DinoDubroja/Power-amplifier/PCB/Mains wiring/fuse holder.jpg

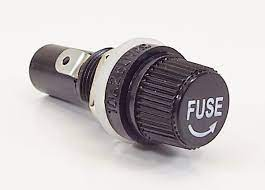
PCB/Mains wiring/fuse holder.jpg
