DinoDubroja/Power-amplifier/PCB/Mains wiring/panfh-1.webp

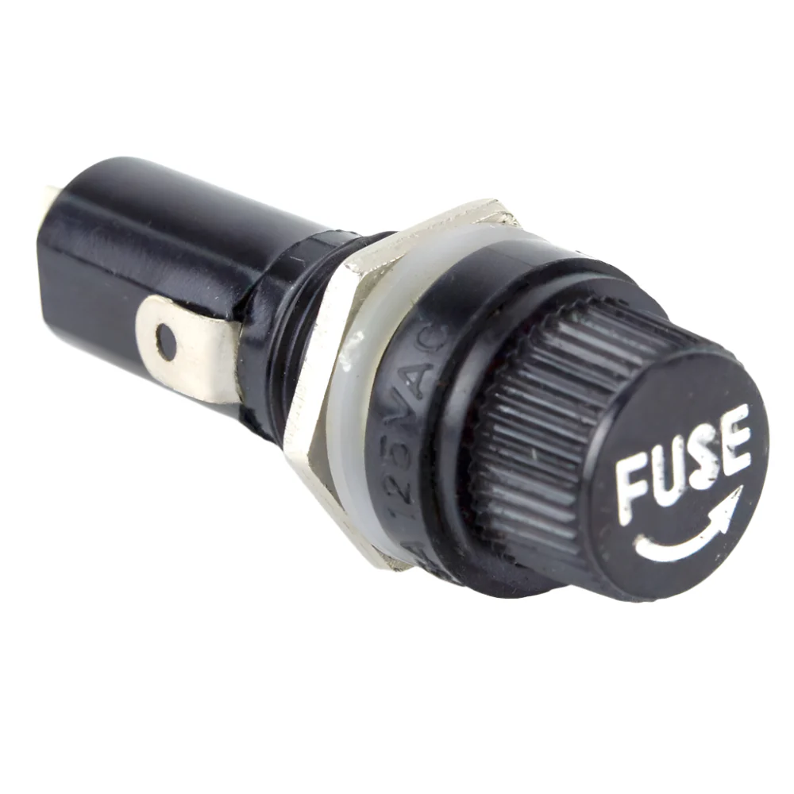
PCB/Mains wiring/panfh-1.webp
