DinoDubroja/Power-amplifier/README.md

# Power-amplifier
A general purpose power amplifier for lab use.
