DinoDubroja/Power-amplifier/PCB/Power supply/calculations.pdf

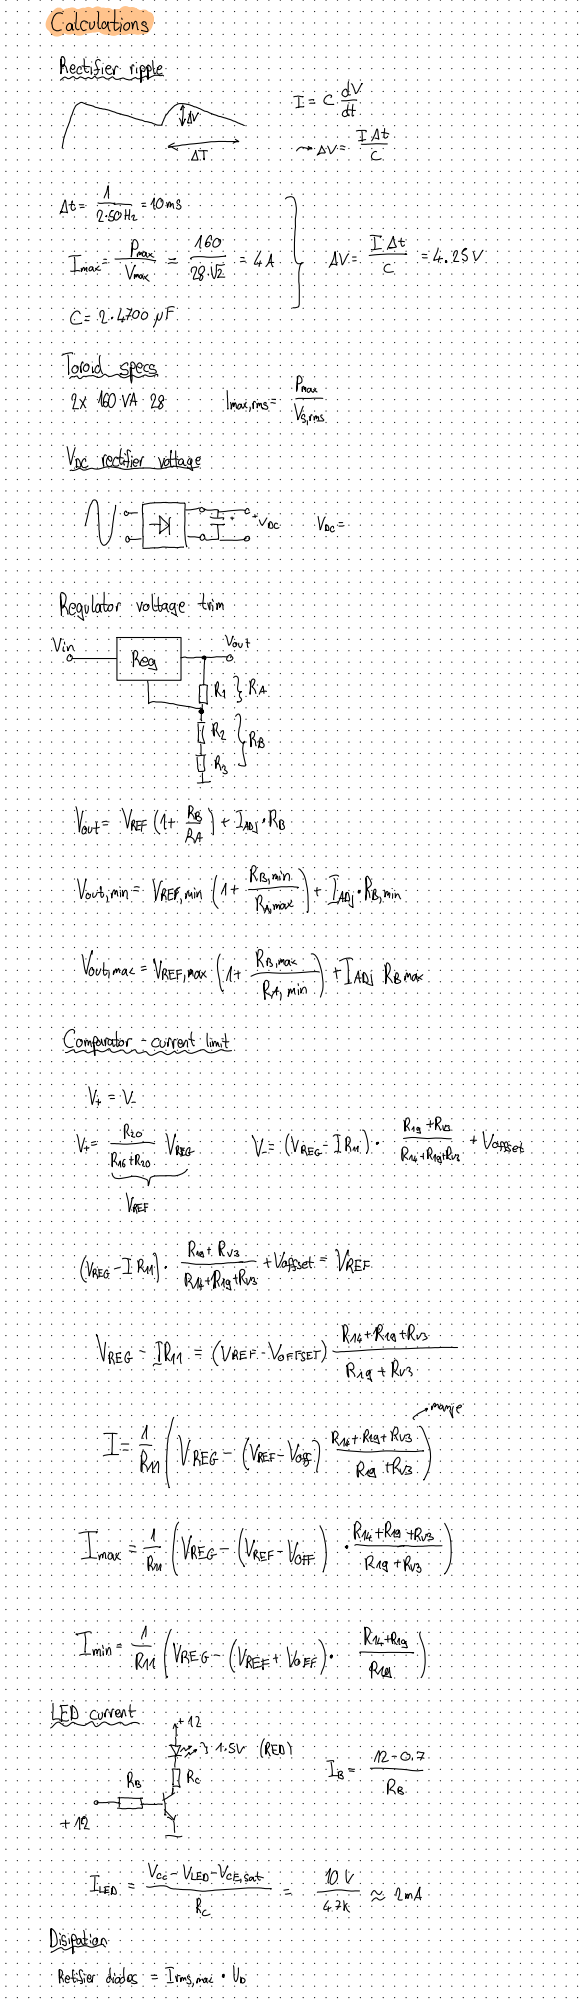
[picture p3: page 1]
