DinoDubroja/Power-amplifier/Mechanical/Drawings/front panel mat.jpeg

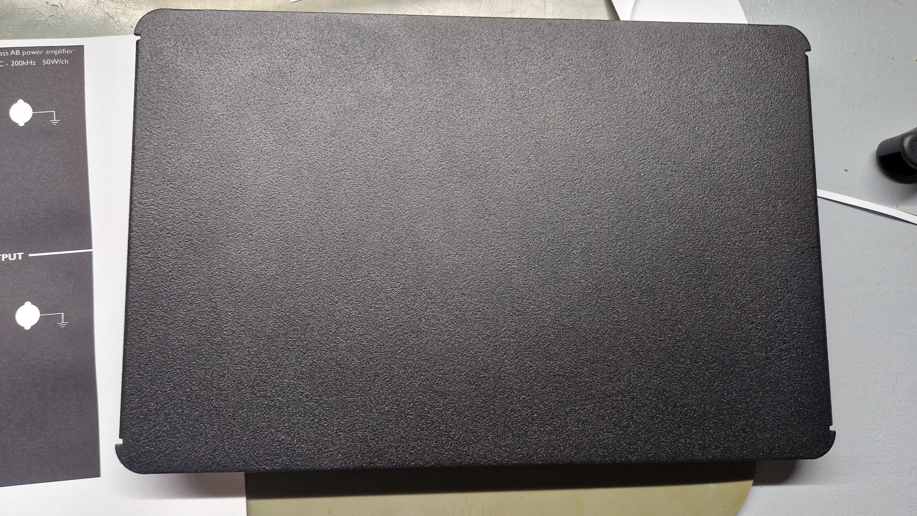
Mechanical/Drawings/front panel mat.jpeg
