DinoDubroja/Power-amplifier/PCB/Amplifier/AMPLIFIER - TRANSISTOR BLOCKS.png

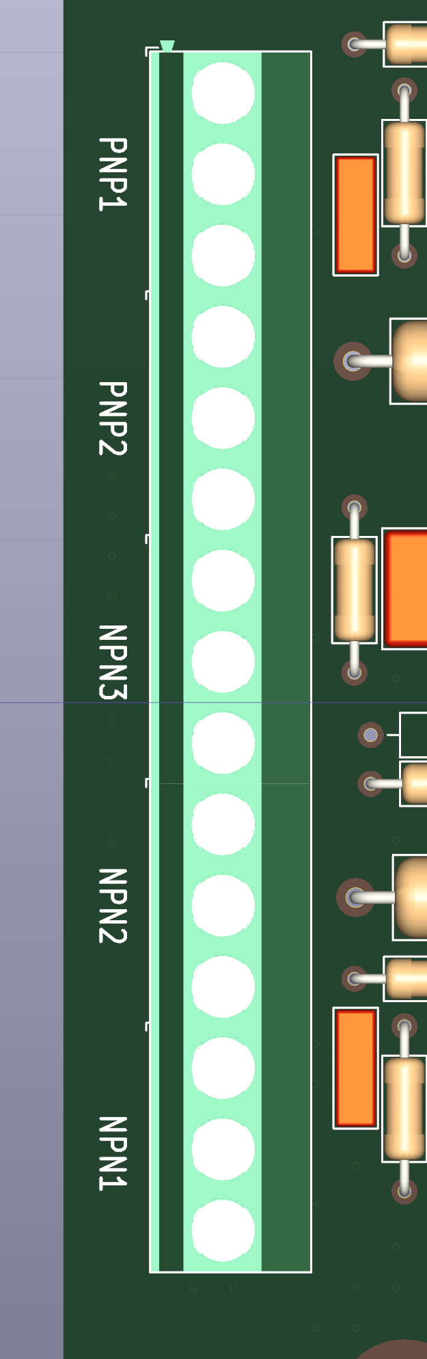
PCB/Amplifier/AMPLIFIER - TRANSISTOR BLOCKS.png
