DinoDubroja/Power-amplifier/PCB/Amplifier/BD139_140.jpg

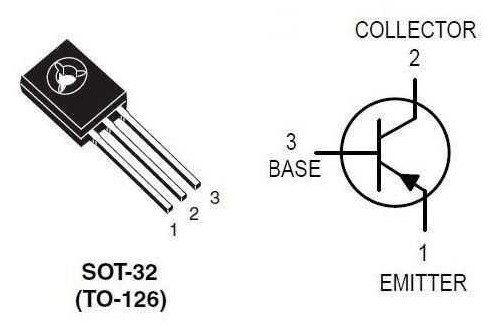
PCB/Amplifier/BD139_140.jpg
