DinoDubroja/Power-amplifier/PCB/Amplifier/FAN CONNECTOR.png

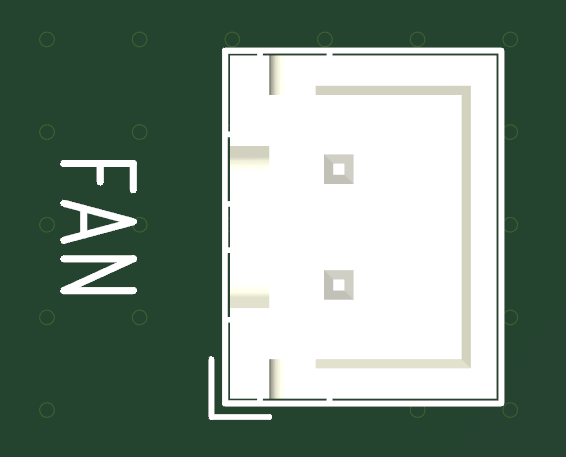
PCB/Amplifier/FAN CONNECTOR.png
