DinoDubroja/Power-amplifier/PCB/Amplifier/PSU - TRANSISTOR BLOCKS.png

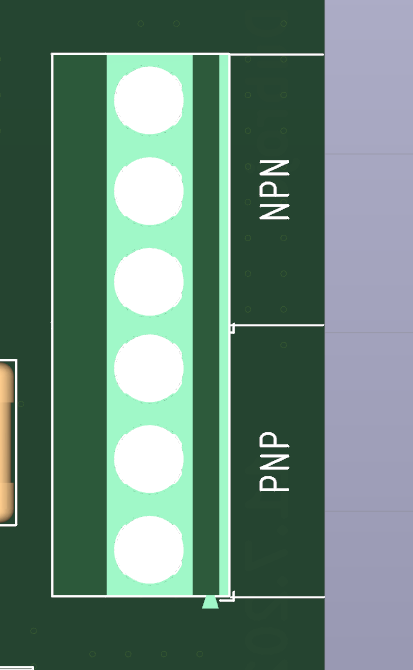
PCB/Amplifier/PSU - TRANSISTOR BLOCKS.png
