DinoDubroja/Power-amplifier/PCB/Amplifier/TIP35_36.png

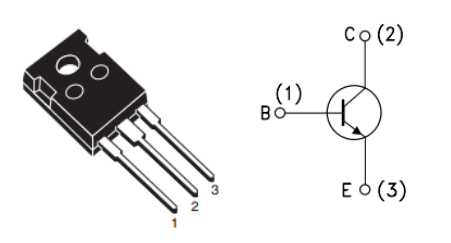
PCB/Amplifier/TIP35_36.png
