DinoDubroja/Power-amplifier/PCB/Amplifier/XHP-4.jpg

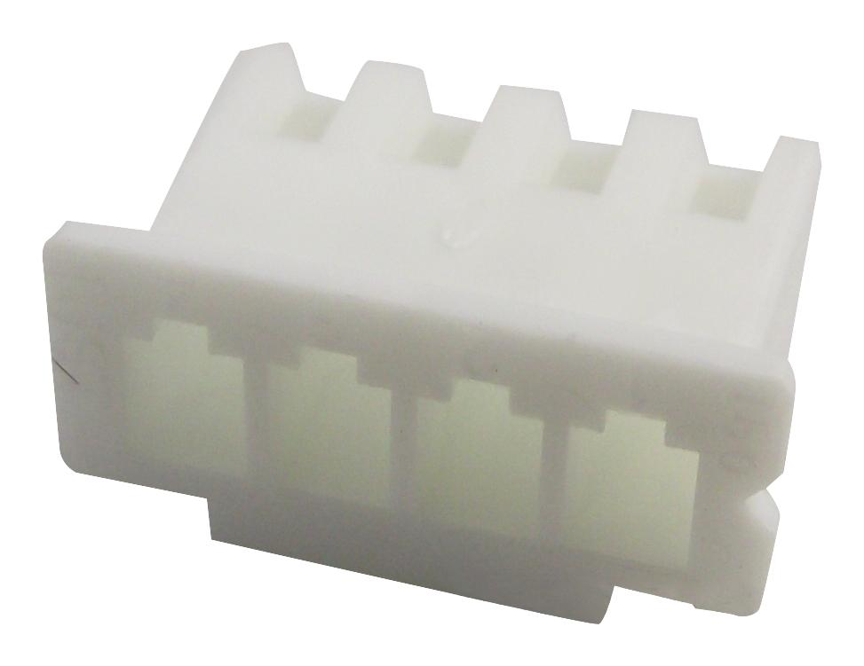
PCB/Amplifier/XHP-4.jpg
