DinoDubroja/Power-amplifier/Pictures/Amplifier BODE/Closed loop - TIP35_36.png

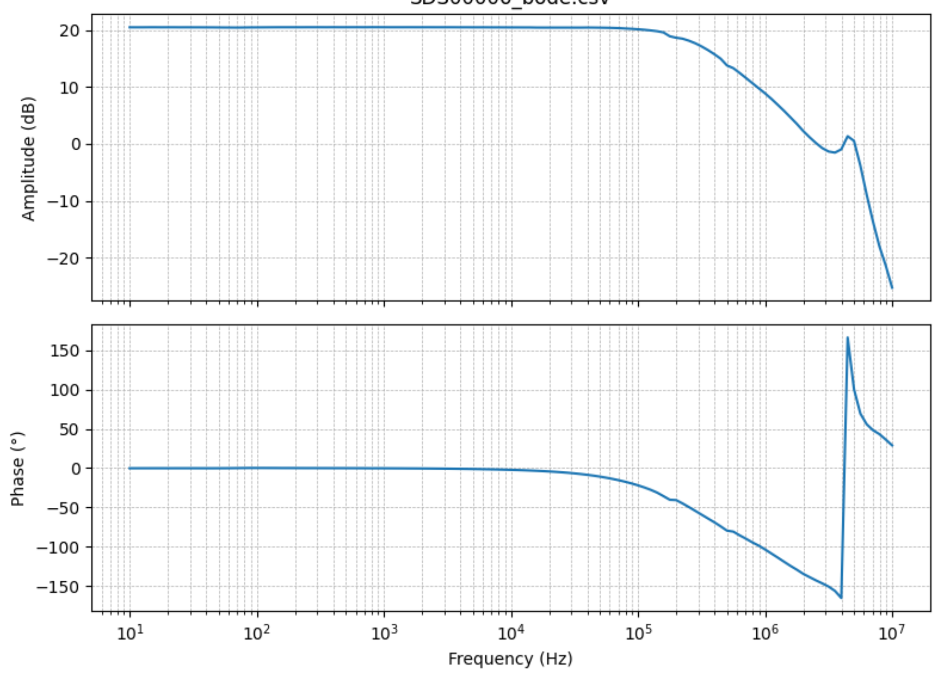
Pictures/Amplifier BODE/Closed loop - TIP35_36.png
