DinoDubroja/Power-amplifier/Pictures/circuit1.png

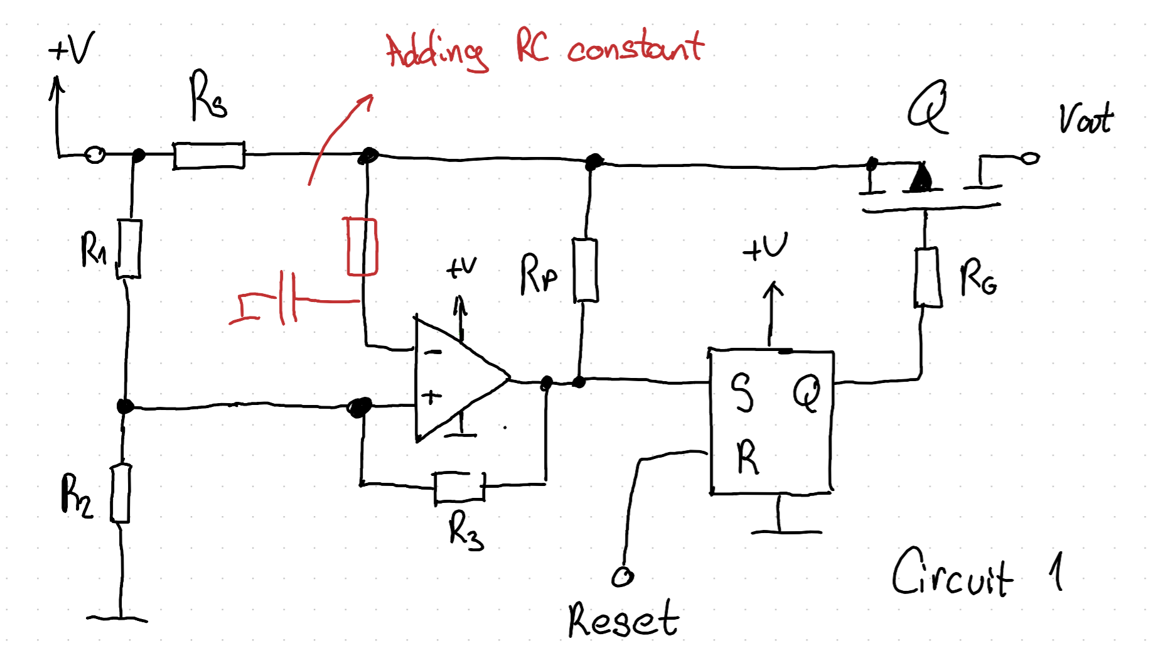
Pictures/circuit1.png
