DinoDubroja/Power-amplifier/Pictures/circuit1_values.png

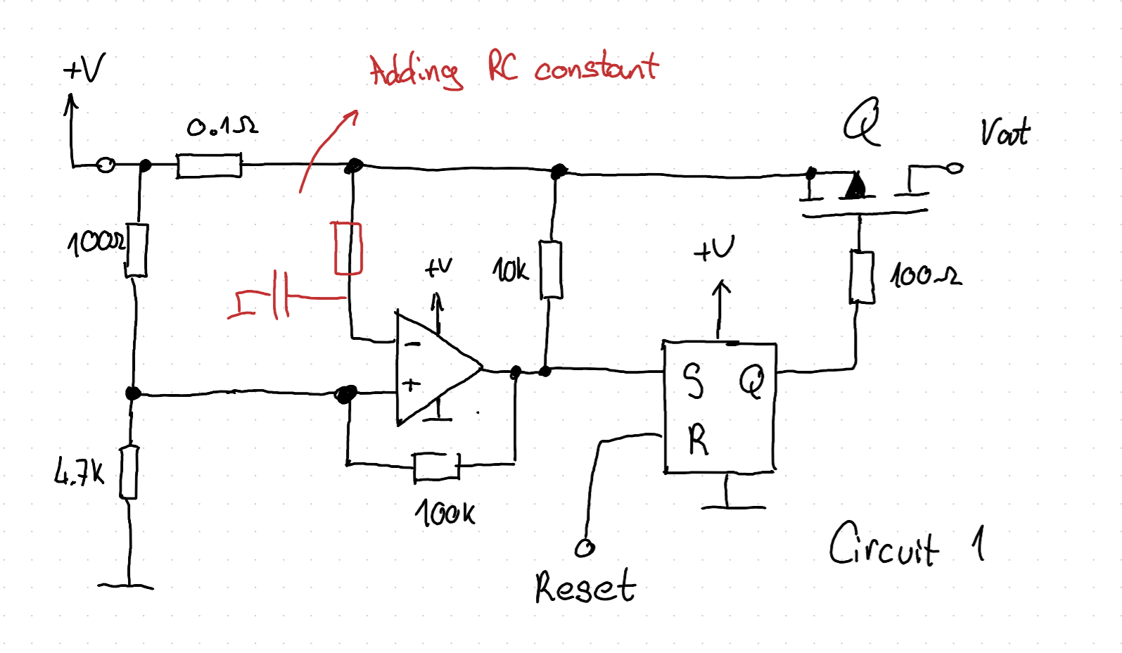
Pictures/circuit1_values.png
