DinoDubroja/Power-amplifier/Pictures/circuit2.png

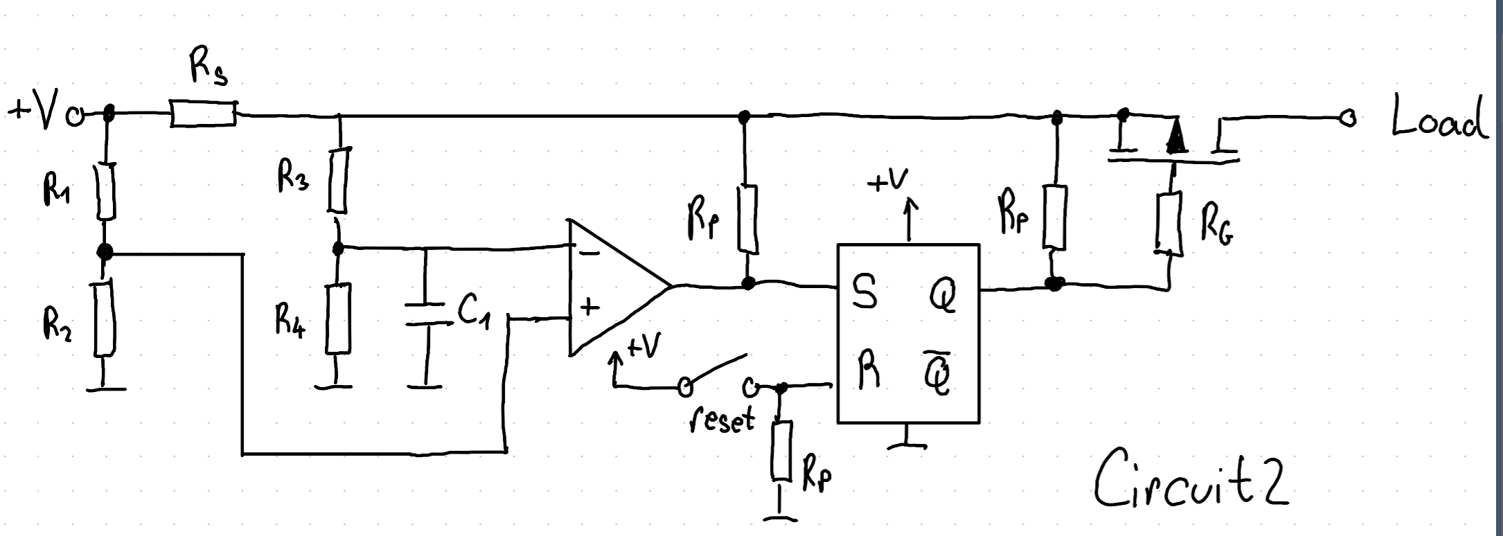
Pictures/circuit2.png
