DinoDubroja/Power-amplifier/Pictures/circuit2_values.png

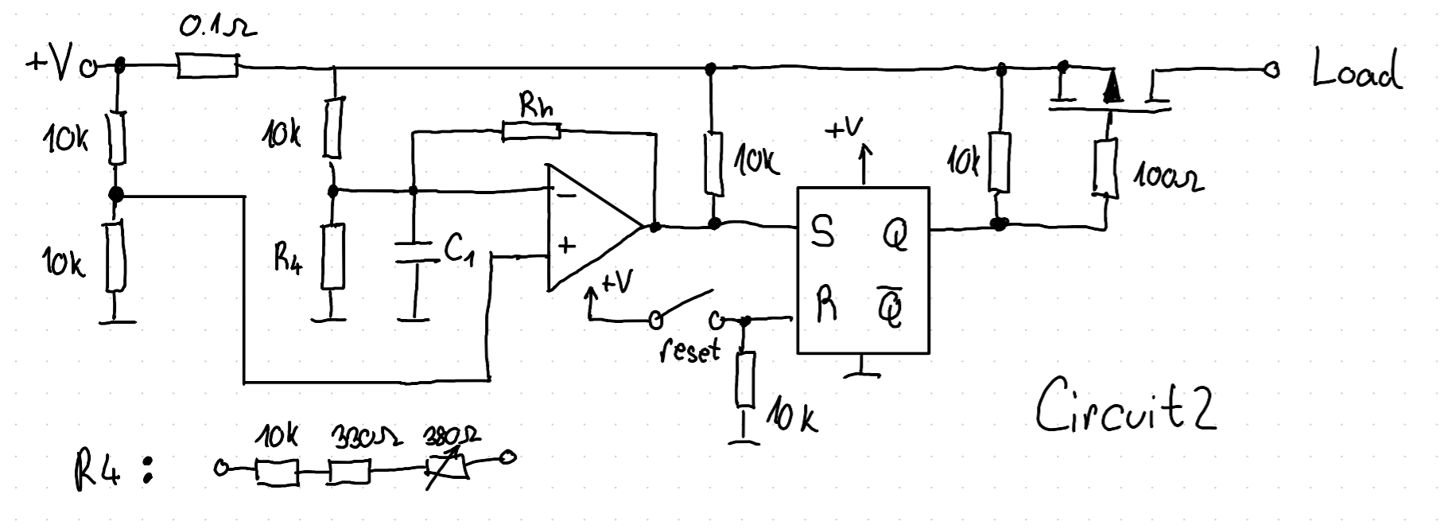
Pictures/circuit2_values.png
