DinoDubroja/Power-amplifier/Pictures/Enclosure - render1.png

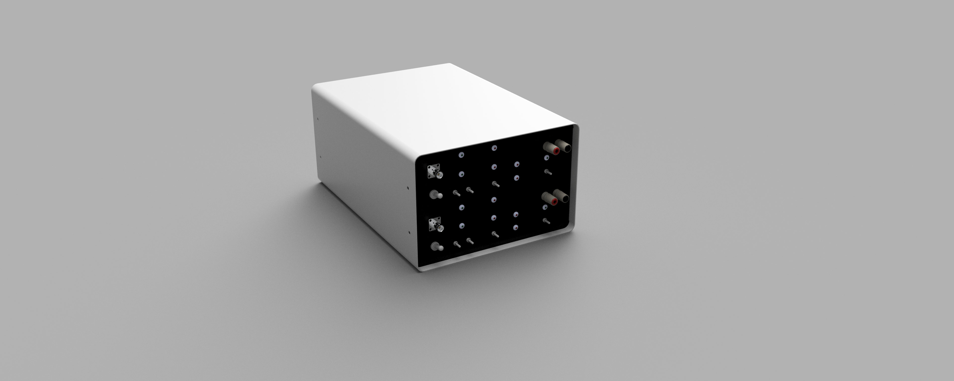
Pictures/Enclosure - render1.png
