DinoDubroja/Power-amplifier/Pictures/Enclosure - render 2.png

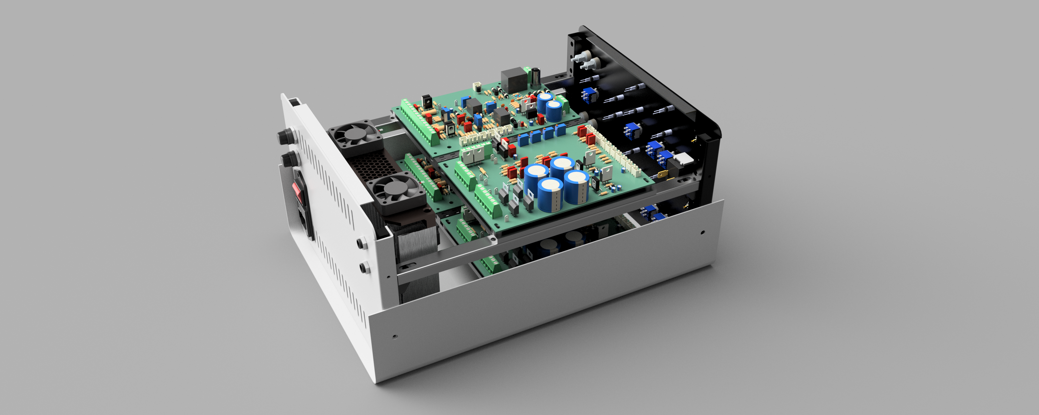
Pictures/Enclosure - render 2.png
