DinoDubroja/Power-amplifier/Pictures/regulator PCB.png

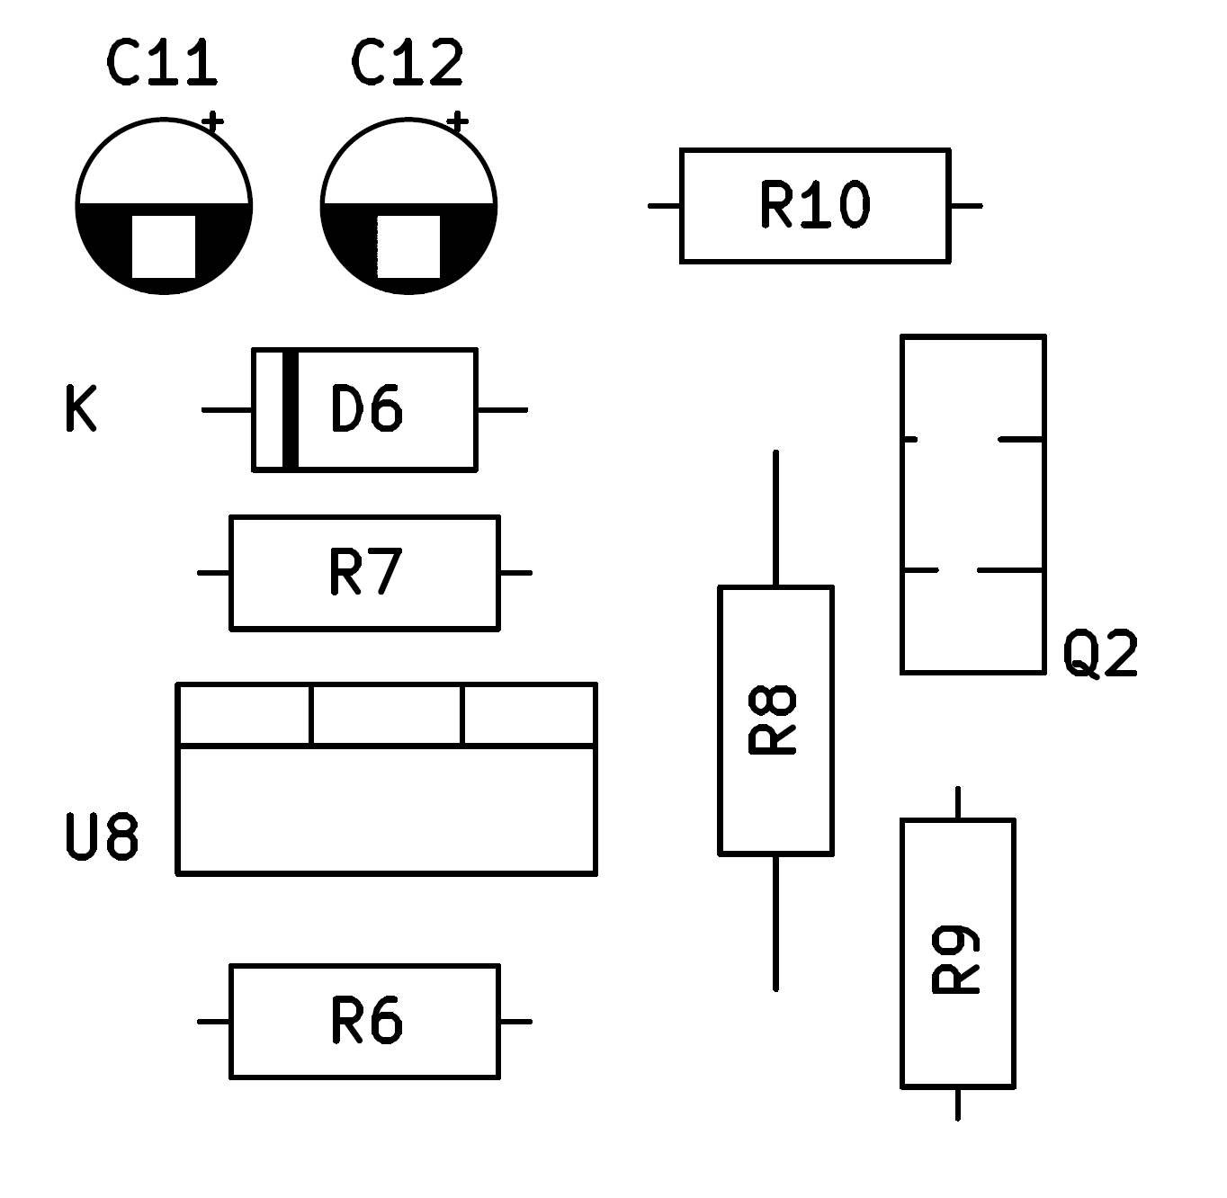
Pictures/regulator PCB.png
