DinoDubroja/Power-amplifier/Mechanical/3D printed parts/Mounting plate.3mf

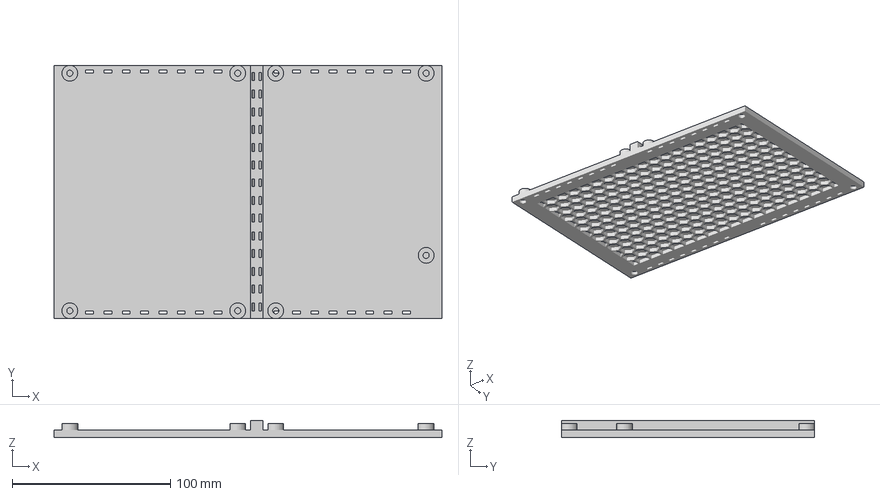
[picture p19: CAD file, 2025-10-12]
Mechanical/3D printed parts/Mounting plate.3mf
245.0 x 160.0 x 11.0 mm
