DinoDubroja/Power-amplifier/Mechanical/Drawings/front panel test.dxf

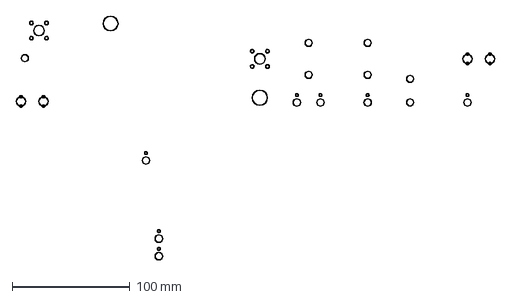
[picture p20: CAD file, 2025-10-12]
Mechanical/Drawings/front panel test.dxf
405.7 x 206.9 mm
