DinoDubroja/Power-amplifier/Mechanical/Models/10x-30a-high-current-m5-4mm-female-banana-jack-socket-test-binding-post-welding-plug-connector-1.snapshot.2/High Current M5 4mm Female Banana Jack.SLDPRT

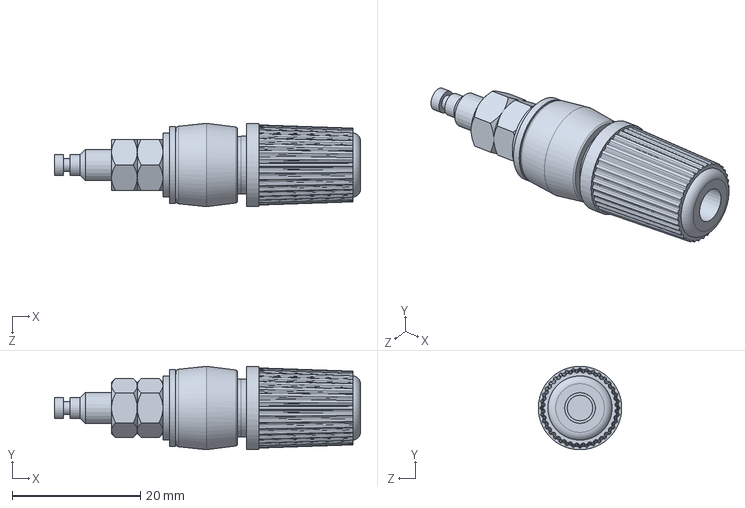
[picture p21: CAD file, 2025-10-12]
Mechanical/Models/10x-30a-high-current-m5-4mm-female-banana-jack-socket-test-binding-post-welding-plug-connector-1.snapshot.2/High Current M5 4mm Female Banana Jack.SLDPRT
47.7 x 13.0 x 13.0 mm
