DinoDubroja/Power-amplifier/Mechanical/Models/1427J/1427J.stp

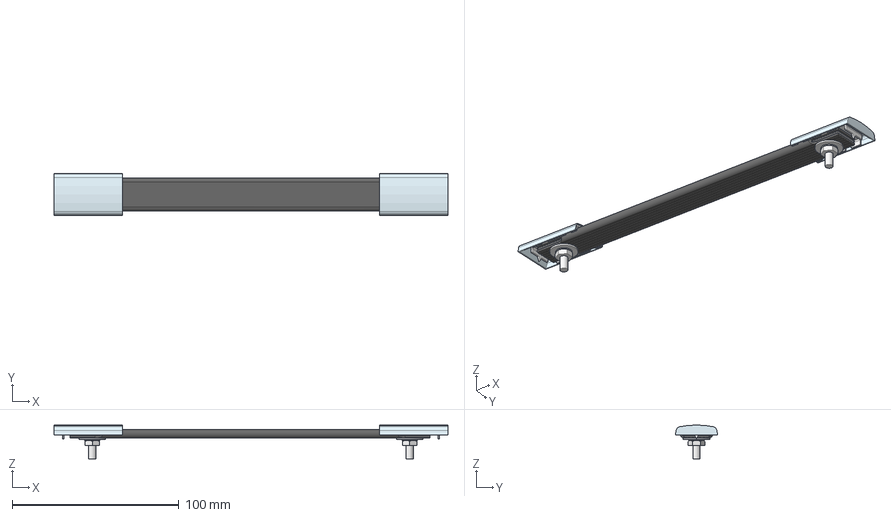
[picture p23: CAD file, 2025-10-12]
Mechanical/Models/1427J/1427J.stp
236.5 x 25.4 x 20.3 mm
1427J - core
1427J - vinyl
1427J - insert x 2
washer2 x 2
lockwasher2 x 2
8-32 nut x 2
1427J - cover x 2
