DinoDubroja/Power-amplifier/Mechanical/Models/Busbar.step

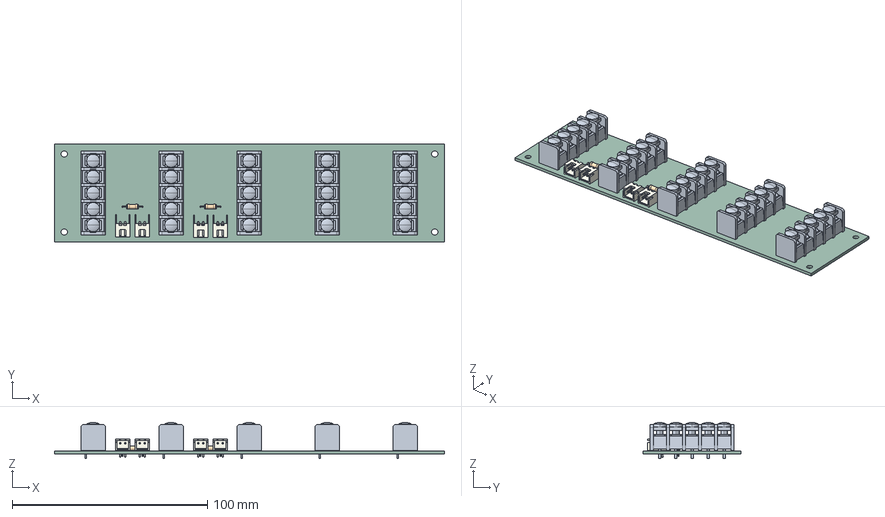
[picture p24: CAD file, 2025-10-12]
Mechanical/Models/Busbar.step
200.0 x 50.0 x 18.5 mm
R_Axial_DIN0207_L63mm_D25mm_P1016mm_Horizontal x 2
C-2-1437667-8 x 5
JST_S2B_XH_A_1 x 4
Busbar_PCB
