DinoDubroja/Power-amplifier/Mechanical/Models/LIB_031-203-RFX/031-203-RFX/3D/031-203-RFX.stp

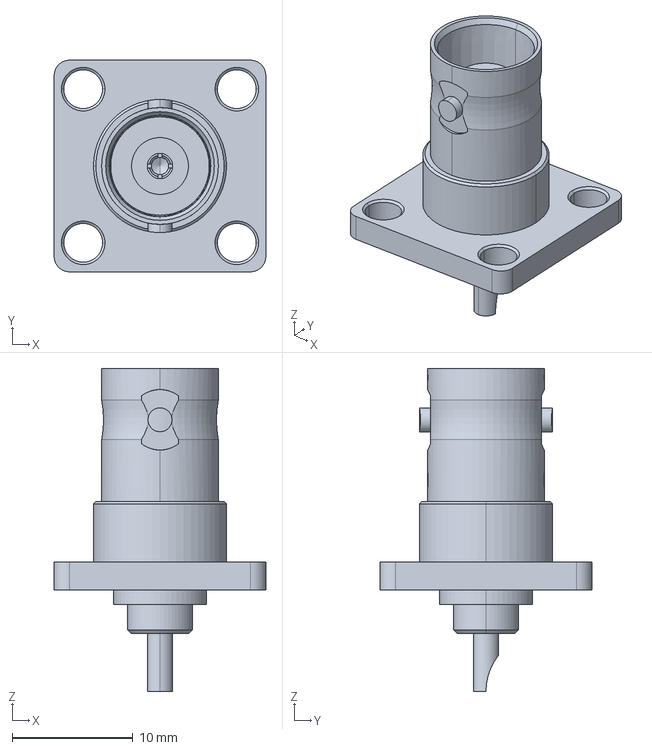
[picture p25: CAD file, 2025-10-12]
Mechanical/Models/LIB_031-203-RFX/031-203-RFX/3D/031-203-RFX.stp
17.5 x 17.5 x 26.7 mm
