DinoDubroja/Power-amplifier/Mechanical/Models/LIB_4DB-P108-05/4DB-P108-05/3D/4DB-P108-05.stp

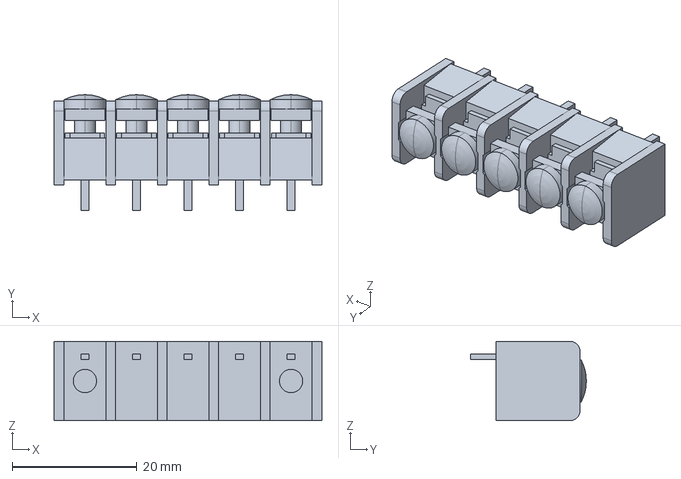
[picture p26: CAD file, 2025-10-12]
Mechanical/Models/LIB_4DB-P108-05/4DB-P108-05/3D/4DB-P108-05.stp
42.9 x 18.5 x 12.7 mm
