DinoDubroja/Power-amplifier/Mechanical/Models/LIB_H-83P/H-83P/3D/H-83P.stp

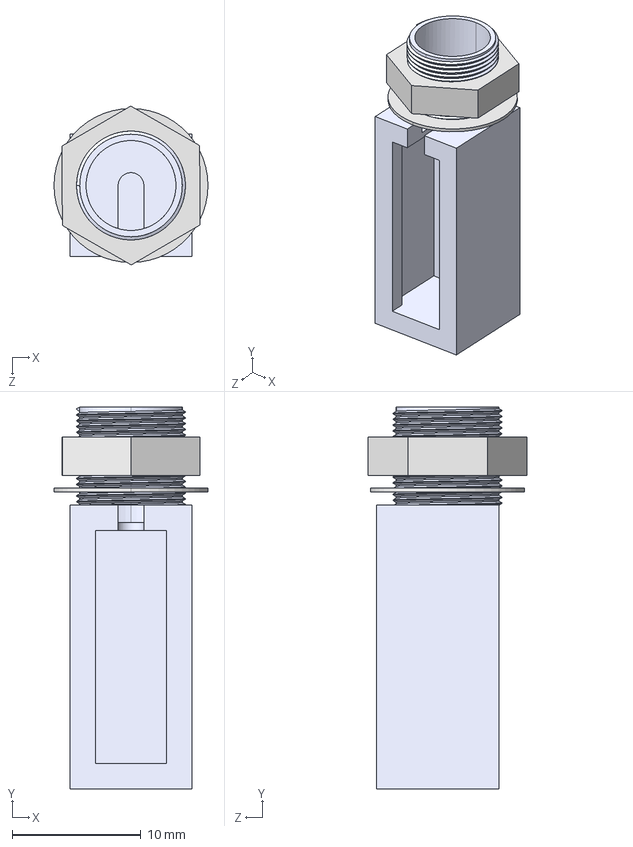
[picture p27: CAD file, 2025-10-12]
Mechanical/Models/LIB_H-83P/H-83P/3D/H-83P.stp
12.0 x 29.7 x 12.4 mm
