DinoDubroja/Power-amplifier/Mechanical/Models/LIB_MPC3BWD/MPC3BWD/3D/MPC3BWD.stp

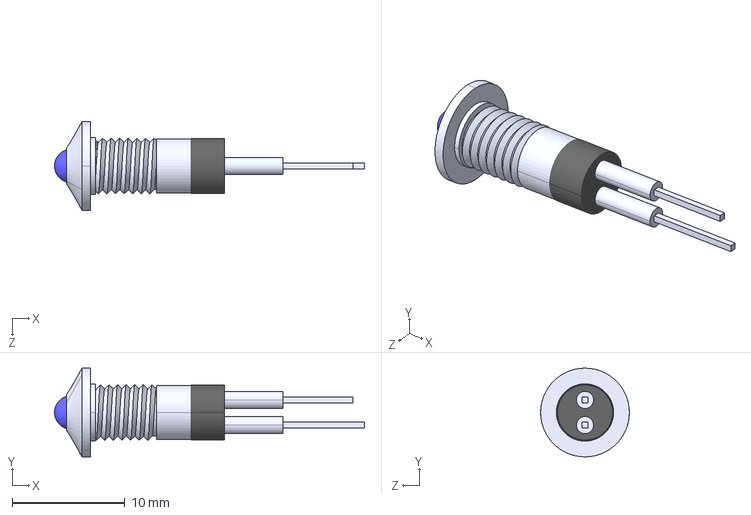
[picture p28: CAD file, 2025-10-12]
Mechanical/Models/LIB_MPC3BWD/MPC3BWD/3D/MPC3BWD.stp
27.5 x 7.87 x 7.87 mm
