DinoDubroja/Power-amplifier/Mechanical/Models/LIB_R3-12-12-B/R3-12-12-B/3D/R3-12-12-B.stp

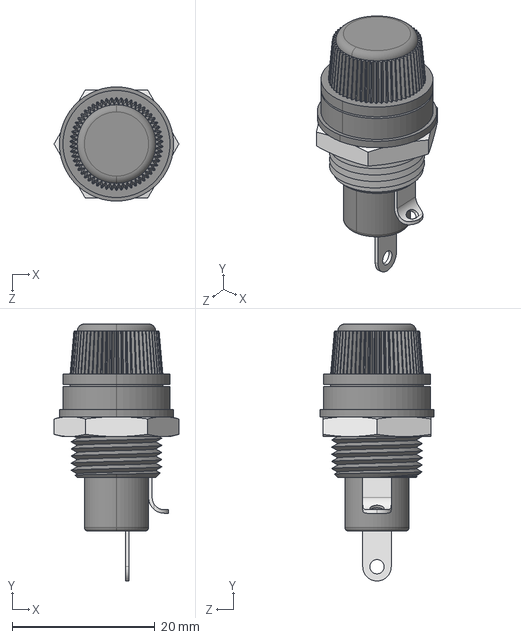
[picture p29: CAD file, 2025-10-12]
Mechanical/Models/LIB_R3-12-12-B/R3-12-12-B/3D/R3-12-12-B.stp
17.5 x 36.0 x 16.0 mm
