DinoDubroja/Power-amplifier/Mechanical/Models/LIB_SW-T2-3A-A-A2-M2/SW-T2-3A-A-A2-M2/3D/SW-T2-3A-A-A2-M2.stp

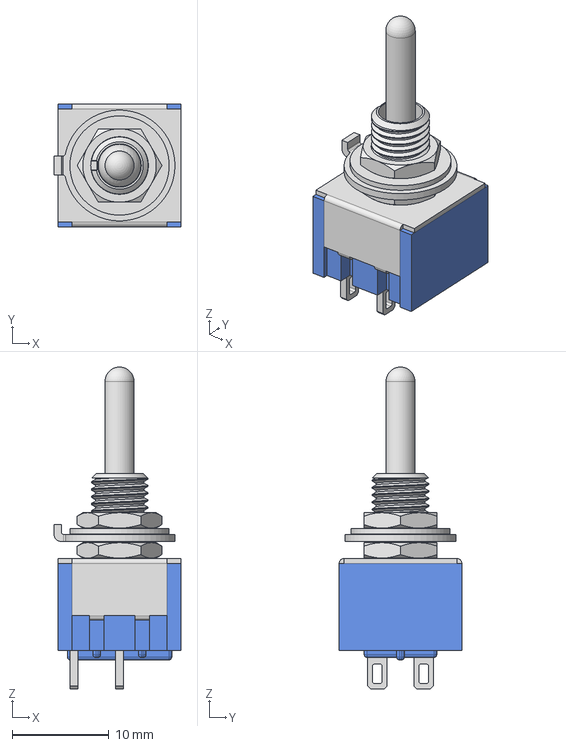
[picture p30: CAD file, 2025-10-12]
Mechanical/Models/LIB_SW-T2-3A-A-A2-M2/SW-T2-3A-A-A2-M2/3D/SW-T2-3A-A-A2-M2.stp
13.1 x 12.7 x 33.3 mm
