DinoDubroja/Power-amplifier/PCB/Amplifier/Amplifier/Amplifier.step

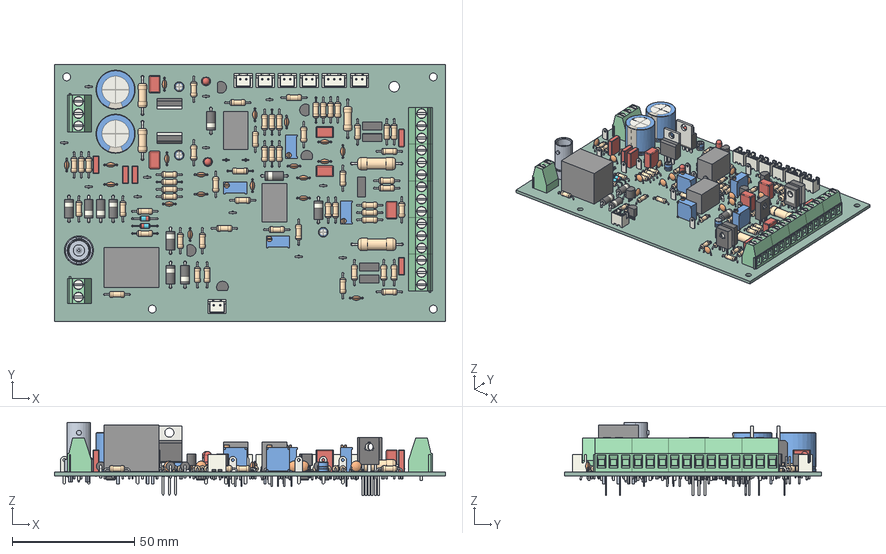
[picture p31: CAD file, 2025-10-12]
PCB/Amplifier/Amplifier/Amplifier.step
160.0 x 105.0 x 30.0 mm
JST_B2B_XH_A x 6
Potentiometer_Bourns_3296W_Vertical x 4
R_Axial_DIN0207_L63mm_D25mm_P1016mm_Horizontal x 56
C_Disc_D43mm_W19mm_P500mm x 19
LED_D3.0mm x 2
C_Rect_L72mm_W25mm_P500mm_FKS2_FKP2_MKS2_MKP2 x 5
TO-126-3_Vertical x 5
D_DO-15_P10.16mm_Horizontal x 10
D_DO-35_SOD27_P10.16mm_Horizontal x 2
C_Rect_L72mm_W45mm_P500mm_FKS2_FKP2_MKS2_MKP2 x 5
TerminalBlock_Phoenix_MKDS_15_3_1x03_P500mm_Horizontal x 6
ASSEMBLY x 3
Pin_d1.2mm_L11.3mm_W3.0mm_Flat x 14
TO-92_Inline_Narrow x 5
R_Axial_DIN0516_L155mm_D50mm_P2032mm_Horizontal x 2
TO-220-3_Vertical x 2
C-5222006-01-3
TerminalBlock_Phoenix_MKDS_15_2_508_1x02_P508mm_Horizontal
CP_Radial_D160mm_P750mm x 2
JST_B3B_XH_A
CP_Radial_D40mm_P200mm x 3
R_Axial_DIN0411_L99mm_D36mm_P1524mm_Horizontal x 3
D0008A_ASM x 3
SOIC_8_39x49mm_P127mm
Amplifier_PCB
