DinoDubroja/Power-amplifier/PCB/Power supply/Power supply/Power supply.step

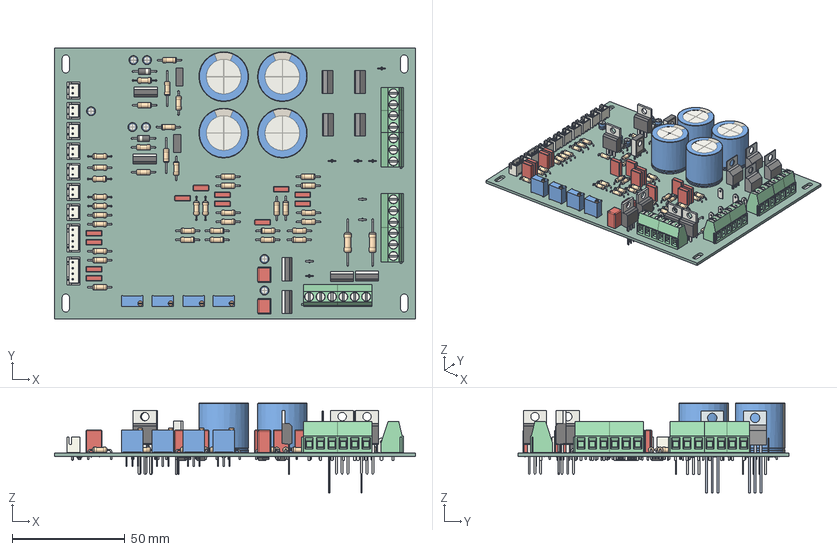
[picture p32: CAD file, 2025-10-12]
PCB/Power supply/Power supply/Power supply.step
160.0 x 120.0 x 39.8 mm
R_Axial_DIN0207_L63mm_D25mm_P1016mm_Horizontal x 38
CP_Radial_D40mm_P200mm x 7
Potentiometer_Bourns_3296W_Vertical x 4
C_Rect_L70mm_W60mm_P500mm x 2
TerminalBlock_Phoenix_MKDS_15_3_508_1x03_P508mm_Horizontal x 5
Pin_d1.3mm_L10.0mm_W3.5mm_Flat x 8
JST_B4B_XH_A x 2
C_Rect_L70mm_W25mm_P500mm x 12
TO-220-3_Vertical x 6
D_A-405_P10.16mm_Horizontal x 2
CP_Radial_D220mm_P1000mm_SnapIn x 4
JST_B2B_XH_A x 7
R_Axial_DIN0207_L63mm_D25mm_P1524mm_Horizontal x 2
ASSEMBLY x 4
R_Axial_DIN0309_L90mm_D32mm_P2032mm_Horizontal x 2
TO-126-3_Vertical x 2
TerminalBlock_Phoenix_MKDS_15_2_508_1x02_P508mm_Horizontal x 2
D0014A_ASM x 2
SOT_23 x 4
SOIC_8_39x49mm_P127mm x 2
Power supply_PCB
