DinoDubroja/Power-amplifier/Mechanical/3D printed parts/THERMAL FUSE HOLDER.3mf

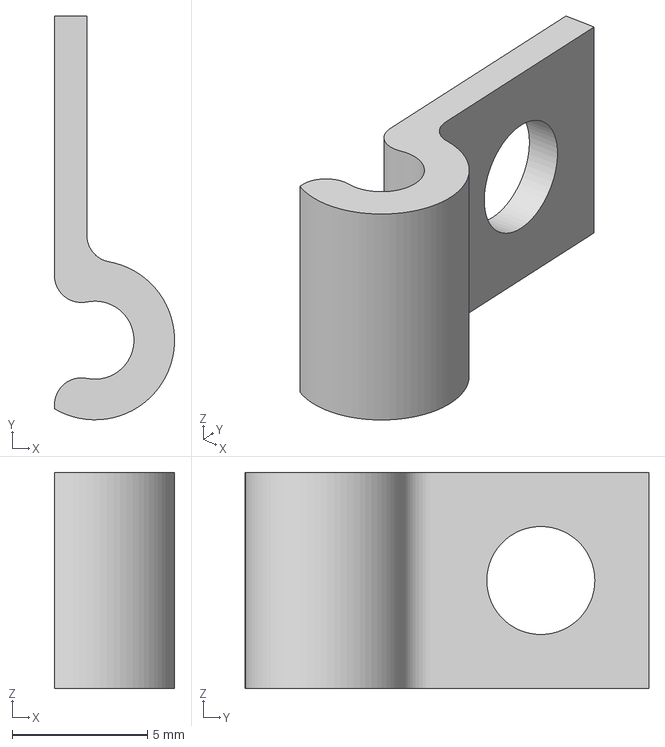
[picture p33: CAD file, 2025-10-12]
Mechanical/3D printed parts/THERMAL FUSE HOLDER.3mf
4.45 x 14.9 x 8.00 mm
