DinoDubroja/Power-amplifier/Mechanical/Drawings/front panel.dxf

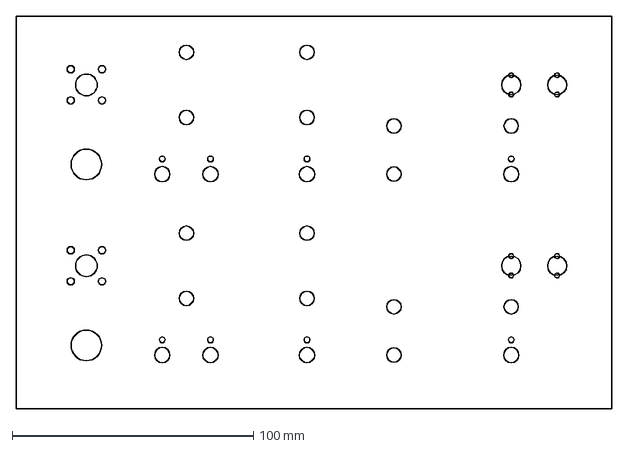
[picture p34: CAD file, 2025-10-12]
Mechanical/Drawings/front panel.dxf
246.7 x 162.7 mm
