DinoDubroja/Power-amplifier/Mechanical/Models/1401K/1401K - Vented Panel.stp

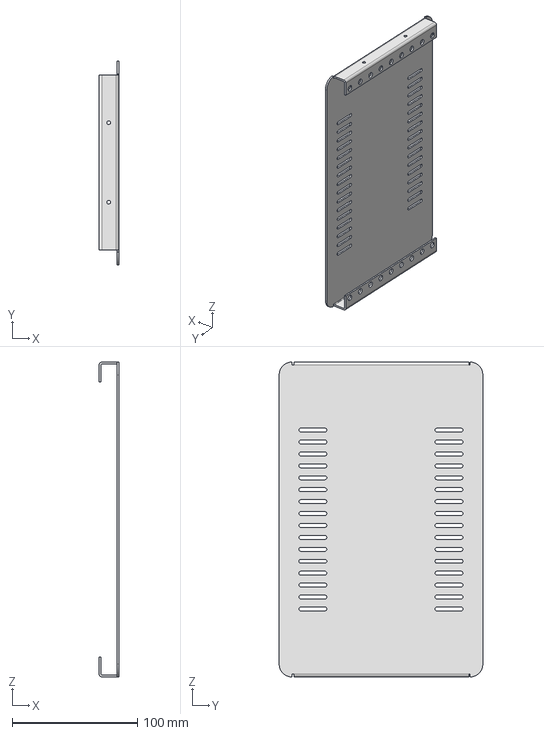
[picture p35: CAD file, 2025-10-12]
Mechanical/Models/1401K/1401K - Vented Panel.stp
15.9 x 162.7 x 251.6 mm
