DinoDubroja/Power-amplifier/Mechanical/Models/2GK51-73.stp

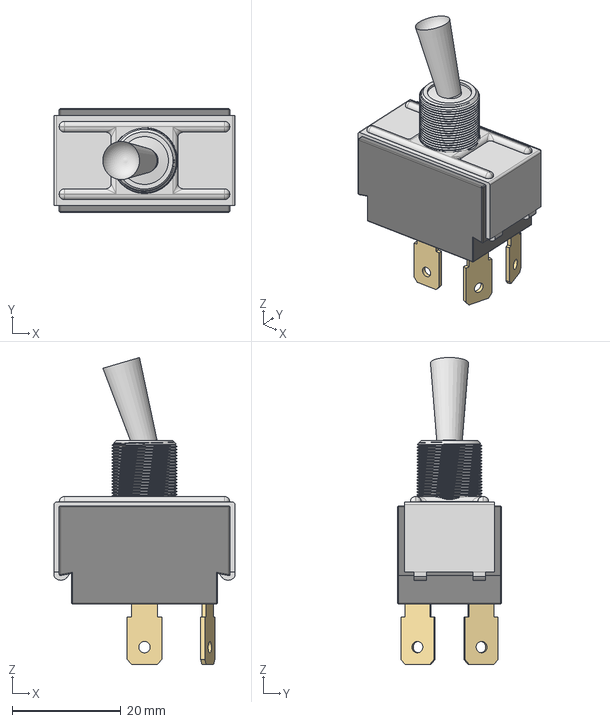
[picture p36: CAD file, 2025-07-30]
Mechanical/Models/2GK51-73.stp
33.2 x 19.1 x 56.4 mm
