DinoDubroja/Power-amplifier/Mechanical/3D printed parts/Rubber feet.3mf

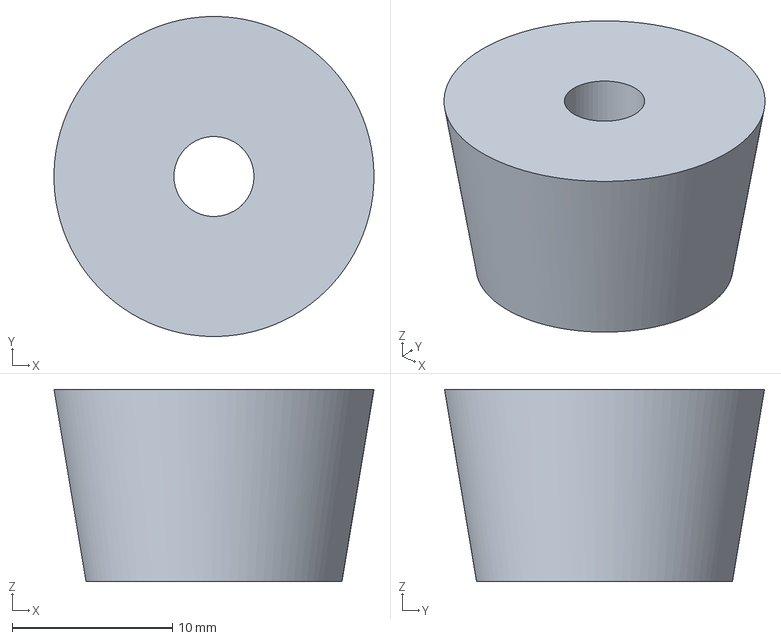
[picture p37: CAD file, 2025-10-12]
Mechanical/3D printed parts/Rubber feet.3mf
20.0 x 20.0 x 12.0 mm
