DinoDubroja/Power-amplifier/Mechanical/Models/082.01001.00-RSI.stp

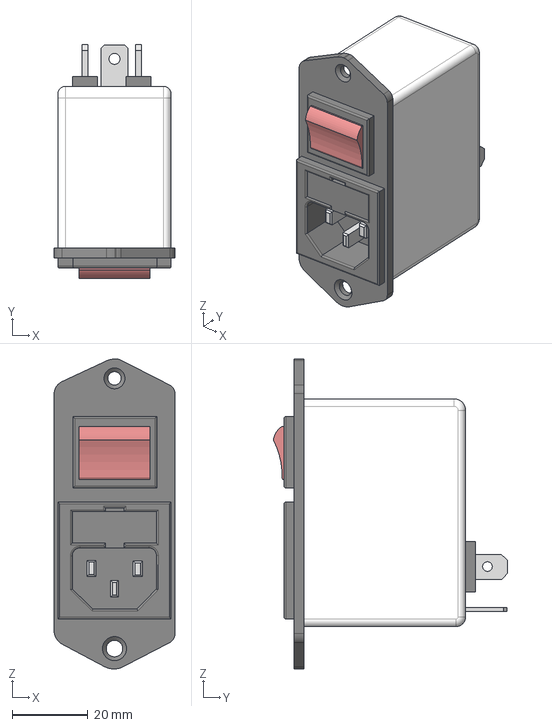
[picture p38: CAD file, 2025-07-29]
Mechanical/Models/082.01001.00-RSI.stp
32.0 x 62.0 x 82.0 mm
