DinoDubroja/Power-amplifier/Mechanical/Models/1401K/1401K.stp

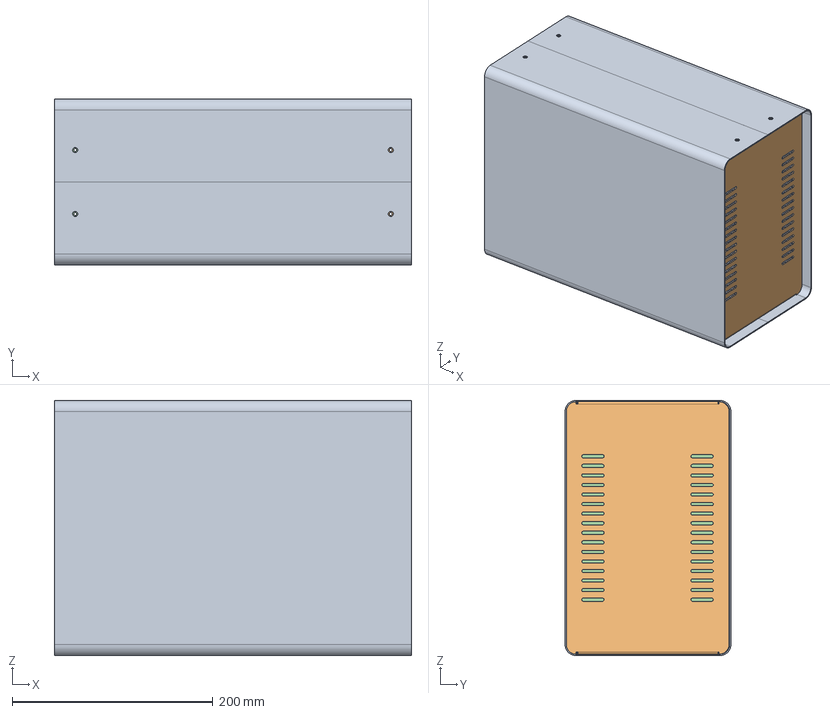
[picture p39: CAD file, 2025-10-12]
Mechanical/Models/1401K/1401K.stp
355.6 x 165.1 x 254.0 mm
1401K - Bottom Cover
1401K - Top Cover
1401K - Vented Panel
1401K - Bracket x 4
1401K - End Panel
