DinoDubroja/Power-amplifier/Mechanical/3D printed parts/bracket.3mf

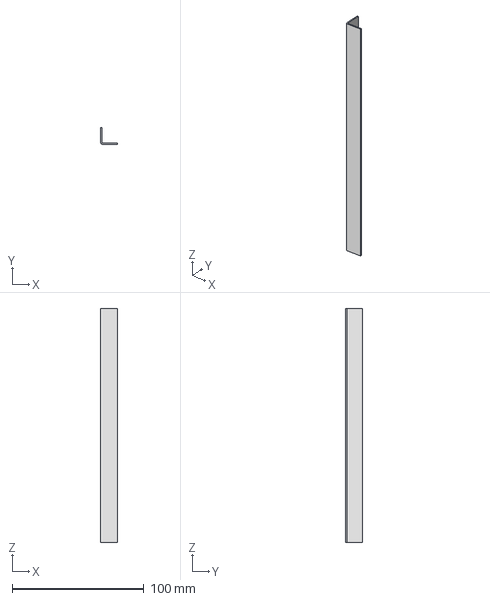
[picture p40: CAD file, 2025-10-12]
Mechanical/3D printed parts/bracket.3mf
12.7 x 12.7 x 177.8 mm
