DinoDubroja/Power-amplifier/Mechanical/Models/40x40x10 DC Fan.STEP

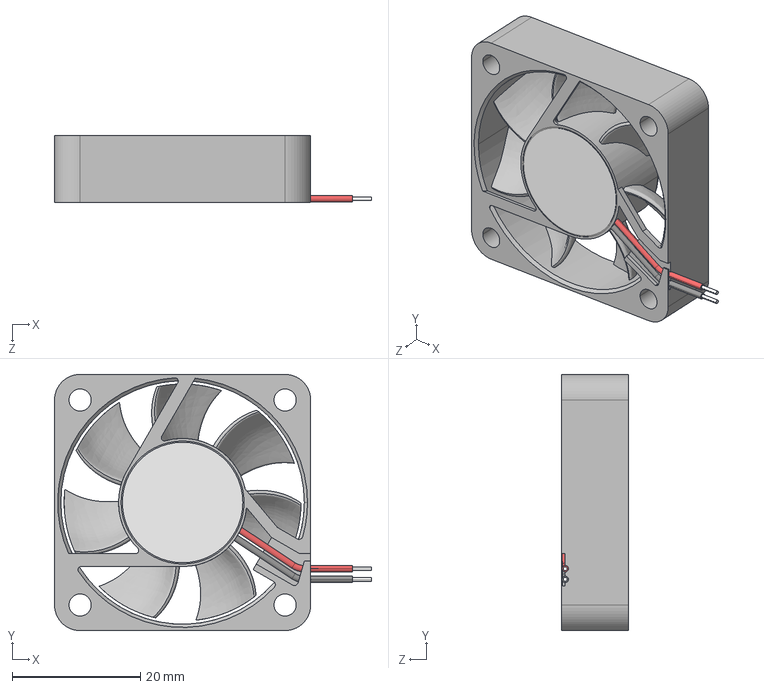
[picture p41: CAD file, 2025-07-29]
Mechanical/Models/40x40x10 DC Fan.STEP
49.5 x 40.0 x 10.5 mm
