DinoDubroja/Power-amplifier/Mechanical/3D printed parts/fan holder.3mf

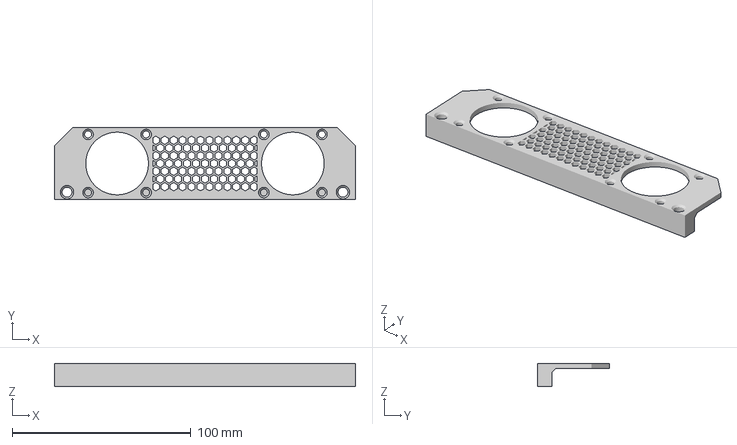
[picture p42: CAD file, 2025-08-28]
Mechanical/3D printed parts/fan holder.3mf
168.2 x 40.0 x 13.0 mm
