DinoDubroja/Power-amplifier/Mechanical/Models/1401K/1401K - Top Cover.stp

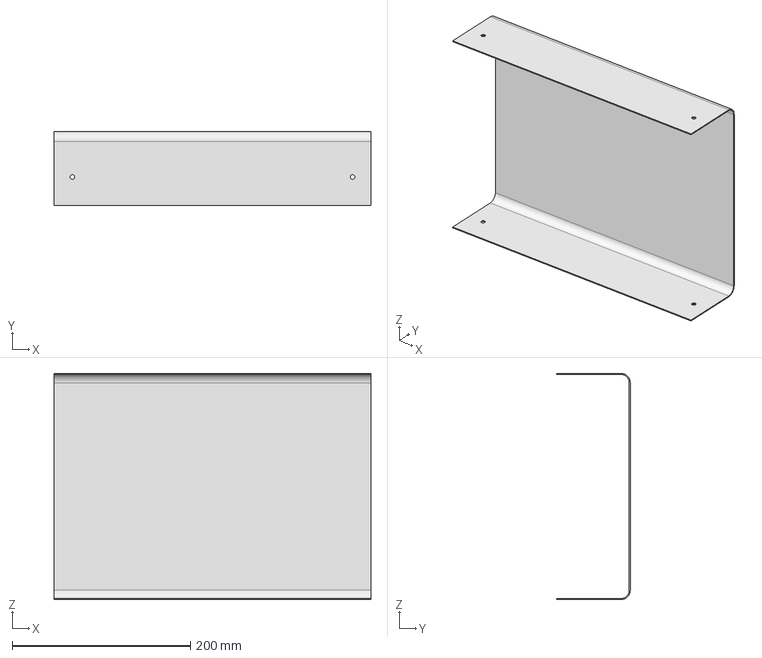
[picture p43: CAD file, 2025-10-12]
Mechanical/Models/1401K/1401K - Top Cover.stp
355.6 x 82.6 x 254.0 mm
