DinoDubroja/Power-amplifier/Mechanical/Models/Infineon-STP_PG-TO247-3-901-P-v01_00-EN.stp

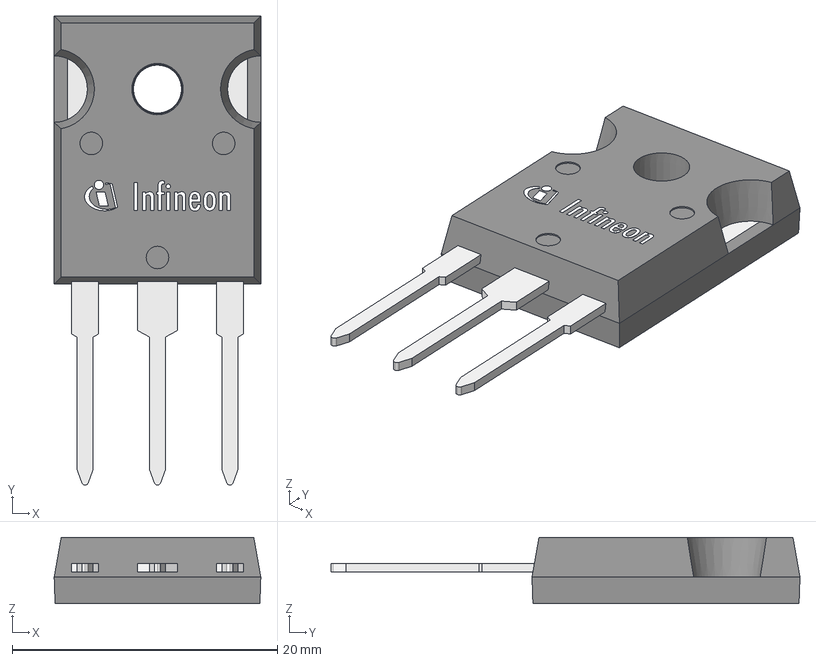
[picture p44: CAD file, 2025-07-14]
Mechanical/Models/Infineon-STP_PG-TO247-3-901-P-v01_00-EN.stp
15.6 x 35.4 x 4.99 mm
