DinoDubroja/Power-amplifier/Mechanical/3D printed parts/project.3mf

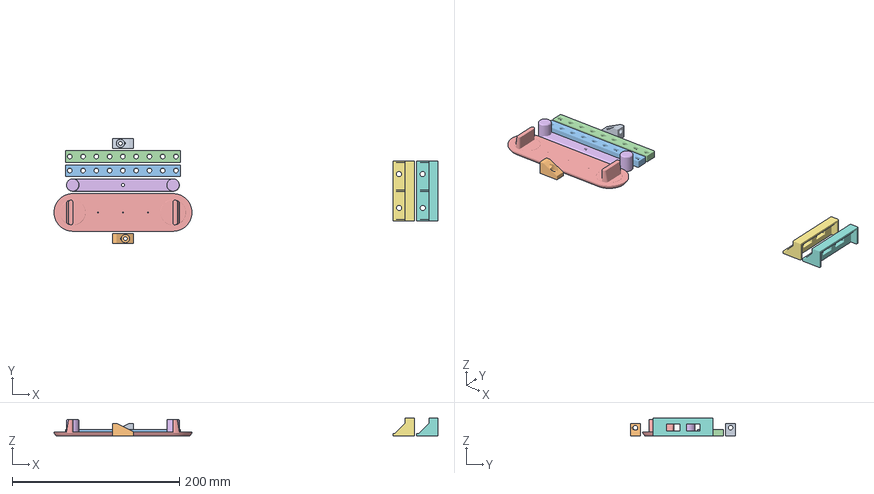
[picture p45: CAD file, 2025-07-14]
Mechanical/3D printed parts/project.3mf
459.3 x 125.9 x 21.5 mm
Corner
Mounting insert
120mm-cf-v2.stl
center_finder_100mm_wuerth_va221024.stl
tp-link_uh720_bracket_8040_leftside.stl
