DinoDubroja/Power-amplifier/Mechanical/Models/SOT32.step

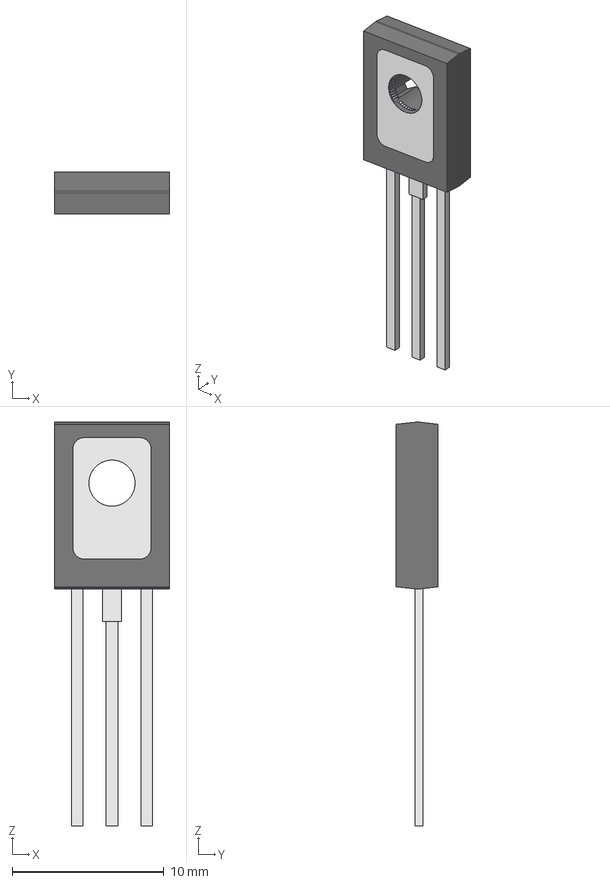
[picture p46: CAD file, 2025-07-14]
Mechanical/Models/SOT32.step
7.60 x 2.75 x 26.6 mm
