DinoDubroja/Power-amplifier/Mechanical/3D printed parts/Corner.3mf

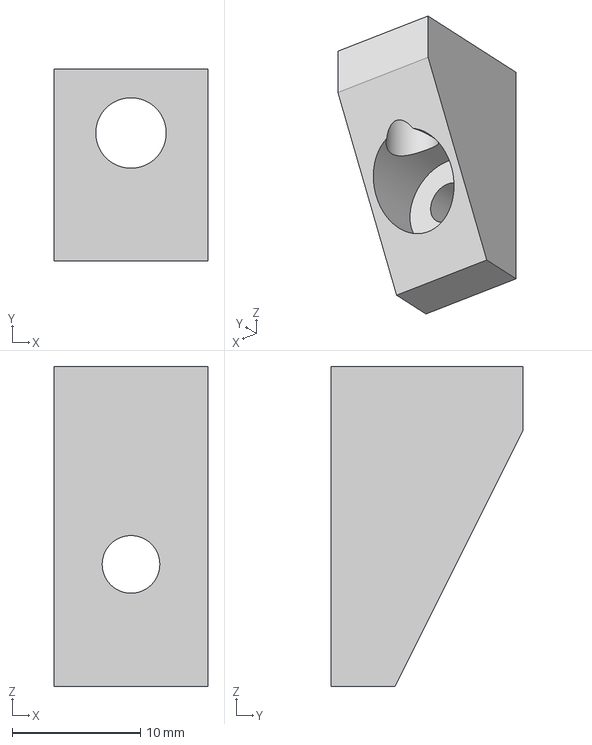
[picture p47: CAD file, 2025-07-14]
Mechanical/3D printed parts/Corner.3mf
12.0 x 15.0 x 25.0 mm
