DinoDubroja/Power-amplifier/Mechanical/3D printed parts/Mounting insert.3mf

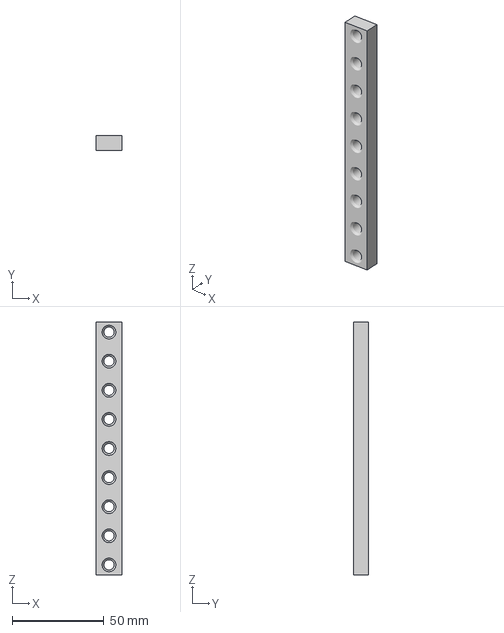
[picture p48: CAD file, 2025-07-14]
Mechanical/3D printed parts/Mounting insert.3mf
14.0 x 8.00 x 138.0 mm
