DinoDubroja/Power-amplifier/(list of files, cad)

Other CAD files:
Mechanical/Models/1401K/1401K - Bracket.stp
Mechanical/Models/1401K/1401K - Bottom Cover.stp
Mechanical/Models/1401K/1401K - Bottom Cover.igs
Mechanical/Models/1401K/1401K - Bracket.igs
Mechanical/Models/1401K/1401K - End Panel.igs
Mechanical/Models/1401K/1401K - Top Cover.igs
Mechanical/Models/1401K/1401K - Vented Panel.igs
Mechanical/Models/1401K/1401K.igs
Mechanical/Models/LIB_4DB-P108-05/4DB-P108-05/Allegro/4dbp10805.psm
Mechanical/Models/LIB_4DB-P108-05/4DB-P108-05/DEHDL/4db_p108_05/chips/chips.prt
