DinoDubroja/Power-amplifier/Harness design/Heatsink assembly.pdf

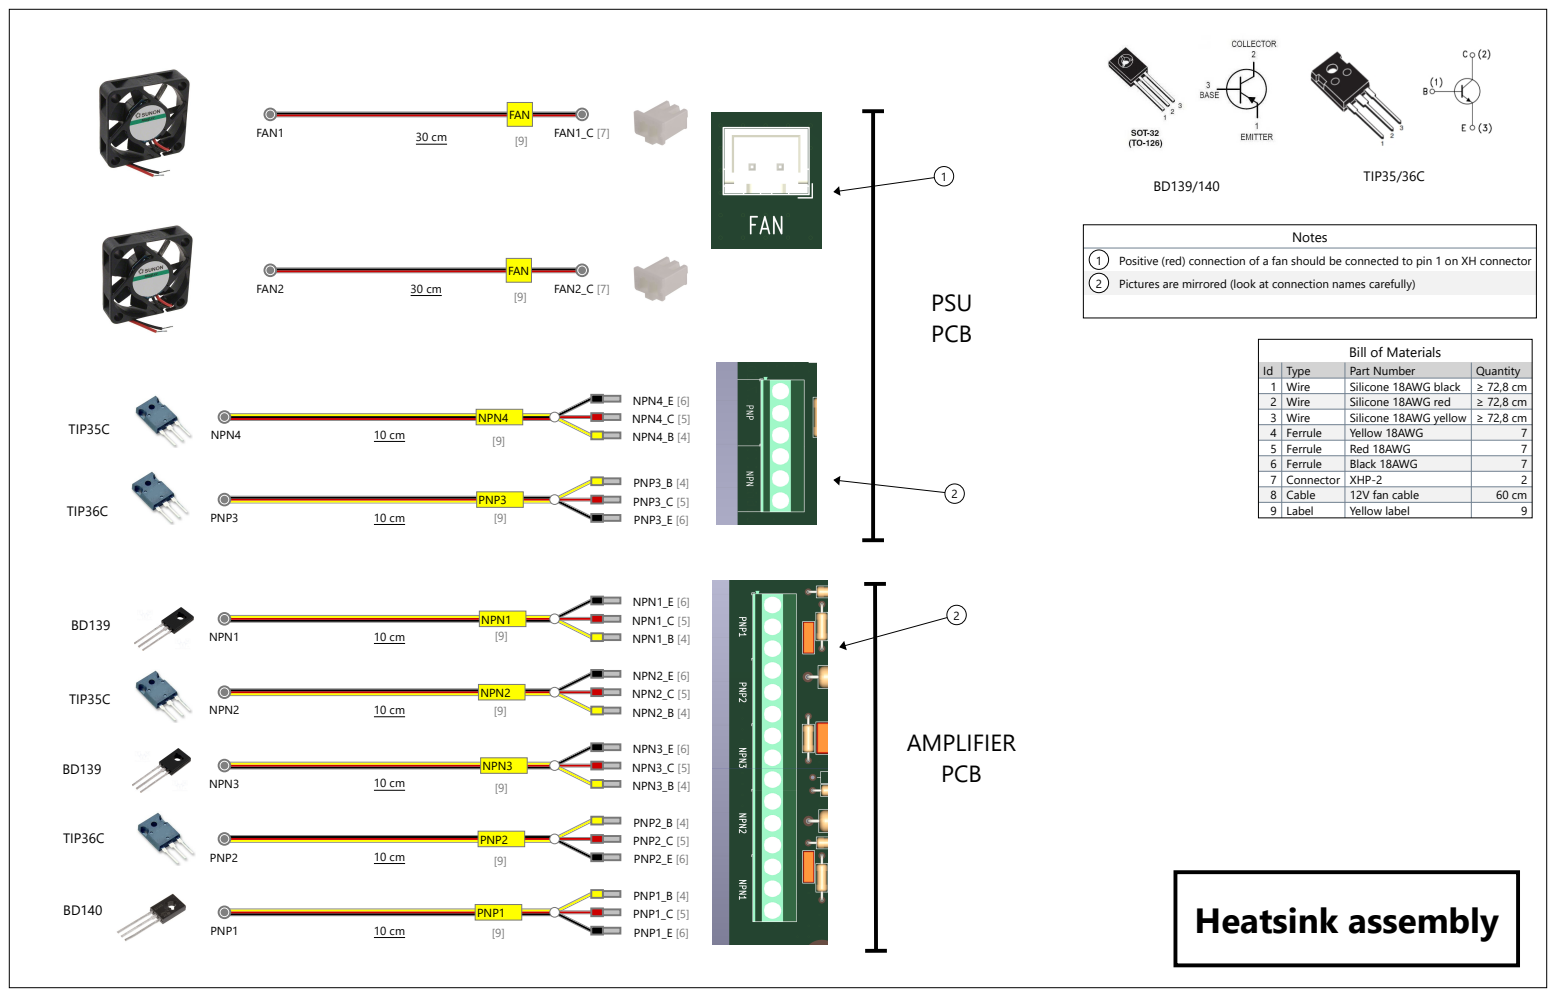
[picture p49: page 1]
ill o; als Id; Type; Part Number; ili; ello w; uld; f ully; TIP; LIFIE

1 | W i r e | S ili c o n e 1 8 AW G bla c k | ≥ 7 2 , 8 c m
2 | W i r e | S ili c o n e 1 8 AW G r e d | ≥ 7 2 , 8 c m

4 | F e r r ule | Yello w 1 8 AW G | 7
5 | F e r r ule | R e d 1 8 AW G | 7
6 | F e r r ule | Bla c k 1 8 AW G | 7
7 | C o n n e c t o r | X H P -2 | 2
8 | C a ble | 1 2 V f a n c a ble | 6 0 c m

9 | L a b el | Yello w la b el | 9

Rev. | Date | Author | Description
Revisions 1 of 1 | Page 2 of 7
Title: | ----
Part Number: | Heatsink assembly

Description:

Flag | Quantity | Note
1 | 1 | Positive (red) connection of a fan should be connected to pin 1 on XH connector
2 | 2 | Pictures are mirrored (look at connection names carefully)
Notes 1 of 1 | Page 3 of 7

Description:

Id | Type | Manufacturer | Part Number | Description | Quantity | Usage
1 | Wire | Silicone 18AWG black | Silicone 18AWG black | ≥ 72,8 cm | W1, W6, W9, W12, W13, W16, W19
2 | Wire | Silicone 18AWG red | Silicone 18AWG red | ≥ 72,8 cm | W2, W5, W8, W11, W14, W17, W20
3 | Wire | Silicone 18AWG yellow | Silicone 18AWG yellow | ≥ 72,8 cm | W3, W4, W7, W10, W15, W18, W21
4 | Ferrule | Yellow 18AWG | 7 | NPN1_B, NPN2_B, NPN3_B,
| | | | | | NPN4_B, PNP1_B, PNP2_B, PNP3_B
5 | Ferrule | Red 18AWG | 7 | NPN1_C, NPN2_C, NPN3_C,
| | | | | | NPN4_C, PNP1_C, PNP2_C, PNP3_C
6 | Ferrule | Black 18AWG | 7 | NPN1_E, NPN2_E, NPN3_E,
| | | | | | NPN4_E, PNP1_E, PNP2_E, PNP3_E
7 | Connector | JST | XHP-2 | Connector Housing, XH Series, 2 Positions,
| | | | 2.50mm, 250V, 30-22 AWG, Crimp, In-Line, Natural
2 | FAN1_C, FAN2_C
8 | Cable | 12V fan cable | 60 cm | CBL1, CBL2
9 | Label | Yellow label | 9 | See Drawing
Bill of Materials 1 of 1 | Page 4 of 7

Description:

From | To | Conductor | Conductor PN | Twisted With | Size | Length | From Contact PN | Notes
FAN1.1 | FAN1_C.1 | CBL1.Red | 12V fan cable | | 26 AWG | 30 cm
FAN1.2 | FAN1_C.2 | CBL1.Black | 12V fan cable | | 26 AWG | 30 cm
FAN2.1 | FAN2_C.1 | CBL2.Red | 12V fan cable | | 26 AWG | 30 cm
FAN2.2 | FAN2_C.2 | CBL2.Black | 12V fan cable | | 26 AWG | 30 cm
NPN1.1 | NPN1_E | W13.Black | Silicone 18AWG black | W14, W15 | 18 AWG | ≥ 10,4 cm
NPN1.2 | NPN1_C | W14.Red | Silicone 18AWG red | W13, W15 | 18 AWG | ≥ 10,4 cm
NPN1.3 | NPN1_B | W15.Yellow | Silicone 18AWG yellow | W13, W14 | 18 AWG | ≥ 10,4 cm
NPN2.1 | NPN2_B | W7.Yellow | Silicone 18AWG yellow | W8, W9 | 18 AWG | ≥ 10,4 cm
NPN2.2 | NPN2_C | W8.Red | Silicone 18AWG red | W7, W9 | 18 AWG | ≥ 10,4 cm
NPN2.3 | NPN2_E | W9.Black | Silicone 18AWG black | W7, W8 | 18 AWG | ≥ 10,4 cm
NPN3.1 | NPN3_E | W16.Black | Silicone 18AWG black | W17, W18 | 18 AWG | ≥ 10,4 cm
NPN3.2 | NPN3_C | W17.Red | Silicone 18AWG red | W16, W18 | 18 AWG | ≥ 10,4 cm
NPN3.3 | NPN3_B | W18.Yellow | Silicone 18AWG yellow | W16, W17 | 18 AWG | ≥ 10,4 cm
NPN4.1 | NPN4_B | W3.Yellow | Silicone 18AWG yellow | W1, W2 | 18 AWG | ≥ 10,4 cm
NPN4.2 | NPN4_C | W2.Red | Silicone 18AWG red | W1, W3 | 18 AWG | ≥ 10,4 cm
NPN4.3 | NPN4_E | W1.Black | Silicone 18AWG black | W2, W3 | 18 AWG | ≥ 10,4 cm
PNP1.1 | PNP1_E | W19.Black | Silicone 18AWG black | W20, W21 | 18 AWG | ≥ 10,4 cm
PNP1.2 | PNP1_C | W20.Red | Silicone 18AWG red | W19, W21 | 18 AWG | ≥ 10,4 cm
PNP1.3 | PNP1_B | W21.Yellow | Silicone 18AWG yellow | W19, W20 | 18 AWG | ≥ 10,4 cm
PNP2.1 | PNP2_B | W10.Yellow | Silicone 18AWG yellow | W11, W12 | 18 AWG | ≥ 10,4 cm
PNP2.2 | PNP2_C | W11.Red | Silicone 18AWG red | W10, W12 | 18 AWG | ≥ 10,4 cm
PNP2.3 | PNP2_E | W12.Black | Silicone 18AWG black | W10, W11 | 18 AWG | ≥ 10,4 cm
PNP3.1 | PNP3_B | W4.Yellow | Silicone 18AWG yellow | W5, W6 | 18 AWG | ≥ 10,4 cm
PNP3.2 | PNP3_C | W5.Red | Silicone 18AWG red | W4, W6 | 18 AWG | ≥ 10,4 cm
PNP3.3 | PNP3_E | W6.Black | Silicone 18AWG black | W4, W5 | 18 AWG | ≥ 10,4 cm
Wiring Table 1 of 1 | Page 5 of 7

Description:

# | Type | Reference Designator | Manufacturer | Part Number | Color | Size | From Strip | To Strip | Length | Twisted With | Notes

1 | Cable | CBL1 | 12V fan cable | Unspecified | 30 cm
2 | Cable | CBL2 | 12V fan cable | Unspecified | 30 cm
3 | Wire | W1 | Silicone 18AWG black | Black | 18 AWG | 4 mm | ≥ 10,4 cm | W2, W3
4 | Wire | W2 | Silicone 18AWG red | Red | 18 AWG | 4 mm | ≥ 10,4 cm | W1, W3
5 | Wire | W3 | Silicone 18AWG yellow | Yellow | 18 AWG | 4 mm | ≥ 10,4 cm | W1, W2
6 | Wire | W4 | Silicone 18AWG yellow | Yellow | 18 AWG | 4 mm | ≥ 10,4 cm | W5, W6
7 | Wire | W5 | Silicone 18AWG red | Red | 18 AWG | 4 mm | ≥ 10,4 cm | W4, W6
8 | Wire | W6 | Silicone 18AWG black | Black | 18 AWG | 4 mm | ≥ 10,4 cm | W4, W5
9 | Wire | W7 | Silicone 18AWG yellow | Yellow | 18 AWG | 4 mm | ≥ 10,4 cm | W8, W9
10 | Wire | W8 | Silicone 18AWG red | Red | 18 AWG | 4 mm | ≥ 10,4 cm | W7, W9
11 | Wire | W9 | Silicone 18AWG black | Black | 18 AWG | 4 mm | ≥ 10,4 cm | W7, W8
12 | Wire | W10 | Silicone 18AWG yellow | Yellow | 18 AWG | 4 mm | ≥ 10,4 cm | W11, W12
13 | Wire | W11 | Silicone 18AWG red | Red | 18 AWG | 4 mm | ≥ 10,4 cm | W10, W12
14 | Wire | W12 | Silicone 18AWG black | Black | 18 AWG | 4 mm | ≥ 10,4 cm | W10, W11
15 | Wire | W13 | Silicone 18AWG black | Black | 18 AWG | 4 mm | ≥ 10,4 cm | W14, W15
16 | Wire | W14 | Silicone 18AWG red | Red | 18 AWG | 4 mm | ≥ 10,4 cm | W13, W15
17 | Wire | W15 | Silicone 18AWG yellow | Yellow | 18 AWG | 4 mm | ≥ 10,4 cm | W13, W14
18 | Wire | W16 | Silicone 18AWG black | Black | 18 AWG | 4 mm | ≥ 10,4 cm | W17, W18
19 | Wire | W17 | Silicone 18AWG red | Red | 18 AWG | 4 mm | ≥ 10,4 cm | W16, W18
20 | Wire | W18 | Silicone 18AWG yellow | Yellow | 18 AWG | 4 mm | ≥ 10,4 cm | W16, W17
21 | Wire | W19 | Silicone 18AWG black | Black | 18 AWG | 4 mm | ≥ 10,4 cm | W20, W21
22 | Wire | W20 | Silicone 18AWG red | Red | 18 AWG | 4 mm | ≥ 10,4 cm | W19, W21
23 | Wire | W21 | Silicone 18AWG yellow | Yellow | 18 AWG | 4 mm | ≥ 10,4 cm | W19, W20
Cutlist 1 of 1 | Page 6 of 7

Description:

# | Manufacturer | Part Number | Description | Label Text

1 | | Yellow label | | FAN
2 | | Yellow label | | FAN
3 | | Yellow label | | NPN1
4 | | Yellow label | | NPN2
5 | | Yellow label | | NPN3
6 | | Yellow label | | NPN4
7 | | Yellow label | | PNP1
8 | | Yellow label | | PNP2
9 | | Yellow label | | PNP3
Labels 1 of 1 | Page 7 of 7

Description:
