DinoDubroja/Power-amplifier/PCB/AC busbar/PRINT.pdf

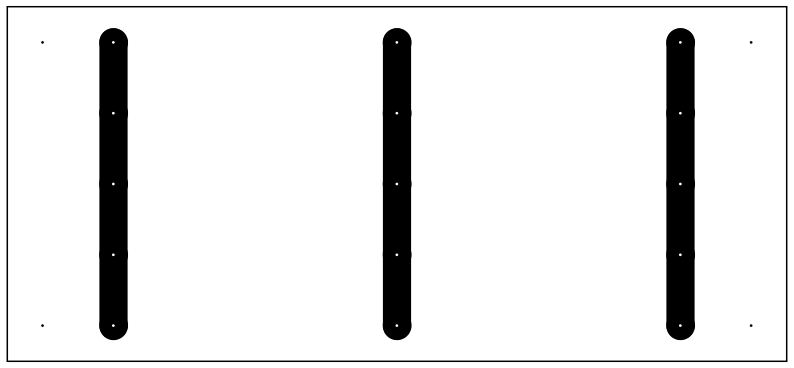
[picture p50: figure]
