DinoDubroja/Power-amplifier/PCB/Mains wiring/AC ENTRY.png

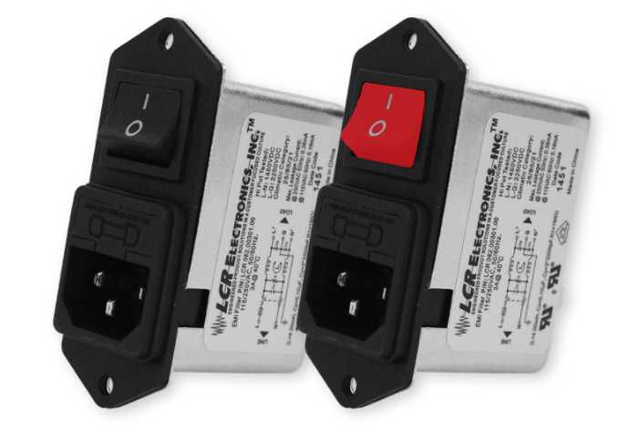
PCB/Mains wiring/AC ENTRY.png
