DinoDubroja/Power-amplifier/PCB/Mains wiring/FUSE.webp

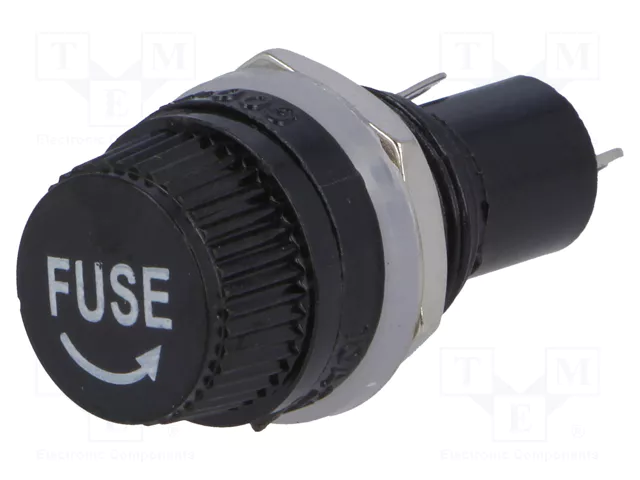
PCB/Mains wiring/FUSE.webp
