DinoDubroja/Power-amplifier/PCB/Mains wiring/toroid.jpg

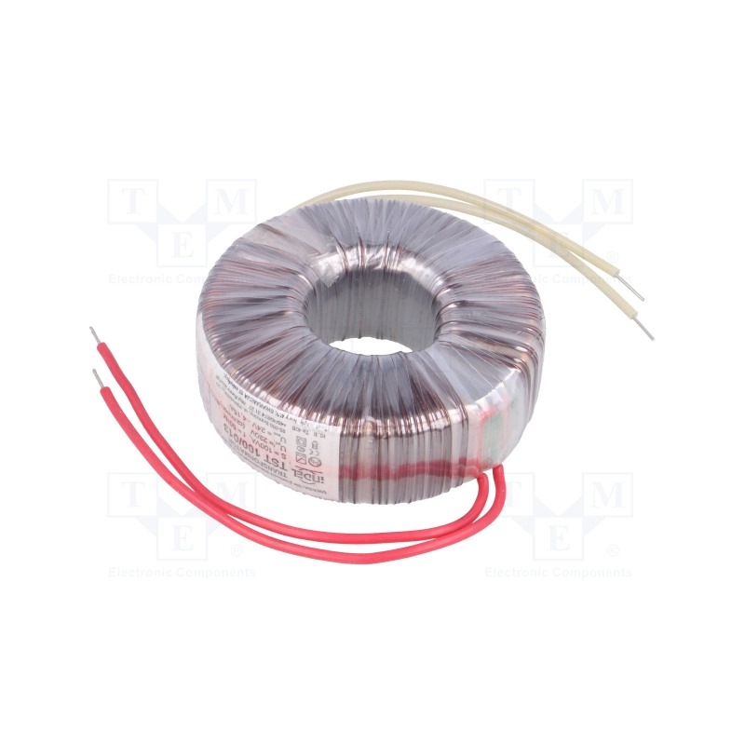
PCB/Mains wiring/toroid.jpg
