DinoDubroja/Power-amplifier/OLD/Measurements/Distortion/Class AB/Effect of frequency on THD.xlsx

Measurement conditions
Parameters 2V (amplitude), Rload=100k, Rb=4,7k, Pq=3,25 W
Frequency [Hz] | Fundamental [dB] | h2 [dB] | h3 [dB] | h4 [dB] | h5 [dB] | h6 [dB] | h7 [dB] | h8 [dB] | h9 [dB] | h10 [dB] | h11 [dB] | h12 [dB] | h13 [dB] | h14 [dB]
10
100
1k
10k | 2.03 | -52.50 | -71.00 | -63.50 | -55.50 | -56.70 | -70.00 | -67.00
