DinoDubroja/Power-amplifier/OLD/Measurements/Distortion/Class AB/Effect of temperature on Q.xlsx

Measurement conditions
Pq was measured when thermal equilibrium was achieved
Parameters f=1kHz, 0V (amplitude), Rload=100k Rb=4.7k
T1 [°C] | T2 [°C] | Pt1 [W] | Pt2[W] | Pq [W]
 | 30.00 |  |  | 2.60
 | 31.00 |  |  | 3.00
 | 34.00 |  |  | 3.20
 | 40.00 |  |  | 3.40 | a
 | 44.00 |  |  | 3.50
 | 47.00 |  |  | 3.60
 | 50.00 |  |  | 3.70
 | 54.00 |  |  | 3.80
 | 57.50 |  |  | 3.90
 | 60.00 |  |  | 4.00
 | 63.00 |  |  | 4.10
 | 65.00 |  |  | 4.20
 | 67.50 |  |  | 4.30
 | 70.00 |  |  | 4.50
 | 73.00 |  |  | 4.60
 | 76.00 |  |  | 4.70
 | 78.50 |  |  | 4.80
 | 81.00 |  |  | 4.90
 | 83.50 |  |  | 5.00
 | 85.50 |  |  | 5.10
 | 95.50 |  |  | 5.60
 | 106.00 |  |  | 6.13
