DinoDubroja/Power-amplifier/Mechanical/Drawings/bitmap.pdf

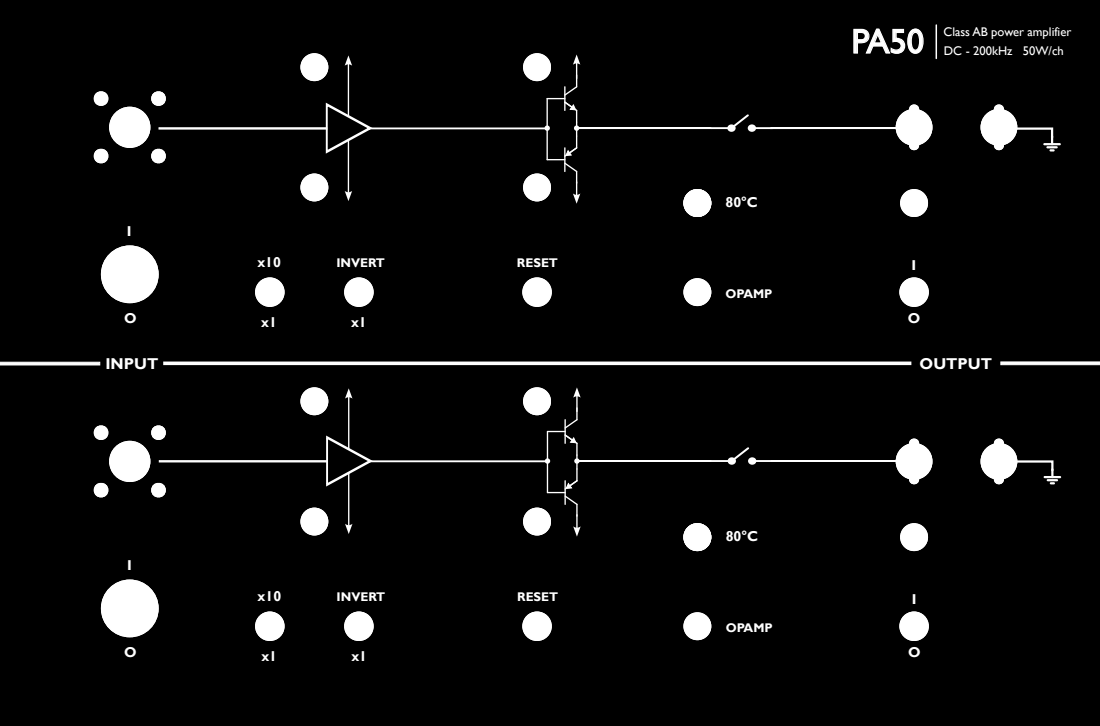
[picture p54: page 1]
INPUT; INVERT; RESET; OUTPUT; OPAMP; DC - 200kHz 50W/ch

Class AB power amplifier PA50
