DinoDubroja/Power-amplifier/Mechanical/Drawings/Heatsink assembly - template.pdf

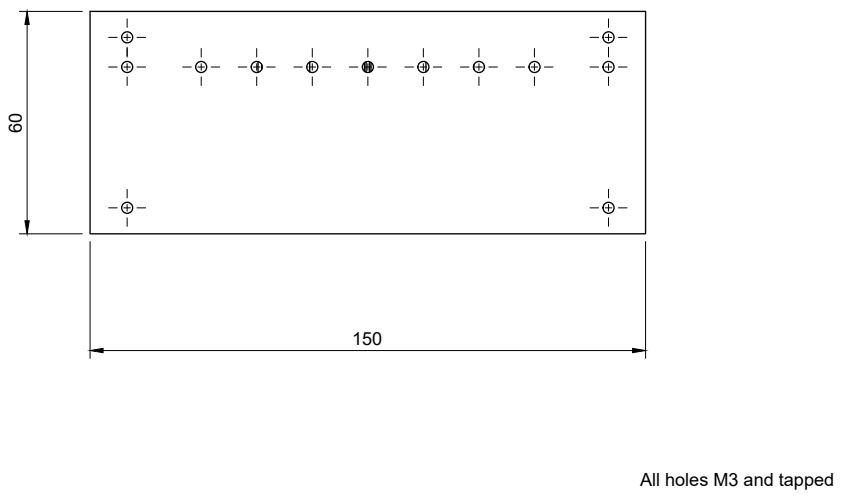
[picture p56: page 1]

All holes M3 and tapped
