DinoDubroja/Power-amplifier/PCB/Busbar v2/Busbar/plots/Busbar__Assembly.pdf

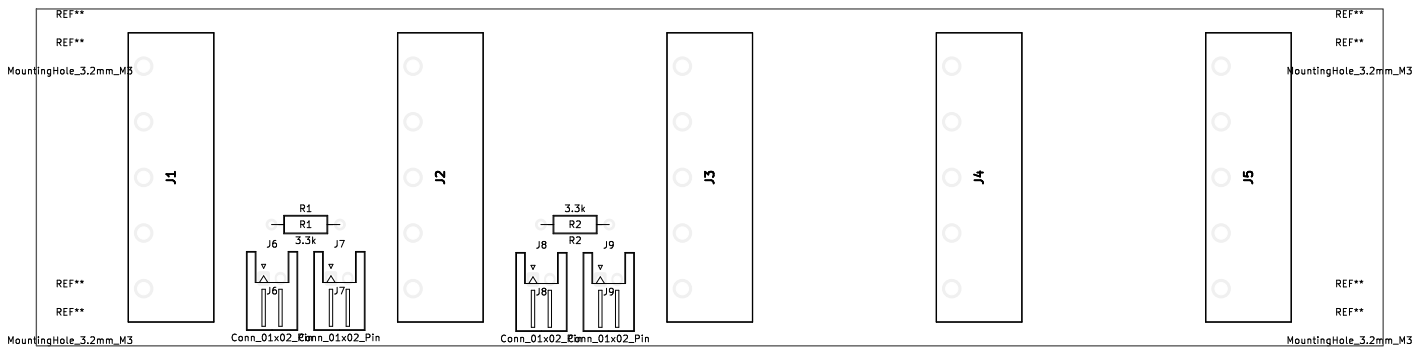
[picture p57: page 1]

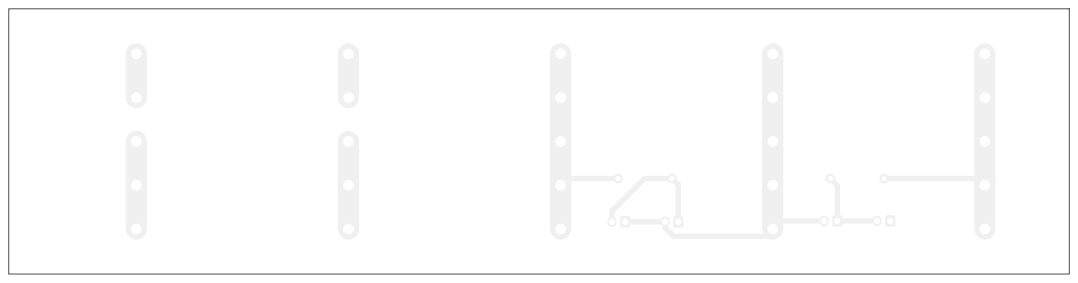
[picture p58: page 2]
D Date: KiCad; E.D.A. 8.0.0 Size: A4; Rev:; Id: 1/1 Title: File: Busbar.kicad_pcb Sheet: Black; And; White; BOT Board2Pdf:; Black; BOT -; Page 2/2
