DinoDubroja/Power-amplifier/PCB/Amplifier/Amplifier/Amplifier.pdf

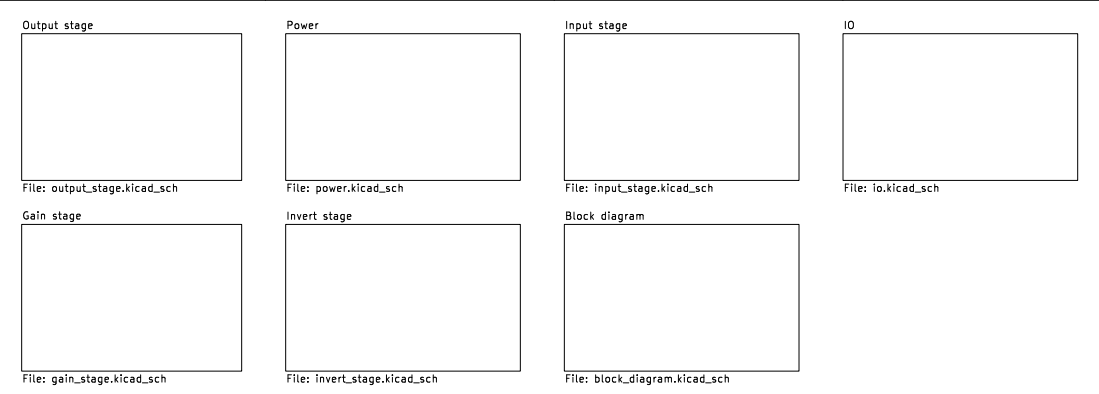
[picture p59: page 1]

File: block_diagram.kicad_sch Power File: power.kicad_sch

Input stage File: input_stage.kicad_sch Block diagram

Invert stage File: invert_stage.kicad_sch Gain stage File: gain_stage.kicad_sch

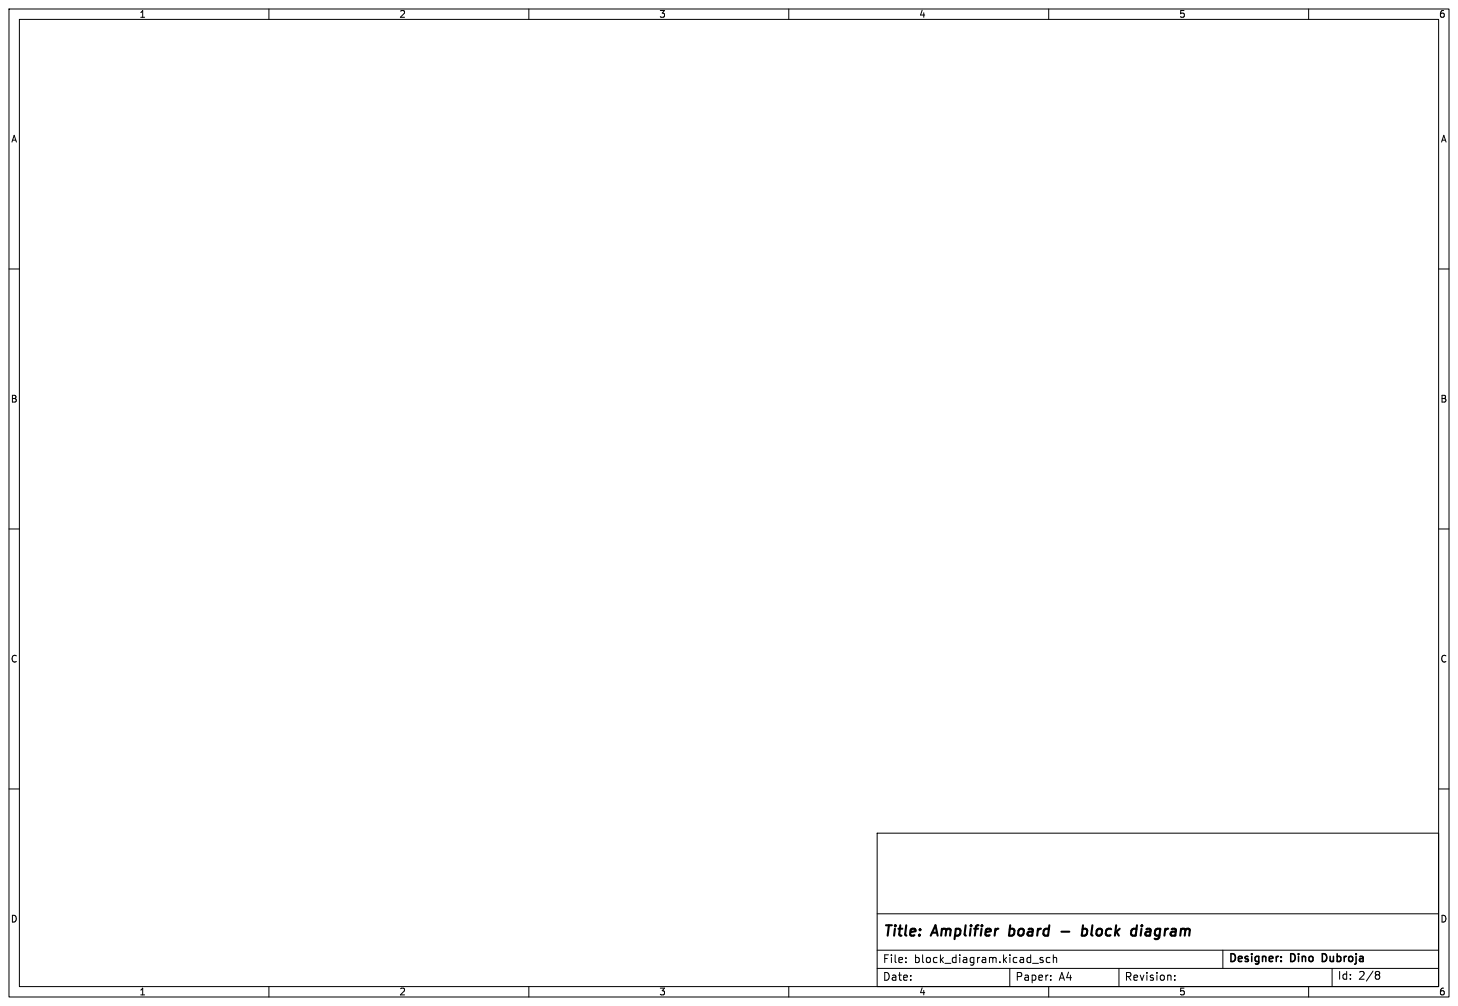
[picture p60: page 2]

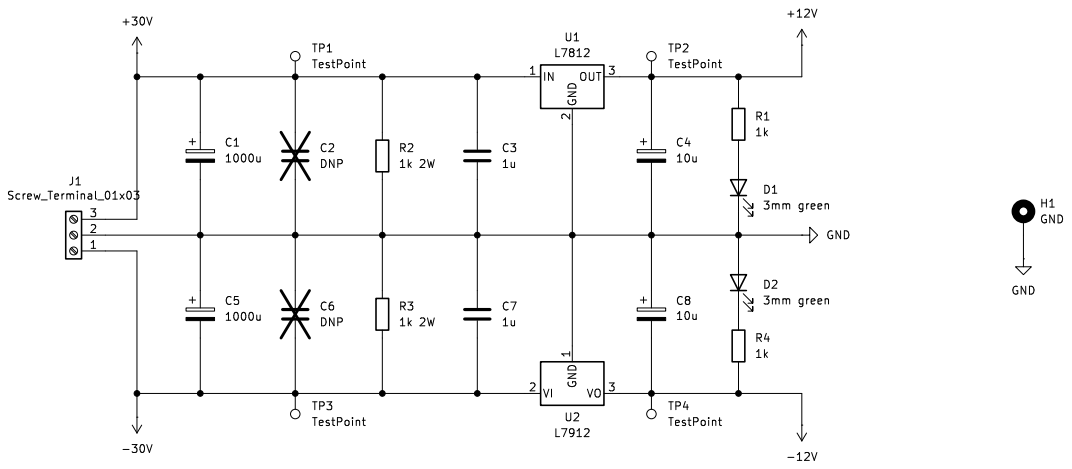
[picture p61: page 3]

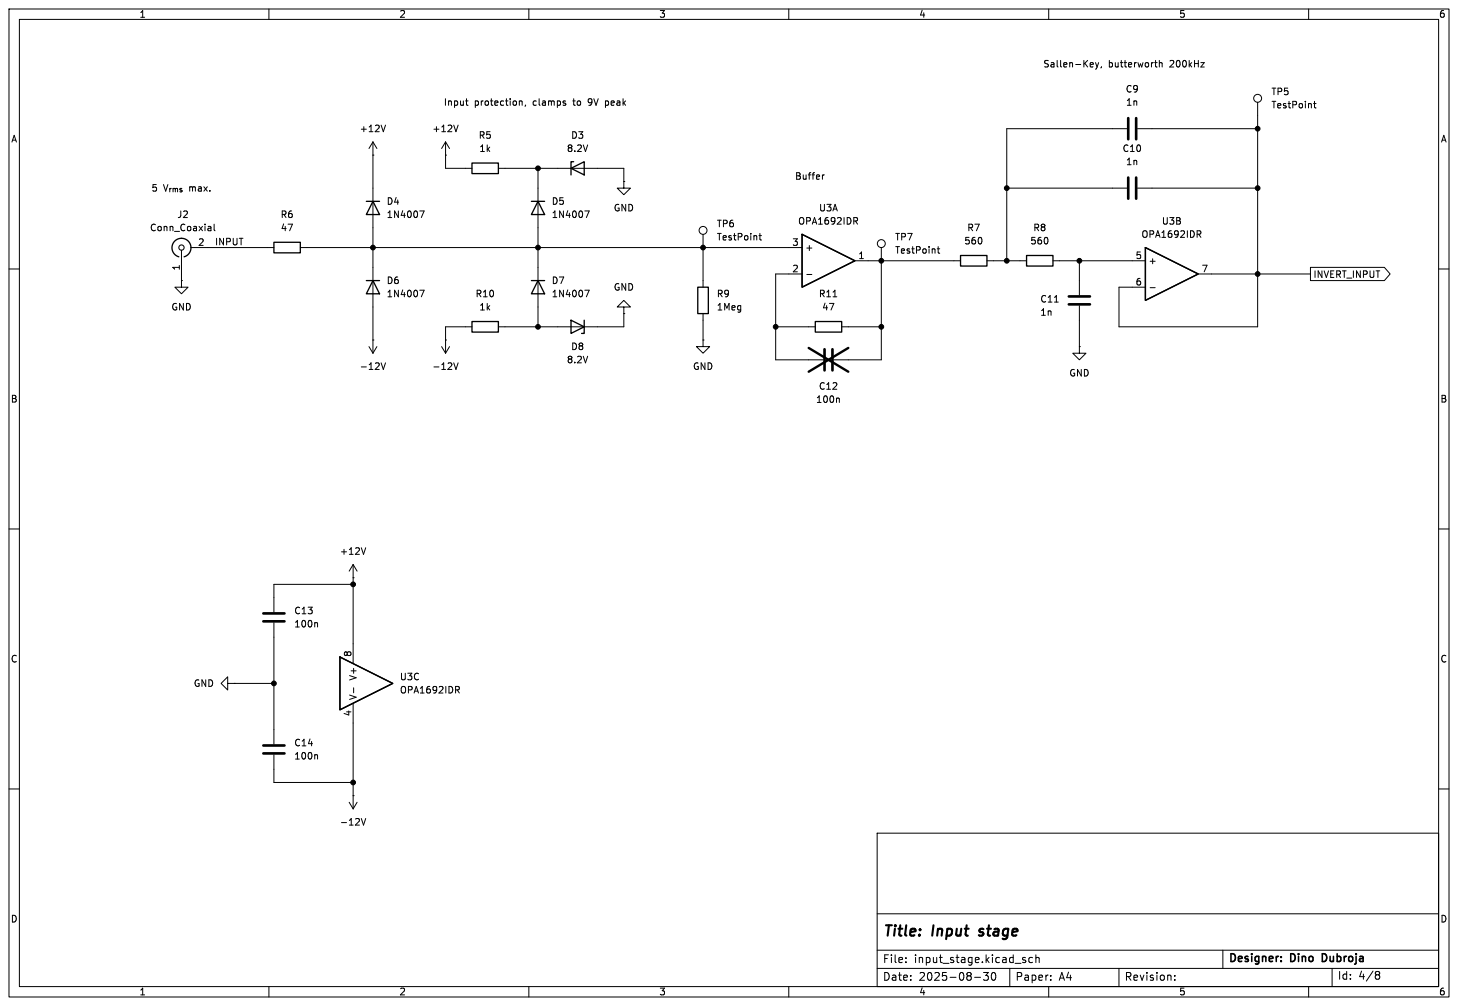
[picture p62: page 4]

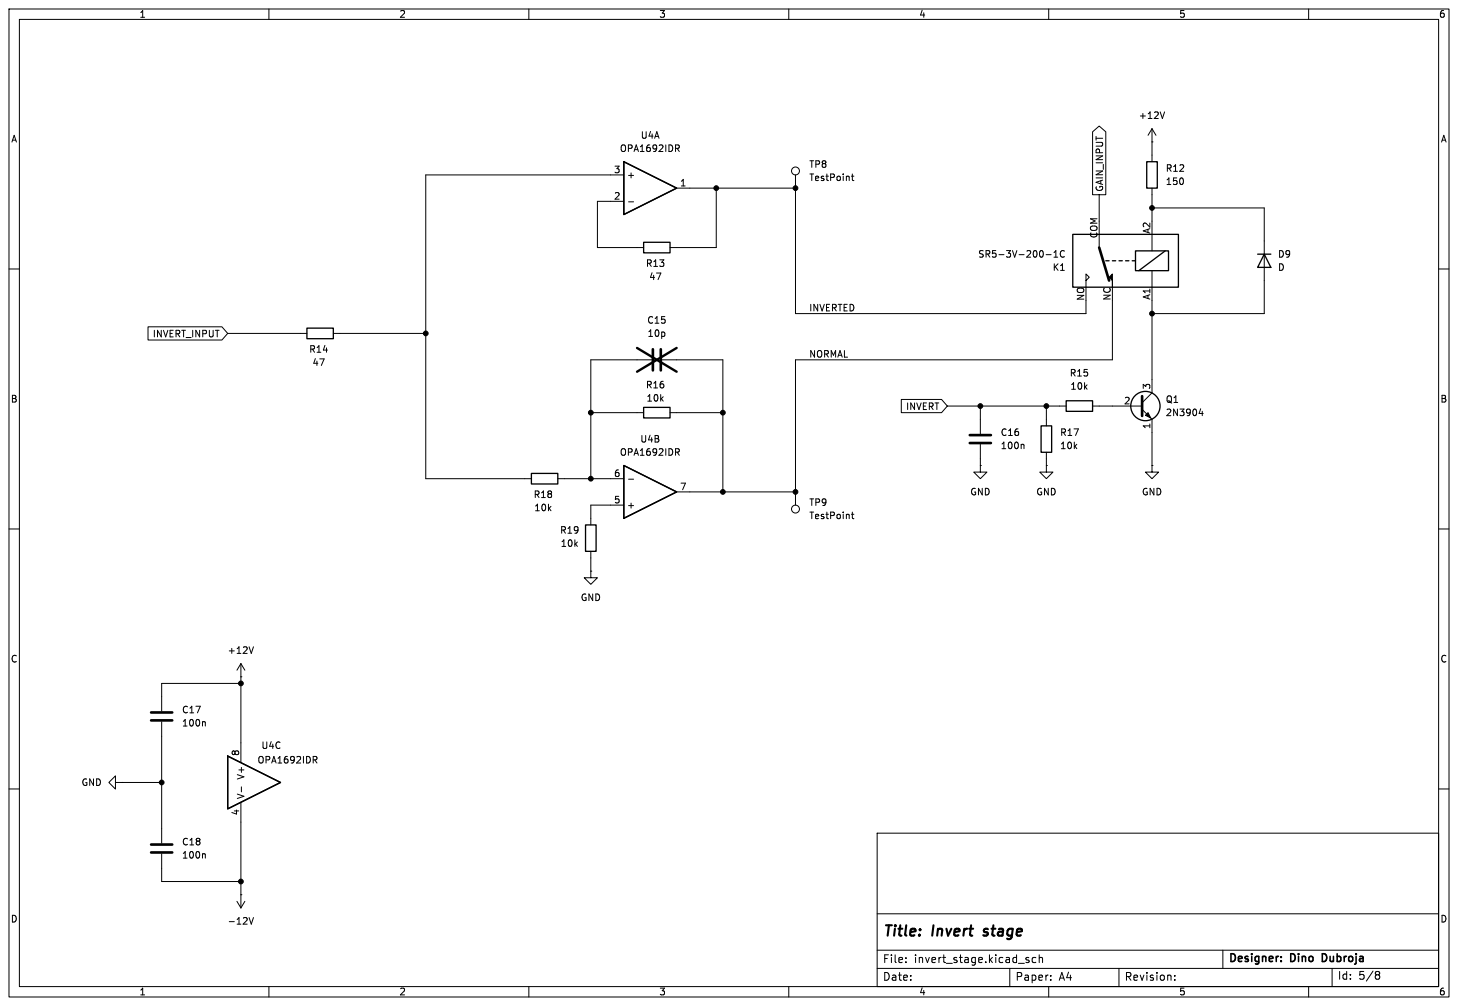
[picture p63: page 5]

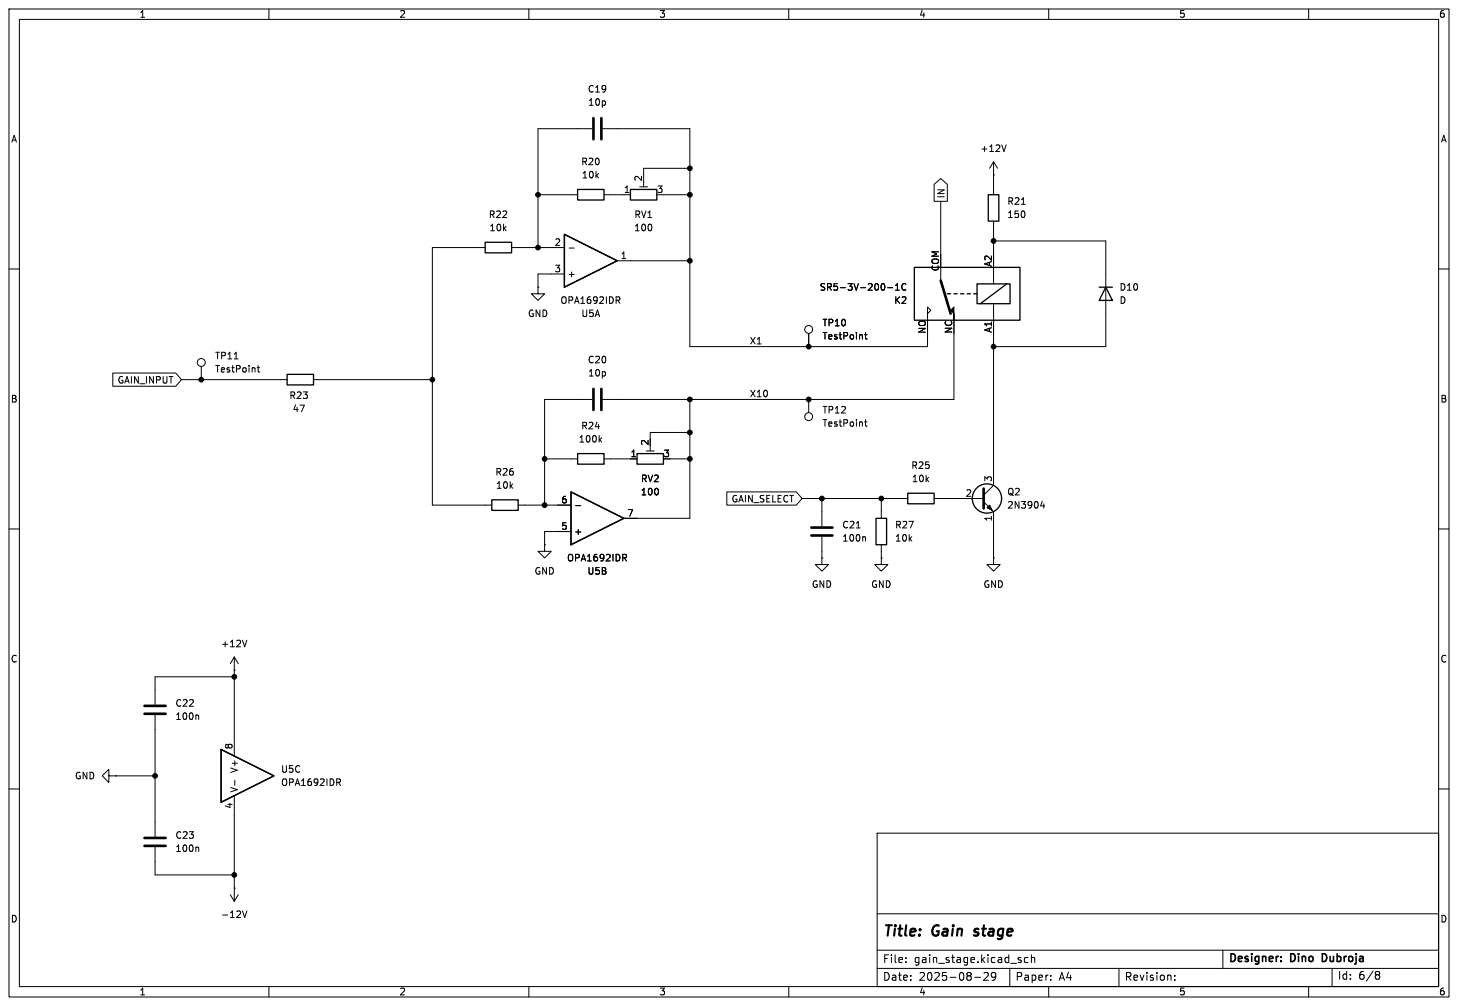
[picture p64: page 6]

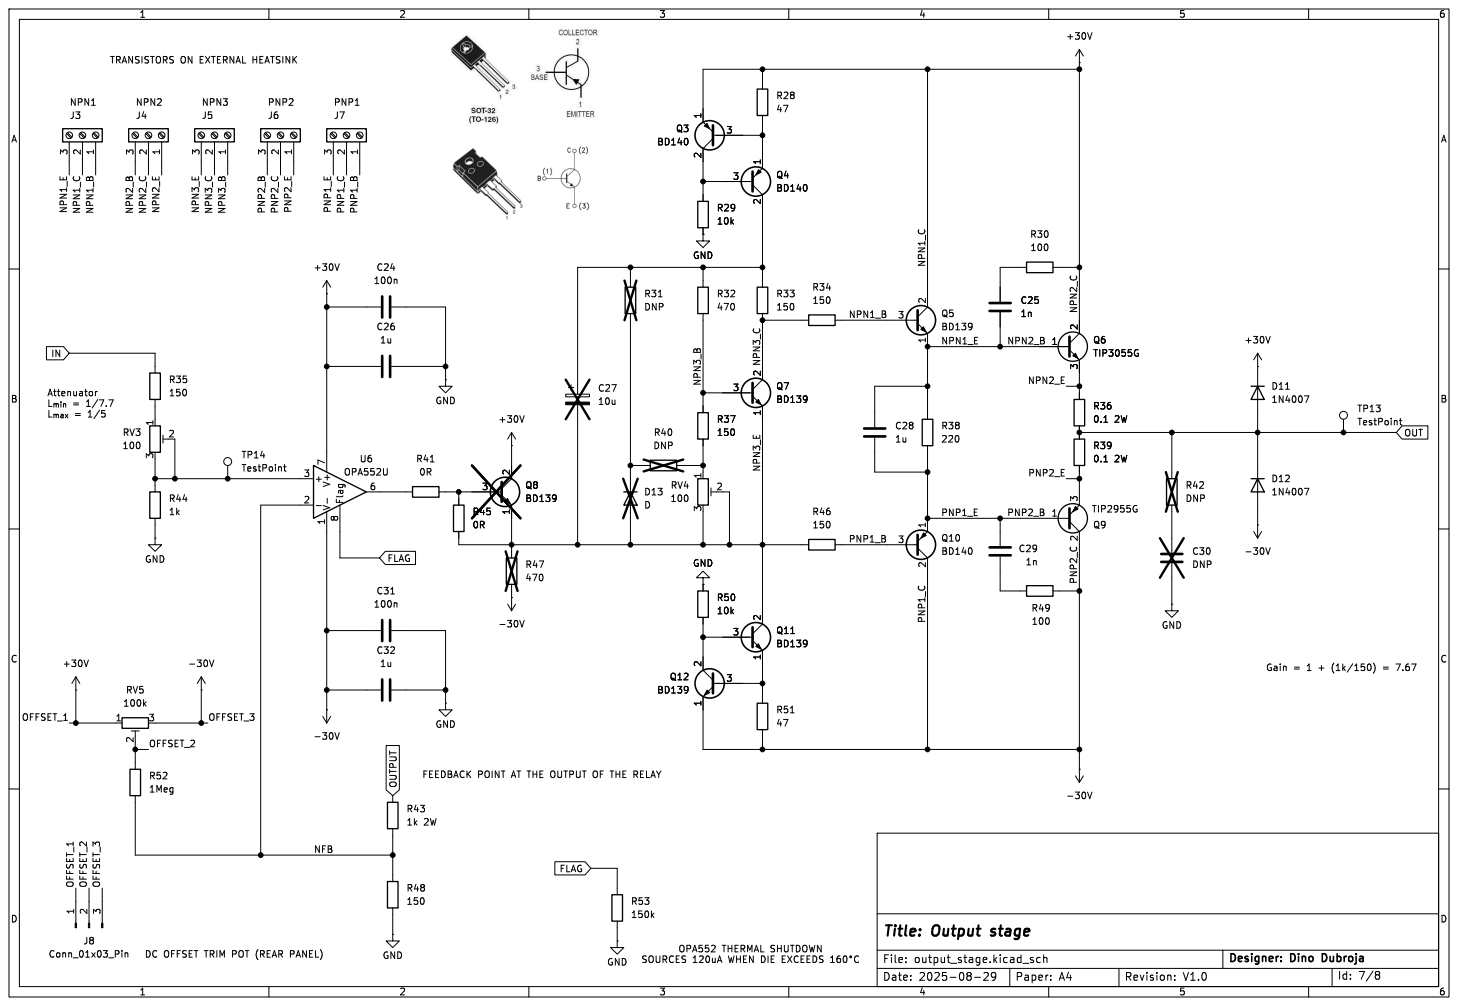
[picture p65: page 7]

SOURCES 120uA WHEN DIE EXCEEDS þÿ160°C

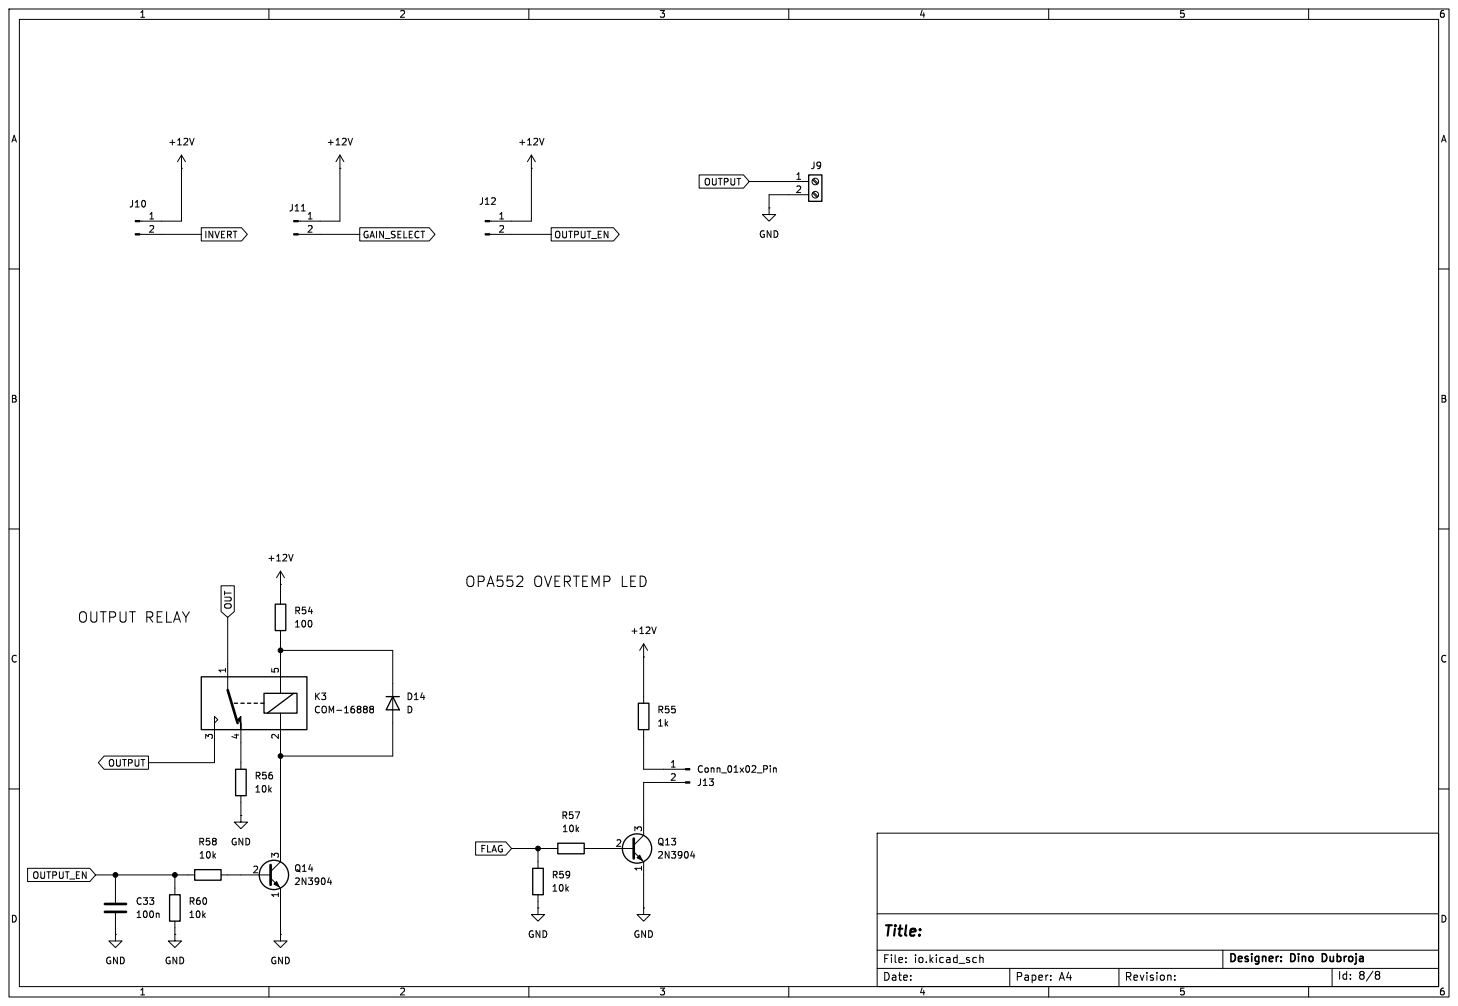
[picture p66: page 8]
