DinoDubroja/Power-amplifier/Mechanical/Drawings/bottom cover template.pdf

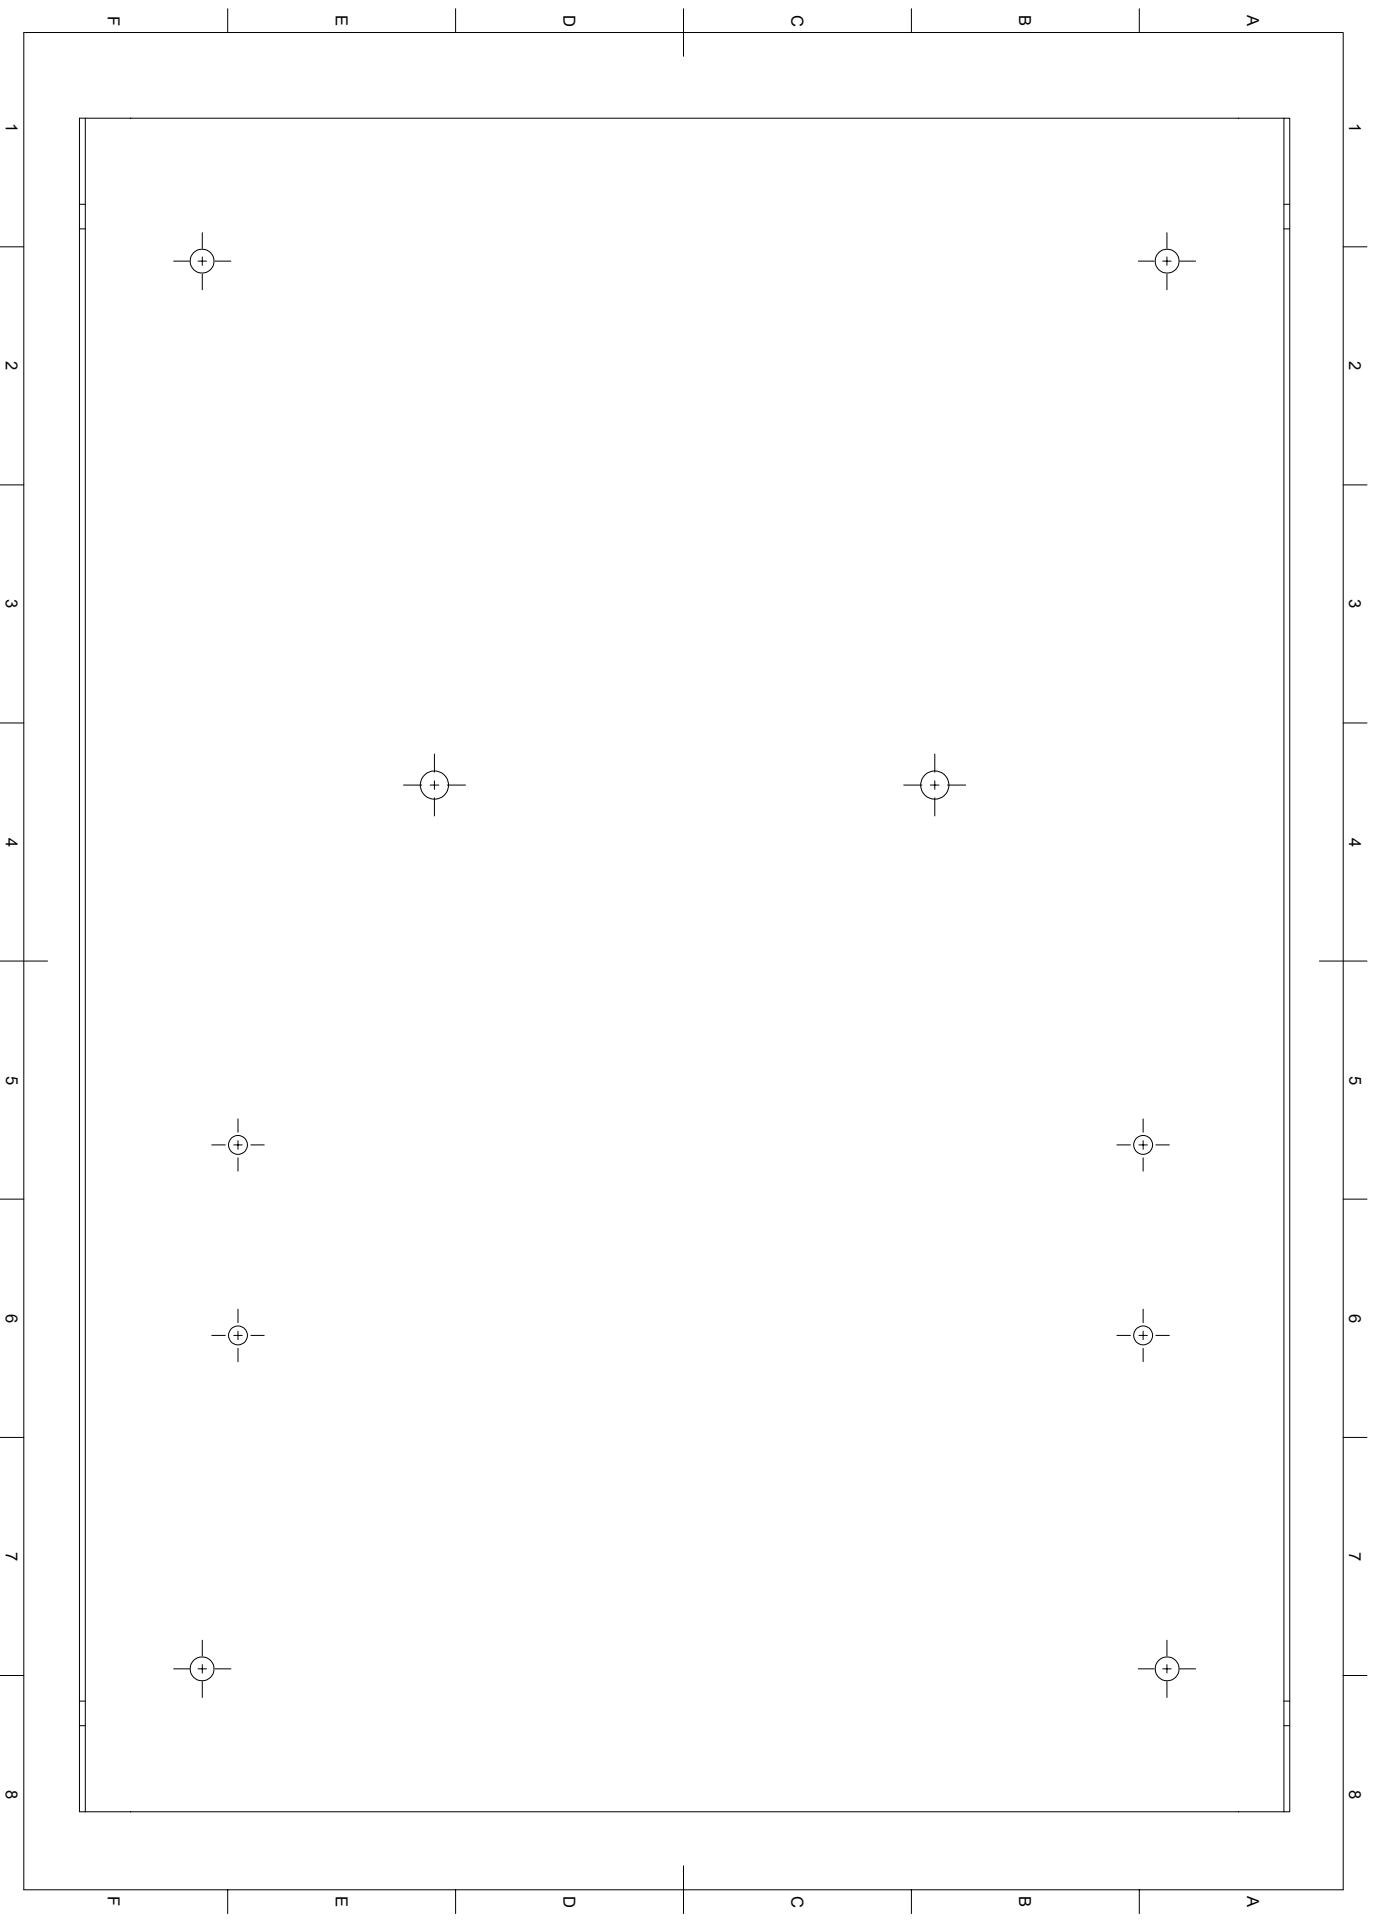
[picture p67: page 1]
1 A 2 3 4 5 6 7 8 1 2 3 4 5 6 7 8 FEDCB FEDCBA
