DinoDubroja/Power-amplifier/PCB/Busbar v2/Busbar/Busbar-B_Cu.pdf

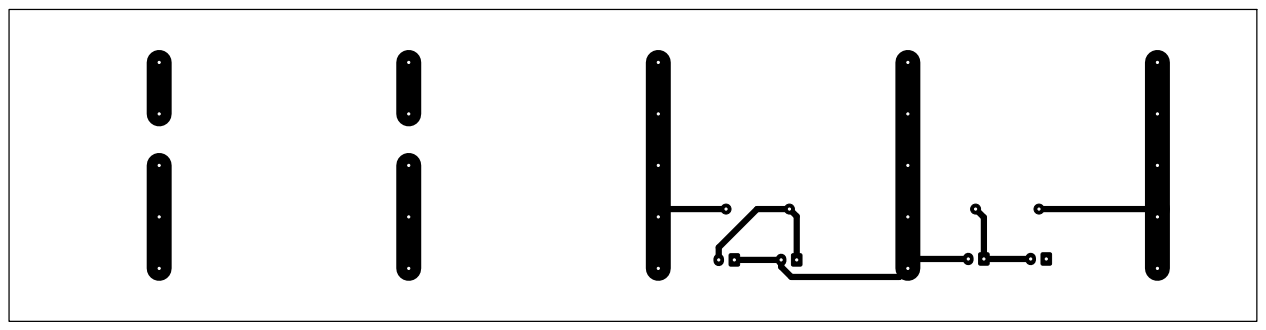
[picture p68: page 1]
