DinoDubroja/Power-amplifier/PCB/Busbar v2/Busbar/Busbar-B_Mask.pdf

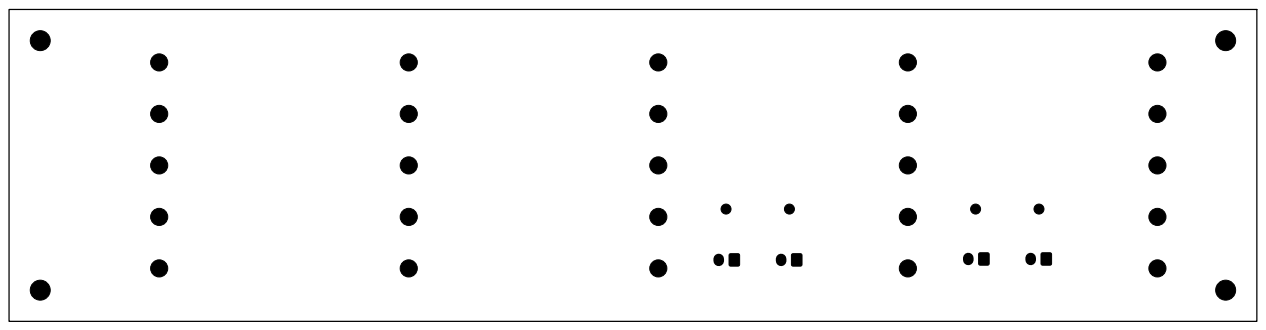
[picture p69: page 1]
