DinoDubroja/Power-amplifier/PCB/Power supply/Power supply/Power supply-B_Silkscreen.pdf

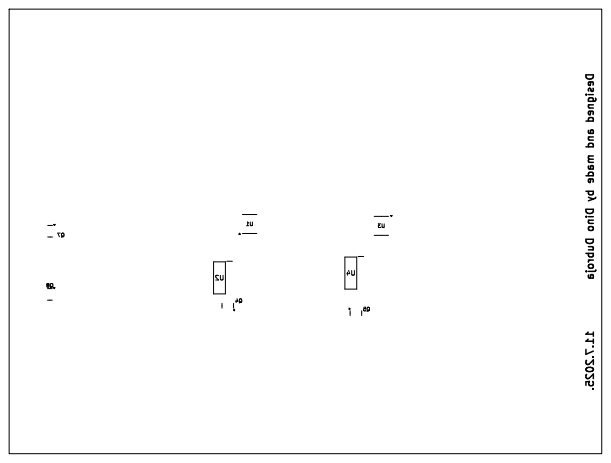
[picture p70: page 1]

Designed and made by Dino Dubroja 11.7.2025.
