DinoDubroja/Power-amplifier/PCB/Power supply/Power supply/Power supply-F_Silkscreen.pdf

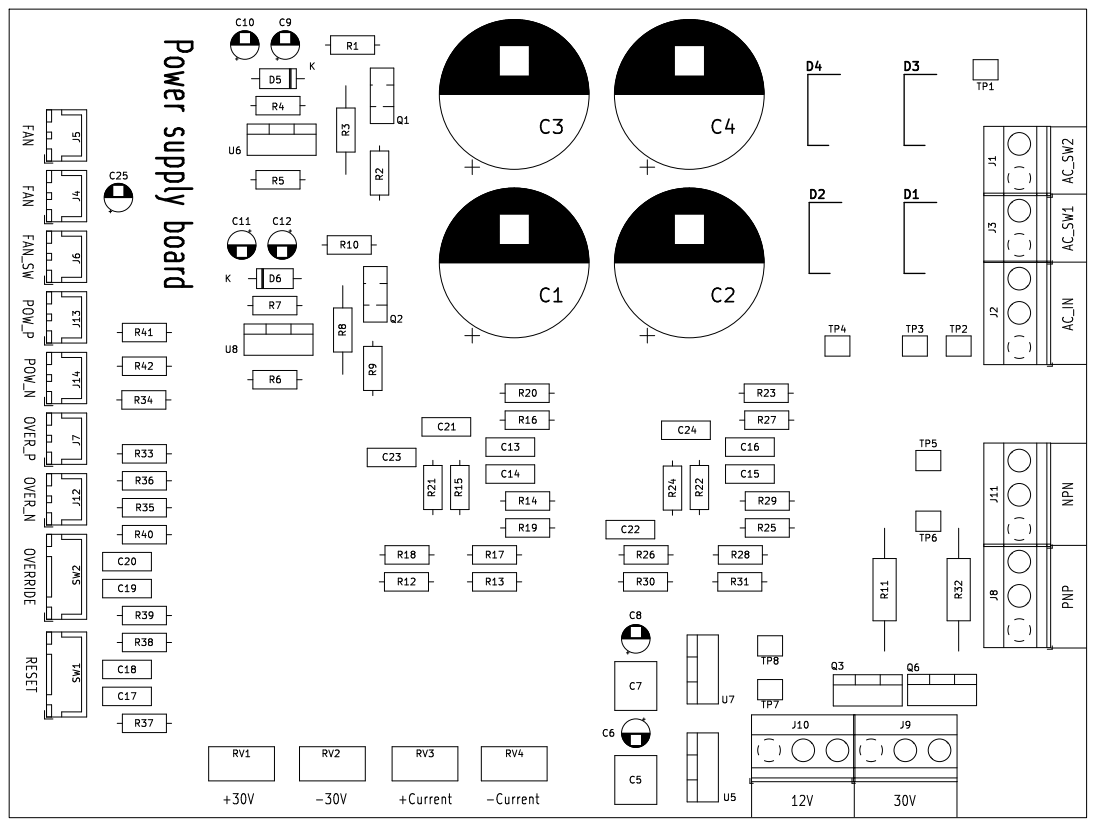
[picture p71: page 1]
