DinoDubroja/Power-amplifier/PCB/OLD/Class AB test PCB/Class AB test PCB/plots/Class AB test PCB__Assembly.pdf

1kR8 | BD140 Q2⁴⁷⁰ | R⁵ 1N⁴¹⁴⁸ D³ K ¹⁰⁰n | C¹

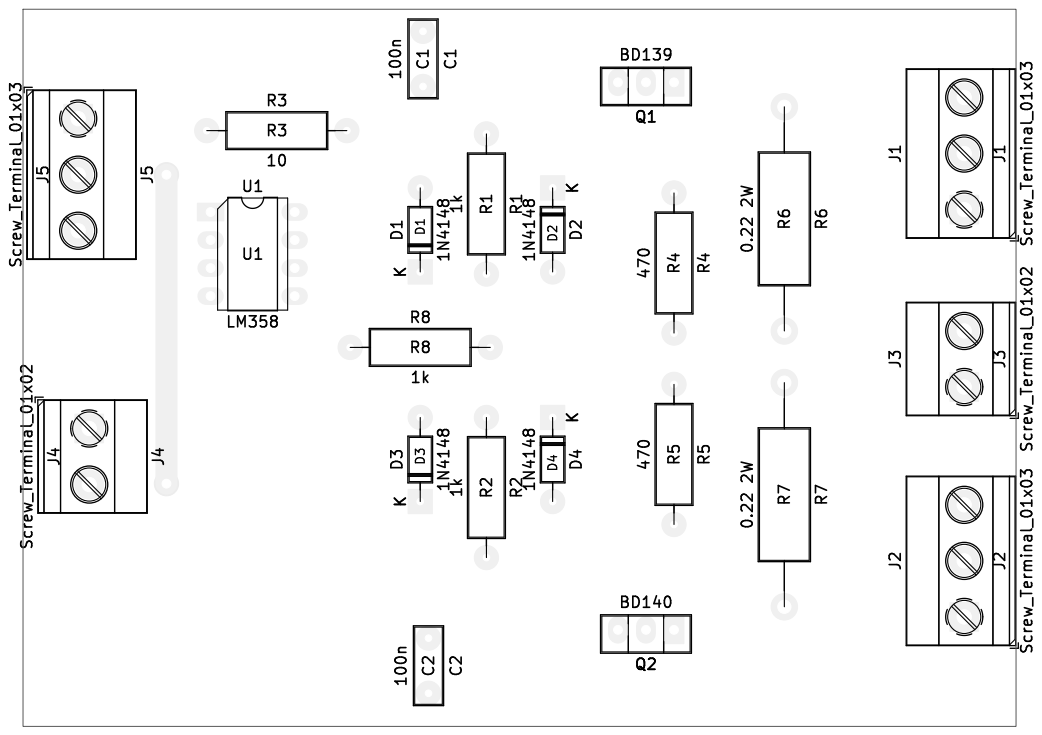
[picture p72: page 1]

D1 K R6R1 D4 K J2 J5 J3 D2 K J1 R7 J4 Q1 R2 R8 Q2 D3R5 K C1 R3 C2 R4 U1 1 2 3 4 5 6 1 2 3 4 5 6 ABCD ABCD Date: KiCad E.D.A. 8.0.0 Size: A4 Rev:

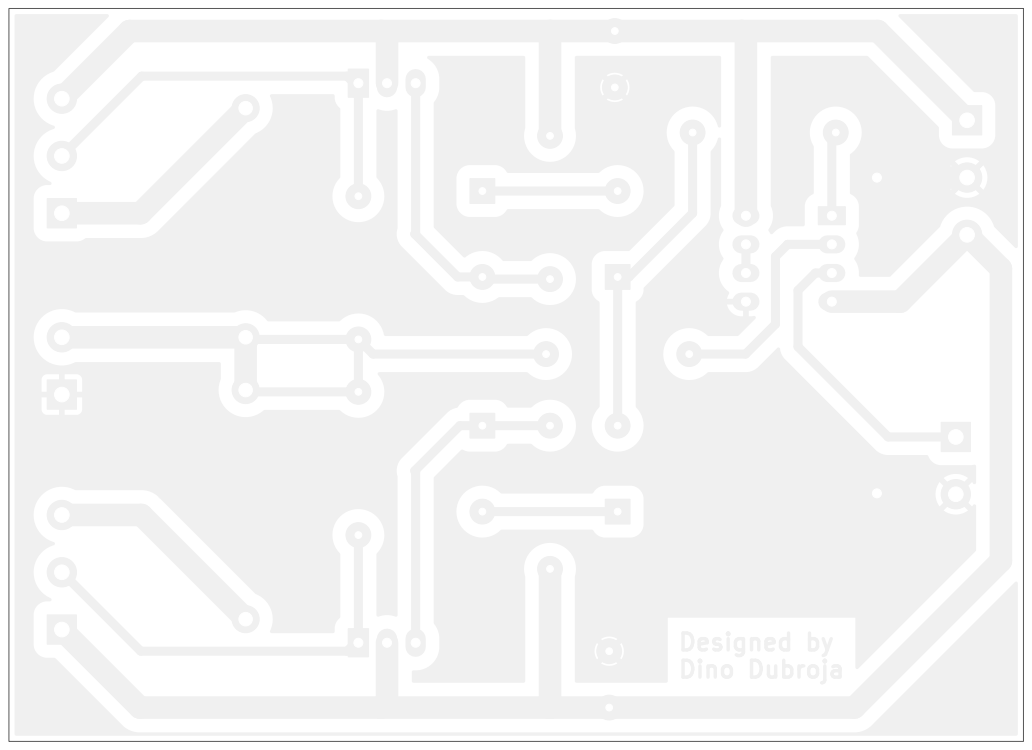
[picture p73: page 2]
Designed; by Dino; Dubroja; D Date: KiCad; E.D.A. 8.0.0 Size: A4; Rev:; Id: 1/1 Title: File: Class AB test; PCB.kicad_pcb Sheet: Black; And; White; BOT Board2Pdf:; Black; BOT -; Page 2/4

1kR8 | BD140 Q2⁴⁷⁰ | R⁵ 1N⁴¹⁴⁸ D³ K ¹⁰⁰n | C¹

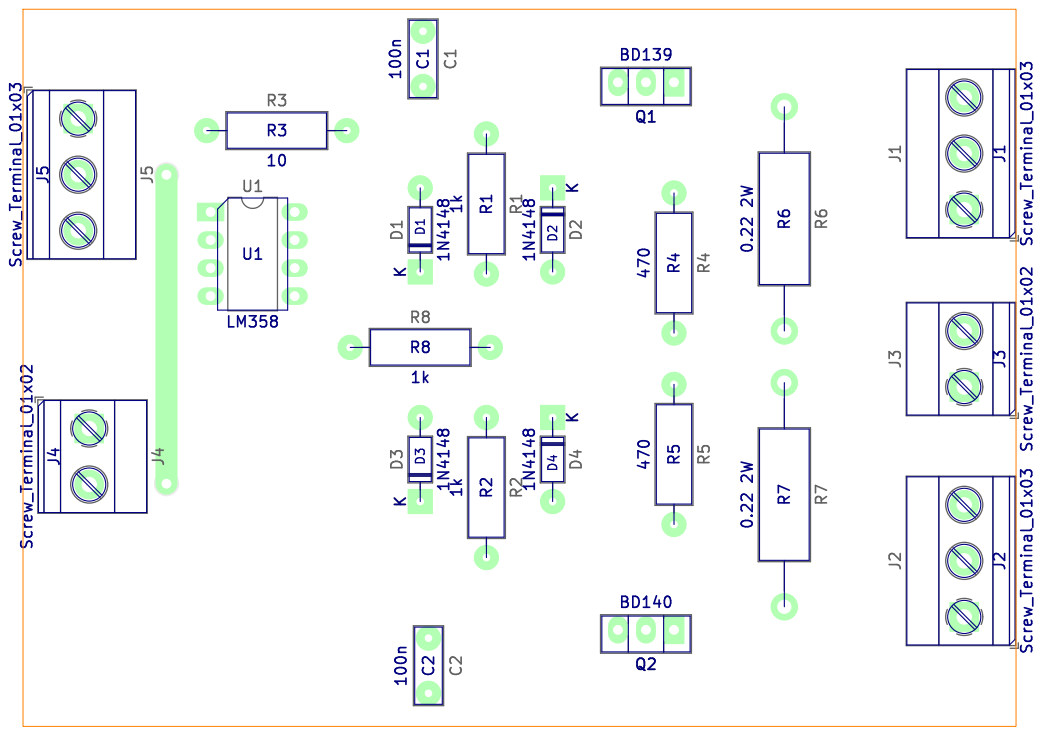
[picture p74: page 3]
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

1kR8 | BD140 Q2⁴⁷⁰ | R⁵ 1N⁴¹⁴⁸ D³ K ¹⁰⁰n | C¹

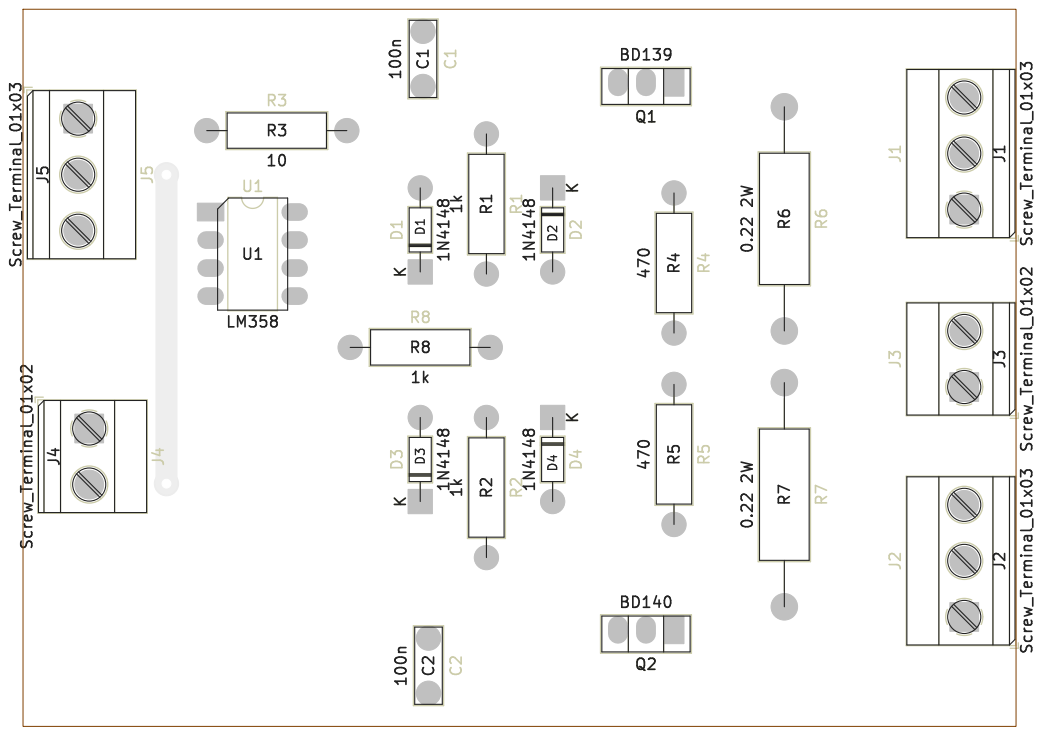
[picture p75: page 4]
