DinoDubroja/Power-amplifier/PCB/OLD/Class B test PCB/Class B test PCB/plots/Class B test PCB__Assembly.pdf

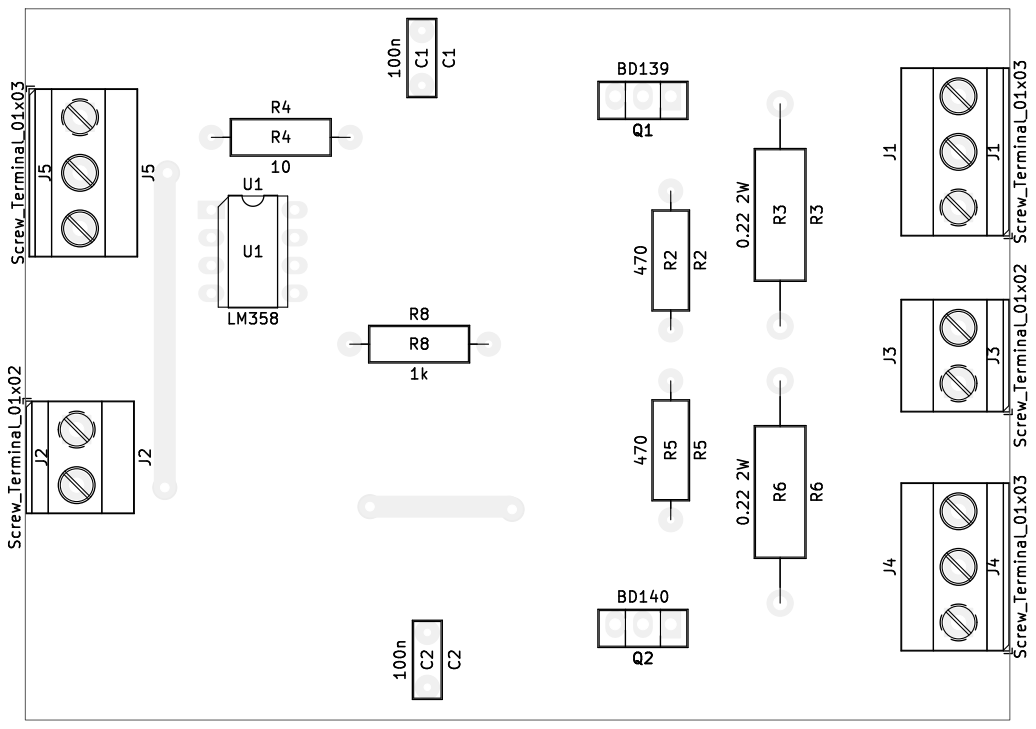
[picture p76: page 1]

R6 Q1 R5 C2 J2 R4 J3 J5 R3 R8 J1 U1 Q2 J4 R2 C1 1 2 3 4 5 6 1 2 3 4 5 6 ABCD ABCD Date: KiCad E.D.A. 8.0.0 Size: A4 Rev:

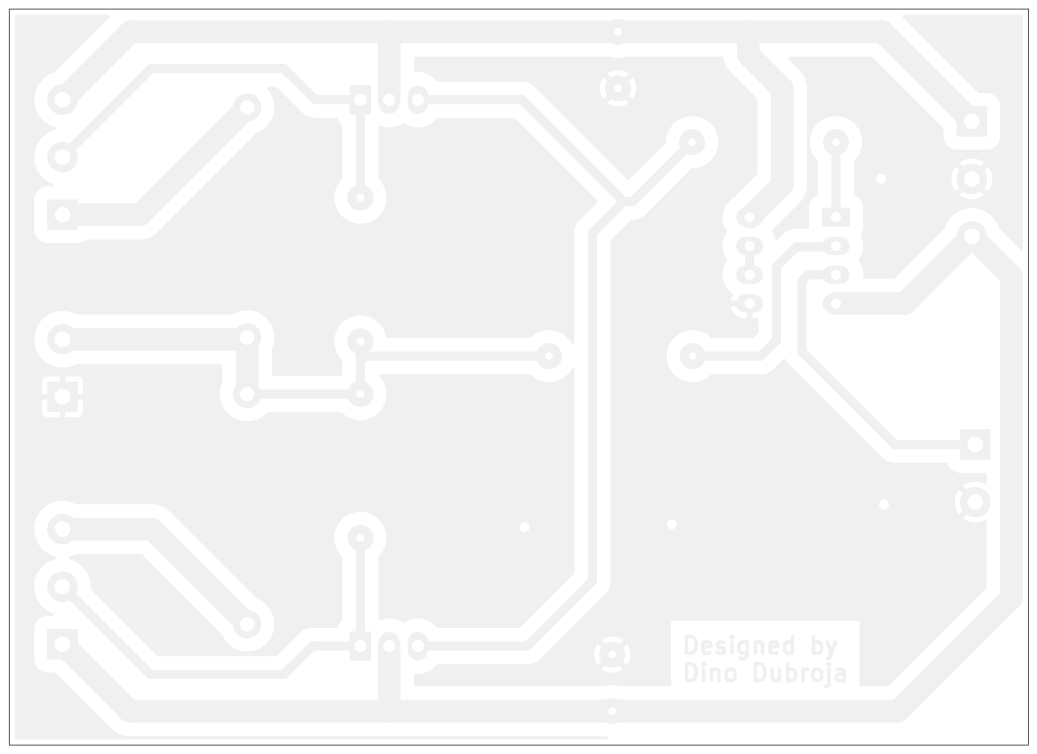
[picture p77: page 2]
Designed; by Dino; Dubroja; D Date: KiCad; E.D.A. 8.0.0 Size: A4; Rev:; Id: 1/1 Title: File: Class; B test; PCB.kicad_pcb Sheet: Black; And; White; BOT Board2Pdf:; Black; BOT -; Page 2/4

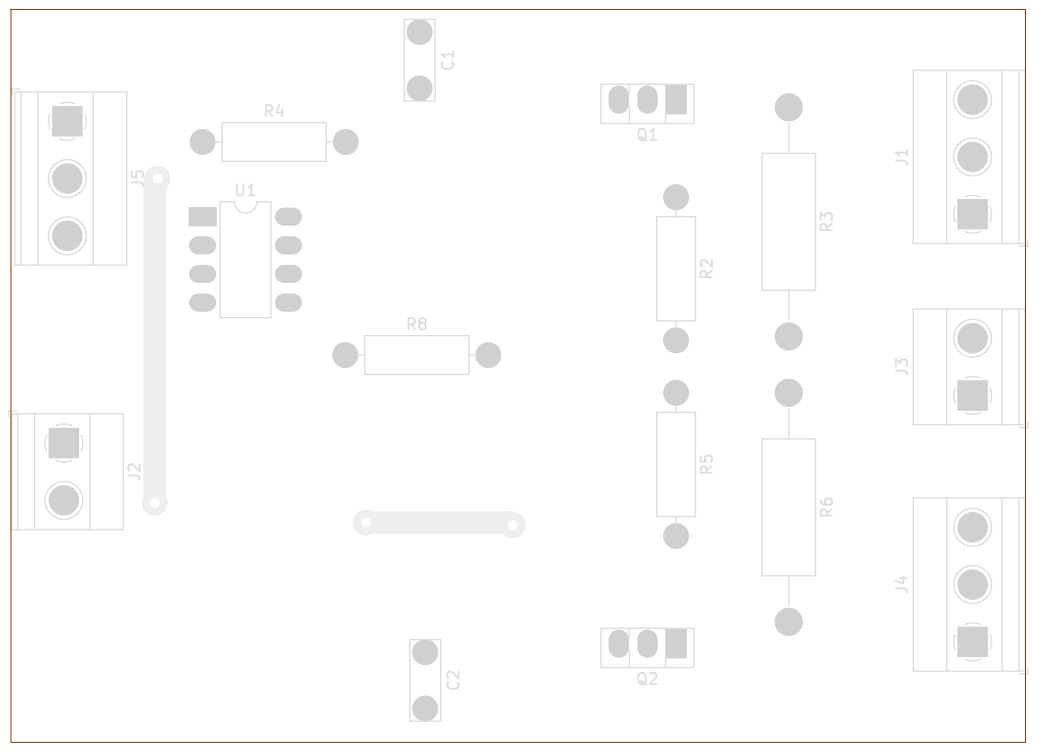
[picture p78: page 3]

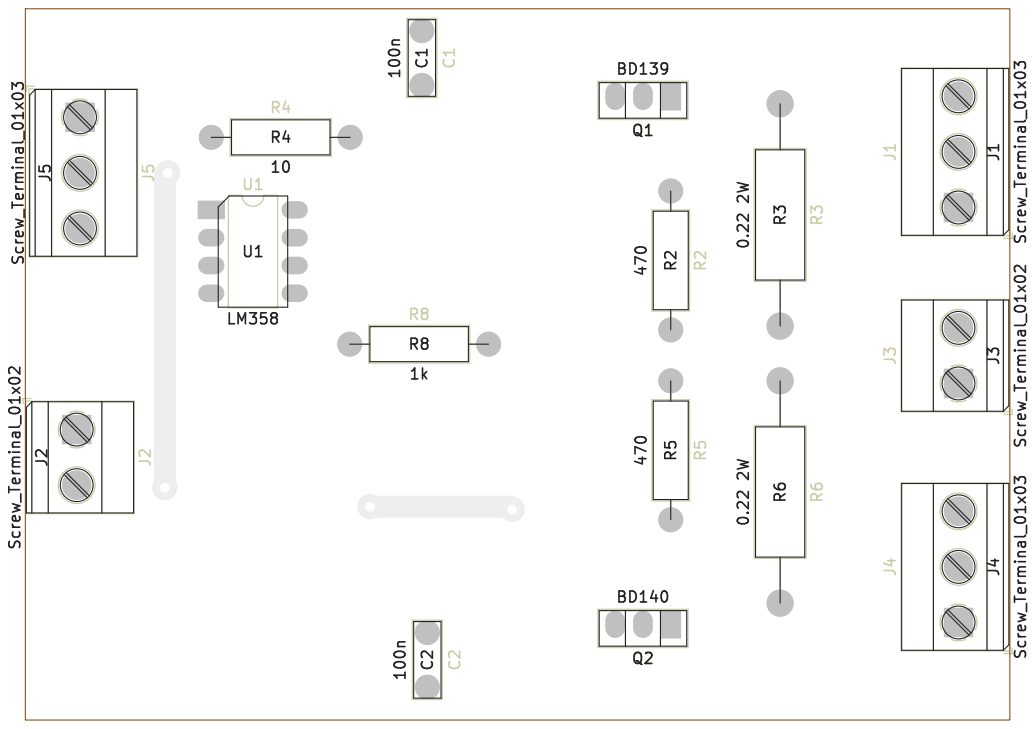
[picture p79: page 4]
