DinoDubroja/Power-amplifier/PCB/OLD/Class AB test PCB/pcb print.pdf

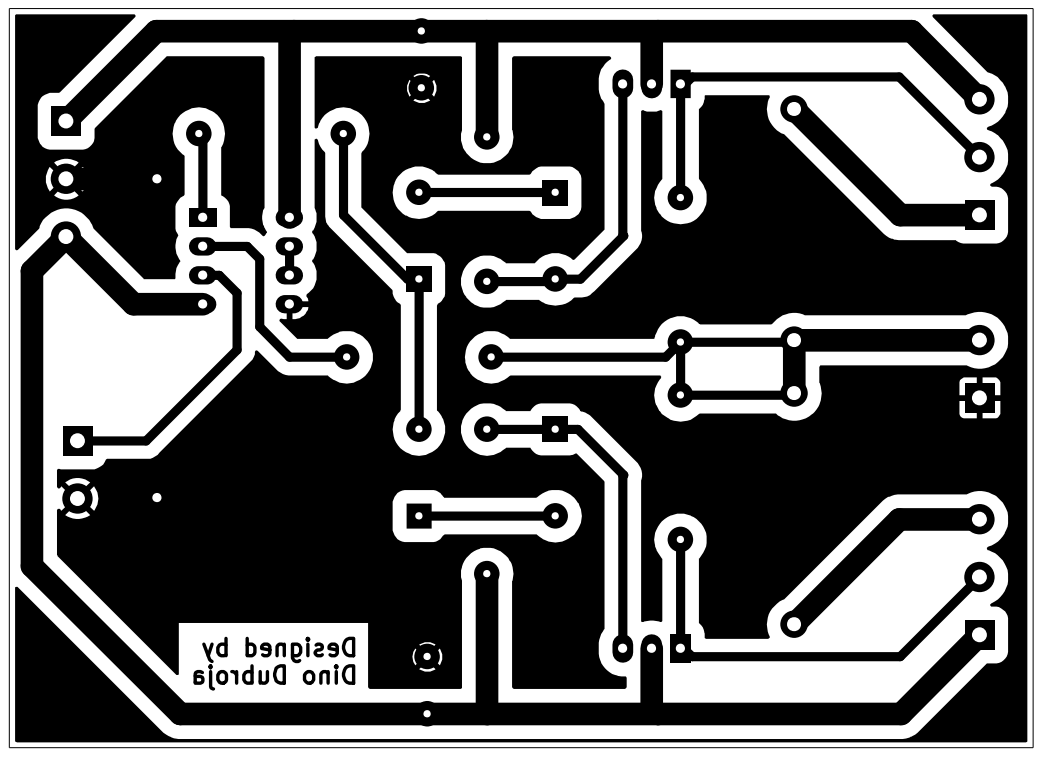
[picture p80: page 1]
