DinoDubroja/Power-amplifier/PCB/OLD/Class B test PCB/pcb print.pdf

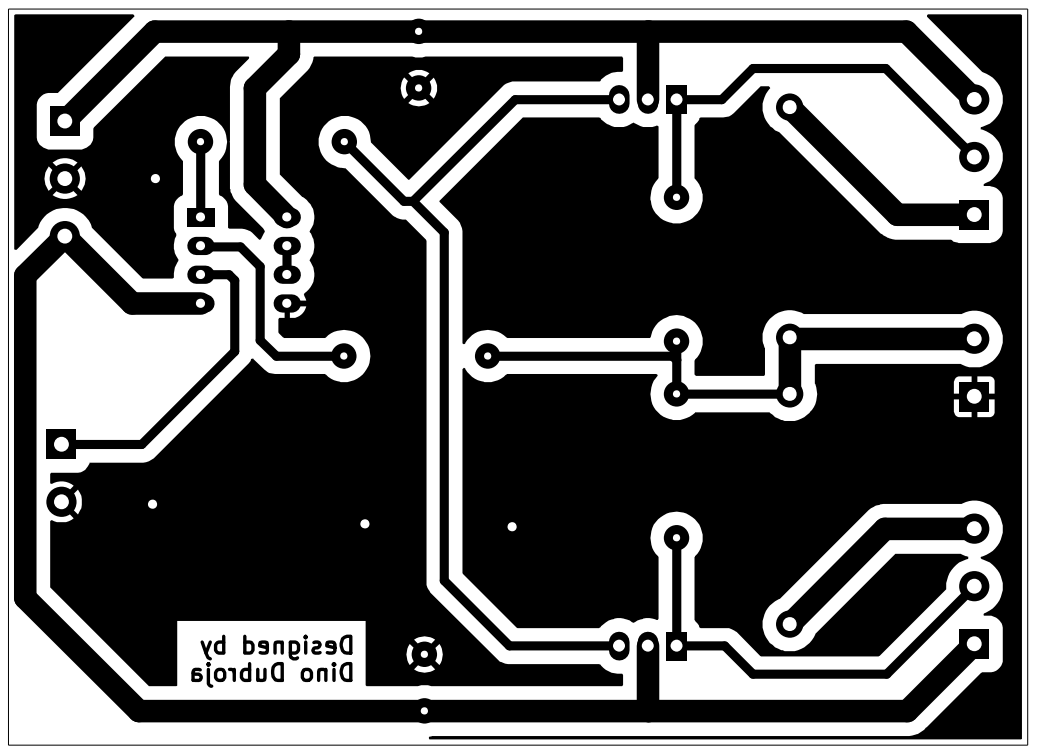
[picture p81: page 1]
