DinoDubroja/Power-amplifier/Simulation/Amplifier/Output stage - HV/V3 test.asc

C1: cap; 1µ
C2: cap; 47µ
Q1: npn; BD139
Q2: npn; BD139
Q3: npn; tip35c
Q4: pnp; tip36c
Q5: pnp; BD140
Q6: pnp; BD140
Q7: pnp; BD140
R1: res; 50
R2: res; 470
R3: res; 210
R4: res; {Re}
R5: res; {Re}
R6: res; 8
R7: res; 150
R8: res; 150
R9: res; 220
R12: res; 47
R13: res; 22k
R19: res; 22
V1: voltage; 0
V2: voltage; {Vcc}
V3: voltage; {Vcc}
Named nets: +V, -V, 0, Vout
Bias=Vbe*(1+r)
r=Ra/Rb
.param Rtot=1k
.param Ibias=1m
.param Vcc=30
.param Rcurrent = (2*Vcc/Ibias) - Rtot
;tran 1m
.tran 0 10m 0 0.5U
.option plotwinsize=0
.option numdgt = 7
.four 10000 20 100 V(Vout)
.INCLUDE OPA55X.LIB
.param Re=0.1 R1=r*Rpot R2=(1-r)*Rpot Rpot=10k
.param r 0.5
