DinoDubroja/Power-amplifier/Simulation/PSU/Current limit/Comparator/Comaprator - step response (capacitor).asc

C1: cap; 1µ
I1: current; PULSE(0.001m 10A 10m 0.0001m 0.0001m {pulse})
R1: res; 10k
R2: res; 10k
R3: res; 10k
R4: res; 0.1
R5: res; 10k
R6: res; {R}
U1: opamp2; OPA1692
V1: voltage; 18; Rser=0
V2: voltage; 18; Rser=0
Named nets: +V, 0, -V
.INCLUDE OPA1692.LIB
.param Rpot=(k/100)*Rpot0
.param R=10330 + Rpot Rpot0=380
.tran 50m
.param k=30
.step param pulse list 0.1m 1m 10m
