DinoDubroja/Power-amplifier/Simulation/PSU/Current limit v1.asc

A1: srflop; Vhigh=16
C1: cap; 100n
I1: current; PULSE(1 10 0.2 0.00001 0.00001 0.0000001)
M1: pmos; AO6407
R1: res; 1k
R2: res; 68k
R3: res; 1Meg
R4: res; 0.12
R5: res; 100k
R6: res; 1k
R7: res; 100
R8: res; 100k
R9: res; 1Meg
U1: opamp2; OPA1692
V1: voltage; PULSE(0 16 1 0.00001 0 0.00001)
V2: voltage; 16
V3: voltage; 16
Named nets: +V, 0, -V
.inc "C:\\Users\\dinod\\Desktop\\Audio amplifier & power supply\\Simulation\\PSU\\Current limit\\OPA1692.LIB"
.tran 2
