DinoDubroja/Power-amplifier/Simulation/Amplifier/SALLEN KEY/lowpass v1.asc

C1: cap; {C1}
C2: cap; {C2}
R1: res; {R1}
R2: res; {R2}
R3: res; 10
R4: res; 10k
U1: opamp2; OPA1692
V1: voltage; ""; AC 1
V2: voltage; 12
V3: voltage; 12
Named nets: 0, Vin, +V, -V, Vout
.incl OPA1692.LIB
.param C1=1n C2=2n R1=470 R2=470
.ac dec 100 1 10Meg
