DinoDubroja/Power-amplifier/Simulation/Amplifier/Output stage - HV/V3 - THD.asc

C1: cap; 1µ
C2: cap; 47µ
C3: cap; 1n
C4: cap; 1n
Q1: npn; BD139
Q2: npn; BD139
Q3: npn; tip35c
Q4: pnp; tip36c
Q5: pnp; BD140
Q6: pnp; BD140
Q7: pnp; BD140
Q9: npn; BD139
Q10: npn; BD139
R1: res; 0.0001
R2: res; 470
R3: res; 210
R4: res; {Re}
R5: res; {Re}
R6: res; 8
R7: res; 150
R8: res; 150
R9: res; 220
R10: res; 9k
R11: res; 1
R12: res; 47
R13: res; 22k
R15: res; 1K
R16: res; 100
R17: res; 100
R18: res; 47
R19: res; 22k
U1: opamp2; OPA55X
V1: voltage; SINE(0 1 10K)
V2: voltage; {Vcc}
V3: voltage; {Vcc}
Named nets: +V, -V, 0, Vout
Bias=Vbe*(1+r)
r=Ra/Rb
.param Rtot=1k
.param Ibias=1m
.param Vcc=30
.param Rcurrent = (2*Vcc/Ibias) - Rtot
.param Re=0.1
;tran 1m
.tran 0 100m 0 0.5U
.option plotwinsize=0
.option numdgt = 7
.four 10000 20 100 V(Vout)
.INCLUDE OPA55X.LIB
