DinoDubroja/Power-amplifier/Simulation/Amplifier/Output stage - HV/Draft2.asc

C1: cap; 100µ
D1: LED; NSCW100
D2: schottky; 1N5819
D3: schottky; 1N5819
D4: schottky; 1N5819
D5: schottky; 1N5819
L1: ind; 20µ
Q1: npn
Q2: pnp
R1: res; 1
R2: res; 100k
R3: res; 22k
R4: res; 470k
R5: res; 100k
V1: voltage; SINE(0 315 50)
Named nets: L, N, PE, +V, 0, V-
.tran 100m
