DinoDubroja/Power-amplifier/Simulation/Amplifier/Output stage - HV/Draft1.asc

C1: cap; 1µ
C2: cap; 47µ
C3: cap; 1n
C4: cap; 1n
L1: ind; {L}
L2: ind; {L}
L3: ind; {L}
L4: ind; {L}
L5: ind; {L}
L6: ind; {L}
L7: ind; {L}
L8: ind; {L}
L9: ind; {L}
L10: ind; {L}
L11: ind; {L}
L12: ind; {L}
L13: ind; {L}
Q1: npn; BD139
Q2: npn; BD139
Q3: npn; tip35c
Q4: pnp; tip36c
Q5: pnp; BD140
Q6: pnp; BD140
Q7: pnp; BD140
R1: res; 470
R2: res; 210
R3: res; {Re}
R4: res; {Re}
R5: res; 8
R6: res; 150
R7: res; 150
R8: res; 470
R9: res; 47
R10: res; 22k
R11: res; 50
R12: res; 100
R13: res; 100
V1: voltage; {Vcc}
V2: voltage; {Vcc}
V3: voltage; ""; AC 5
Named nets: +V, -V, 0, Vout, Vin
.param Rtot=1k
.param Ibias=1m
.param Vcc=30
.param Rcurrent = (2*Vcc/Ibias) - Rtot
.ac dec 100 0.1 100Meg
.option plotwinsize=0
.option numdgt = 7
.four 10000 20 100 V(Vout)
.param Re=0.1 R1=r*Rpot R2=(1-r)*Rpot Rpot=10k
.param r=0.5 L=0.001n
