DinoDubroja/Power-amplifier/Simulation/Amplifier/Output stage - HV/V3 inductance - AC.asc

C1: cap; 1µ
C2: cap; 47µ
C3: cap; 100p
L1: ind; {L}
L2: ind; {L}
L3: ind; {L}
L4: ind; {L}
L5: ind; {L}
L6: ind; {L}
L7: ind; {L}
L8: ind; {L}
L9: ind; {L}
Q1: npn; BD139
Q2: npn; BD139
Q3: npn; tip35c
Q4: pnp; tip36c
Q5: pnp; BD140
Q6: pnp; BD140
Q7: pnp; BD140
Q8: npn; BD139
R1: res; 0.0001
R2: res; 470
R3: res; 210
R4: res; {Re}
R5: res; {Re}
R6: res; 8
R7: res; 150
R8: res; 150
R9: res; 470
R10: res; 1k
R11: res; 100
R12: res; 47
R13: res; 22k
R14: res; 1k
R15: res; 470
R16: res; {R2}
R17: res; {R1}
R18: res; 1Meg
R19: res; 1k
U1: opamp2; OPA55X
V1: voltage; ""; AC 5
V2: voltage; {Vcc}
V3: voltage; {Vcc}
Named nets: +V, -V, 0, Vout, Vin
Bias=Vbe*(1+r)
r=Ra/Rb
.param Rtot=1k
.param Ibias=1m
.param Vcc=30
.param Rcurrent = (2*Vcc/Ibias) - Rtot
;tran 1m
.ac dec 100 0.1 10Meg
.option plotwinsize=0
.option numdgt = 7
.four 10000 20 100 V(Vout)
.INCLUDE OPA55X.LIB
.param Re=0.1 R1=r*Rpot R2=(1-r)*Rpot Rpot=10k
.param r=0.5 L=100n
