DinoDubroja/Power-amplifier/Simulation/Amplifier/Output stage - LV/DC.asc

C1: cap; 1µ
C2: cap; 47µ
Q1: npn; BD139
Q2: npn; BD139
Q3: npn; tip35c
Q4: pnp; tip36c
Q5: pnp; BD140
Q6: npn
R1: res; 0.0001
R2: res; 470
R3: res; 210
R4: res; 1k
R5: res; {Re}
R6: res; {Re}
R7: res; 8
R8: res; 220
R9: res; 100
R10: res; 150
R11: res; 150
V1: voltage; 0
V2: voltage; {Vcc}
V3: voltage; {Vcc}
Named nets: +V, -V, 0, Vout
Bias=Vbe*(1+r)
r=Ra/Rb
.param Rtot=1k
.param Ibias=1m
.param Vcc=18
.param Rcurrent = (2*Vcc/Ibias) - Rtot
.param Re=0.1
;tran 1m
.tran 0 100m 0 1u
.option plotwinsize=0
.option numdgt = 7
.four 10000 20 100 V(Vout)
