DinoDubroja/Power-amplifier/Simulation/Amplifier/Output stage - LV/Direct drive.asc

C1: cap; 1µ
Q2: npn; BD139
Q3: npn; tip35c
Q4: pnp; tip36c
Q5: pnp; BD140
R1: res; 0.0001
R5: res; {Re}
R6: res; {Re}
R7: res; 8
R8: res; 220
R12: res; 10
U1: opamp2; OPA1692
V1: voltage; 0
V2: voltage; {Vcc}
V3: voltage; {Vcc}
Named nets: +V, -V, 0, Vout
.param Rtot=1k
.param Ibias=1m
.param Vcc=18
.param Rcurrent = (2*Vcc/Ibias) - Rtot
.param Re=0.1
;tran 1m
.tran 0 100m 0 0.5U
.option plotwinsize=0
.option numdgt = 7
.four 10000 20 100 V(Vout)
.INCLUDE OPA1692.LIB
