DinoDubroja/Power-amplifier/Simulation/Amplifier/Output stage - LV/Draft1.asc

Q1: npn; BD139
Q2: npn; 2N2222
R1: res; 1k
R2: res; 2.2k
R3: res; 0.0001
R4: res; 1k
R5: res; 2.2k
R6: res; 0.0001
R7: res; 10k
V1: voltage; {Vcc}
V2: voltage; {Vcc}
V3: voltage; SINE(0 2 1k)
V4: voltage; SINE(0 2 10k)
Named nets: 0, +V, -V, Vout
.param Rtot=1k
.param Ibias=1m
.param Vcc=18
.param Rcurrent = (2*Vcc/Ibias) - Rtot
.param Re=0.1
.tran 0 100m 0 0.5U
.option plotwinsize=0
.option numdgt = 7
.four 10000 20 100 V(Vout)
;tran 1m
;tran 1m
