DinoDubroja/Power-amplifier/Simulation/Amplifier/Output stage - LV/V2 AC.asc

C1: cap; 1µ
C2: cap; 47µ
Q1: npn; BD139
Q2: npn; BD139
Q3: npn; tip35c
Q4: pnp; tip36c
Q5: pnp; BD140
Q7: npn; BD139
R1: res; 0.0001
R2: res; 470
R3: res; 210
R4: res; 1K
R5: res; {Re}
R6: res; {Re}
R7: res; 8
R8: res; 220
R9: res; 1k
R10: res; 10
R11: res; 10
R12: res; 10
R13: res; 10
R15: res; 1k
U1: opamp2; OPA1692
V1: voltage; SINE(0 5 10k); AC 5
V2: voltage; {Vcc}
V3: voltage; {Vcc}
Named nets: +V, -V, 0, Vout, NFB, Vin
Bias=Vbe*(1+r)
r=Ra/Rb
.param Rtot=1k
.param Ibias=1m
.param Vcc=18
.param Rcurrent = (2*Vcc/Ibias) - Rtot
.param Re=0.1
;tran 1m
.ac dec 100 100m 10Meg
.option plotwinsize=0
.option numdgt = 7
.four 10000 20 100 V(Vout)
.INCLUDE OPA1692.LIB
