DinoDubroja/Power-amplifier/Simulation/PSU/Rectifier/Rectifier comparison.asc

C1: cap; 1000µ
C2: cap; 1000µ
C3: cap; 1000µ
C4: cap; 1000µ
D1: diode
D2: diode
D3: diode
D4: diode
D5: diode
D6: diode
R1: res; 100
R2: res; 100
R3: res; 100
R4: res; 100
V1: voltage; SINE(0 21 50)
V2: voltage; SINE(0 21 50)
V3: voltage; SINE(0 21 50)
V4: voltage; SINE(0 21 50)
Named nets: 0, V+, V-
.tran 200m
