DinoDubroja/Power-amplifier/Simulation/PSU/Regulator/Positive/High current reg.asc

C1: cap; 1µ
C2: cap; 0.1µ
Q1: pnp; BD140
Q2: npn; tip35c
R1: res; {R1}
R2: res; {R2}
R3: res; 47
R4: res; 4.7k
R5: res; 470
R6: res; 0
R7: res; 4
U1: LM317_TRANS
V1: voltage; SINE(0 0 50)
V2: voltage; 21
Named nets: 0
.param R1=1000 R2=13k
.tran 1
.include LM317_TRANS
