DinoDubroja/Power-amplifier/Simulation/PSU/Current limit/Comparator/Draft1.asc

A1: srflop; Vhigh=0 Vlow=-17.5
C1: cap; 100n
C2: cap; 100n
I1: current; PULSE(0.001m 10A 10m 100m 100m 1m)
M1: nmos; Si7336ADP
R1: res; 10k
R2: res; 10k
R3: res; 0.1
R4: res; 10k
R5: res; 10k
R6: res; {R}
R7: res; 100
R8: res; 1
U1: opamp2; OPA1692
V1: voltage; 18; Rser=0
V2: voltage; 18; Rser=0
Named nets: -V, 0, +V
.INCLUDE OPA1692.LIB
.param Rpot=(k/100)*Rpot0
.param R=10330 + Rpot Rpot0=380
.tran 10m
.param k=30
