DinoDubroja/Power-amplifier/Simulation/PSU/Regulator/Negative/High current - negative.asc

C1: cap; 0.1µ
Q1: npn; BD139
Q2: pnp; tip36c
R1: res; 22
R2: res; 4.7k
R3: res; 470
R4: res; 1000
R5: res; 12000
R6: res; 10
U1: LM337_N_TRANS
V1: voltage; SINE(0 0 50)
V2: voltage; -21
Named nets: 0
.tran 1
