DinoDubroja/Power-amplifier/(list of files, drawings)

Other design files:
Mechanical/Models/LIB_4DB-P108-05/4DB-P108-05/Altium/4DB-P108-05.SchLib
Mechanical/Models/LIB_4DB-P108-05/4DB-P108-05/Altium/4DBP10805.PcbLib
OLD/Simulation V2/Models/sbomaf3d/OPA1692.OLB
OLD/Simulation V2/Models/sbomaf3d/OPA1692_Test_Circuit.DSN
OLD/Simulation V2/Models/sbomaf3d/OPA1692_Test_Circuit.OPJ
Simulation/OPA552 PSPICE/OPA55x.OLB
Simulation/OPA552 PSPICE/OPA55x_Test_Circuit.DSN
Simulation/OPA552 PSPICE/OPA55x_Test_Circuit.OPJ
Simulation/PSU/sbomaf3d/OPA1692.OLB
Simulation/PSU/sbomaf3d/OPA1692_Test_Circuit.DSN
Simulation/PSU/sbomaf3d/OPA1692_Test_Circuit.OPJ
