DinoDubroja/Power-amplifier/PCB/Amplifier/Amplifier/Amplifier.kicad_pcb

## KiCad design PCB/Amplifier/Amplifier/Amplifier.kicad_pcb (2025-10-12)

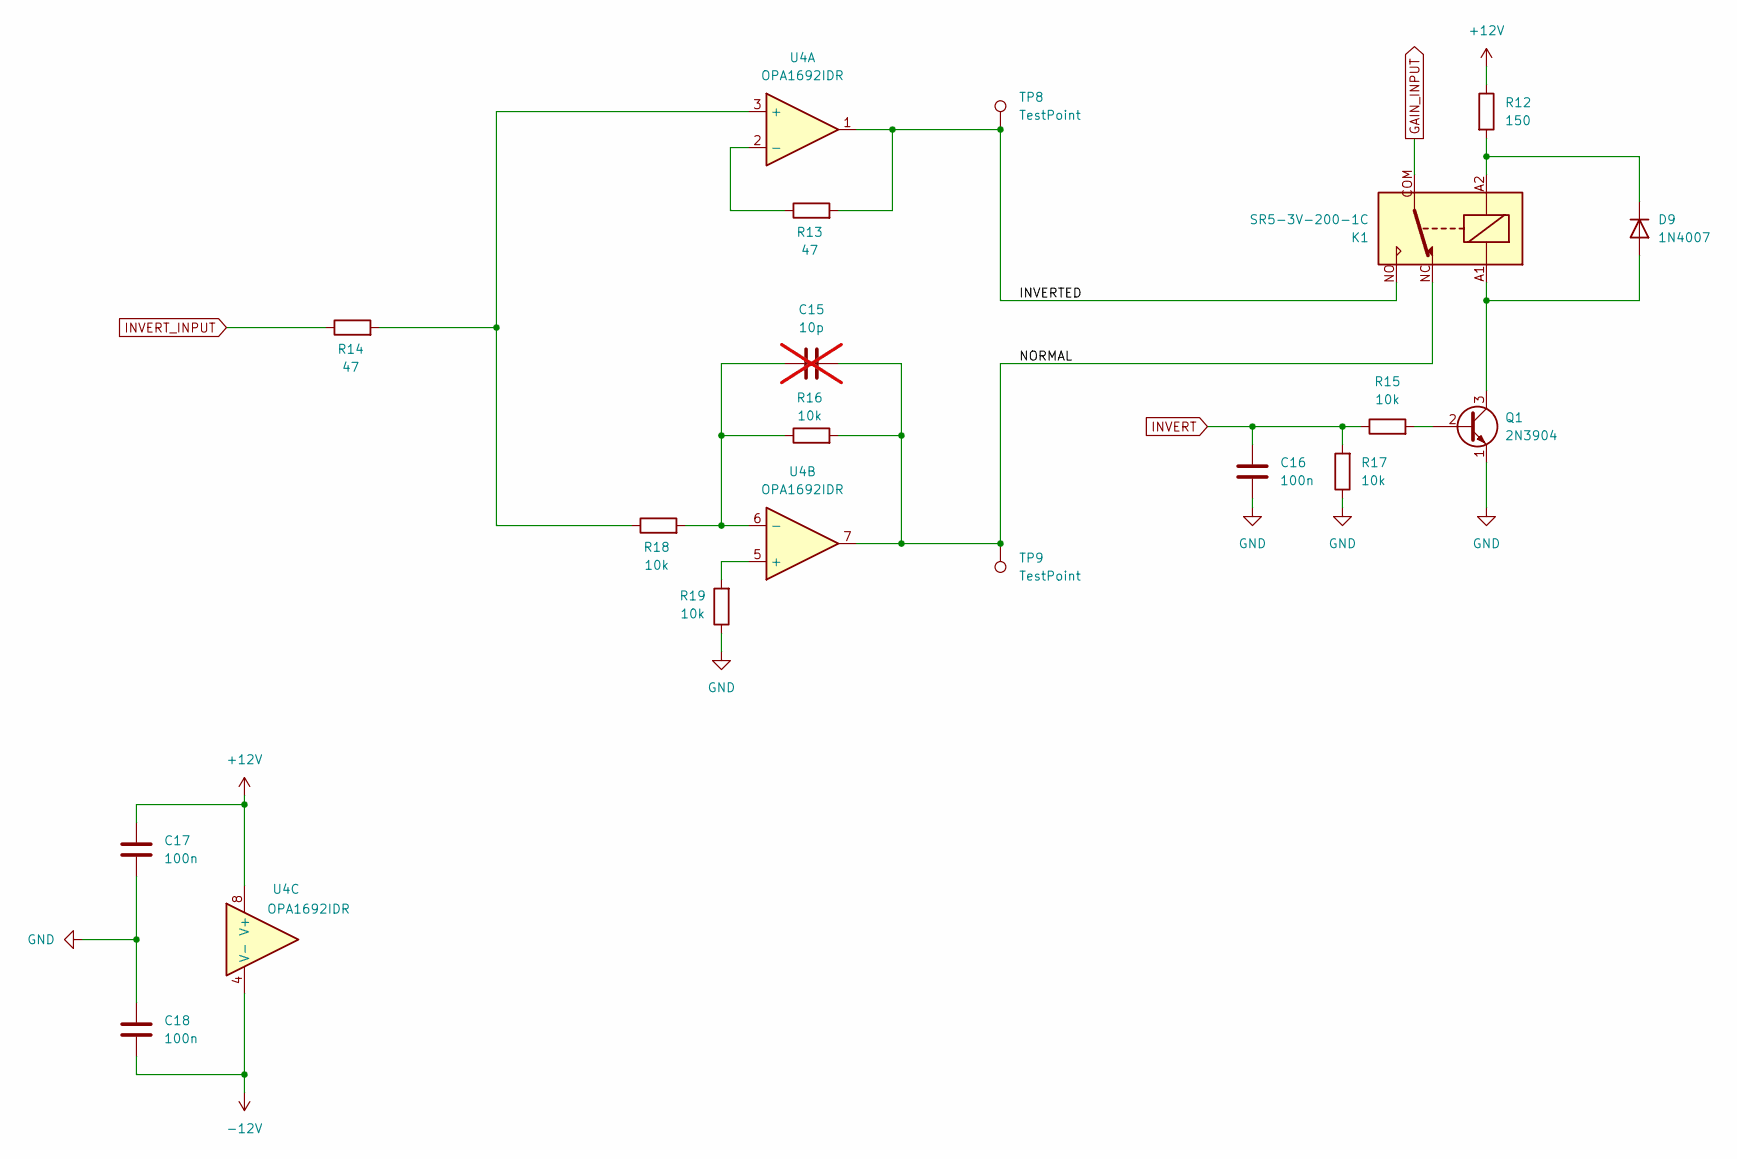
[picture p82: schematic invert_stage.kicad_sch, Invert stage]

Parts:
C15: 10p; C_Disc_D4.3mm_W1.9mm_P5.00mm; not fitted
C16, C17, C18: 100n; C_Disc_D4.3mm_W1.9mm_P5.00mm
D9: 1N4007; D_DO-15_P10.16mm_Horizontal
K1: SR5-3V-200-1C; SR53V2001C; Manufacturer_Part_Number SR5-3V-200-1C; Mouser Part Number 179-SR5-3V-200-1C
Q1: 2N3904; TO-92_Inline
R12: 150; R_Axial_DIN0207_L6.3mm_D2.5mm_P10.16mm_Horizontal
R13, R14: 47; R_Axial_DIN0207_L6.3mm_D2.5mm_P10.16mm_Horizontal
R15, R16, R17, R18, R19: 10k; R_Axial_DIN0207_L6.3mm_D2.5mm_P10.16mm_Horizontal
TP8, TP9: TestPoint; Pin_D1.2mm_L11.3mm_W3.0mm_Flat
U4: OPA1692IDR; SOIC127P600X175-8N; Manufacturer_Part_Number OPA1692IDR; Mouser Part Number 595-OPA1692IDR

Connections:
+12V: C17.1, R12.1, U4.8 (V+); also elsewhere on the board
-12V: C18.2, U4.4 (V-); also elsewhere on the board
/Invert stage/INVERTED: K1.NO, R13.2, TP8.1, U4.1
/Invert stage/NORMAL: C15.2, K1.NC, R16.2, TP9.1, U4.7
GAIN_INPUT: K1.COM; also elsewhere on the board
GND: C16.2, C17.2, C18.1, Q1.1 (E), R17.1, R19.1; also elsewhere on the board
INVERT: C16.1, R15.1, R17.2; also elsewhere on the board
INVERT_INPUT: R14.1; also elsewhere on the board
unnamed: D9.2 (A), K1.A1, Q1.3 (C)
unnamed: D9.1 (K), K1.A2, R12.2
unnamed: Q1.2 (B), R15.2
unnamed: R14.2, R18.1, U4.3 (+)
unnamed: R13.1, U4.2 (-)
unnamed: R19.2, U4.5 (+)
unnamed: C15.1, R16.1, R18.2, U4.6 (-)

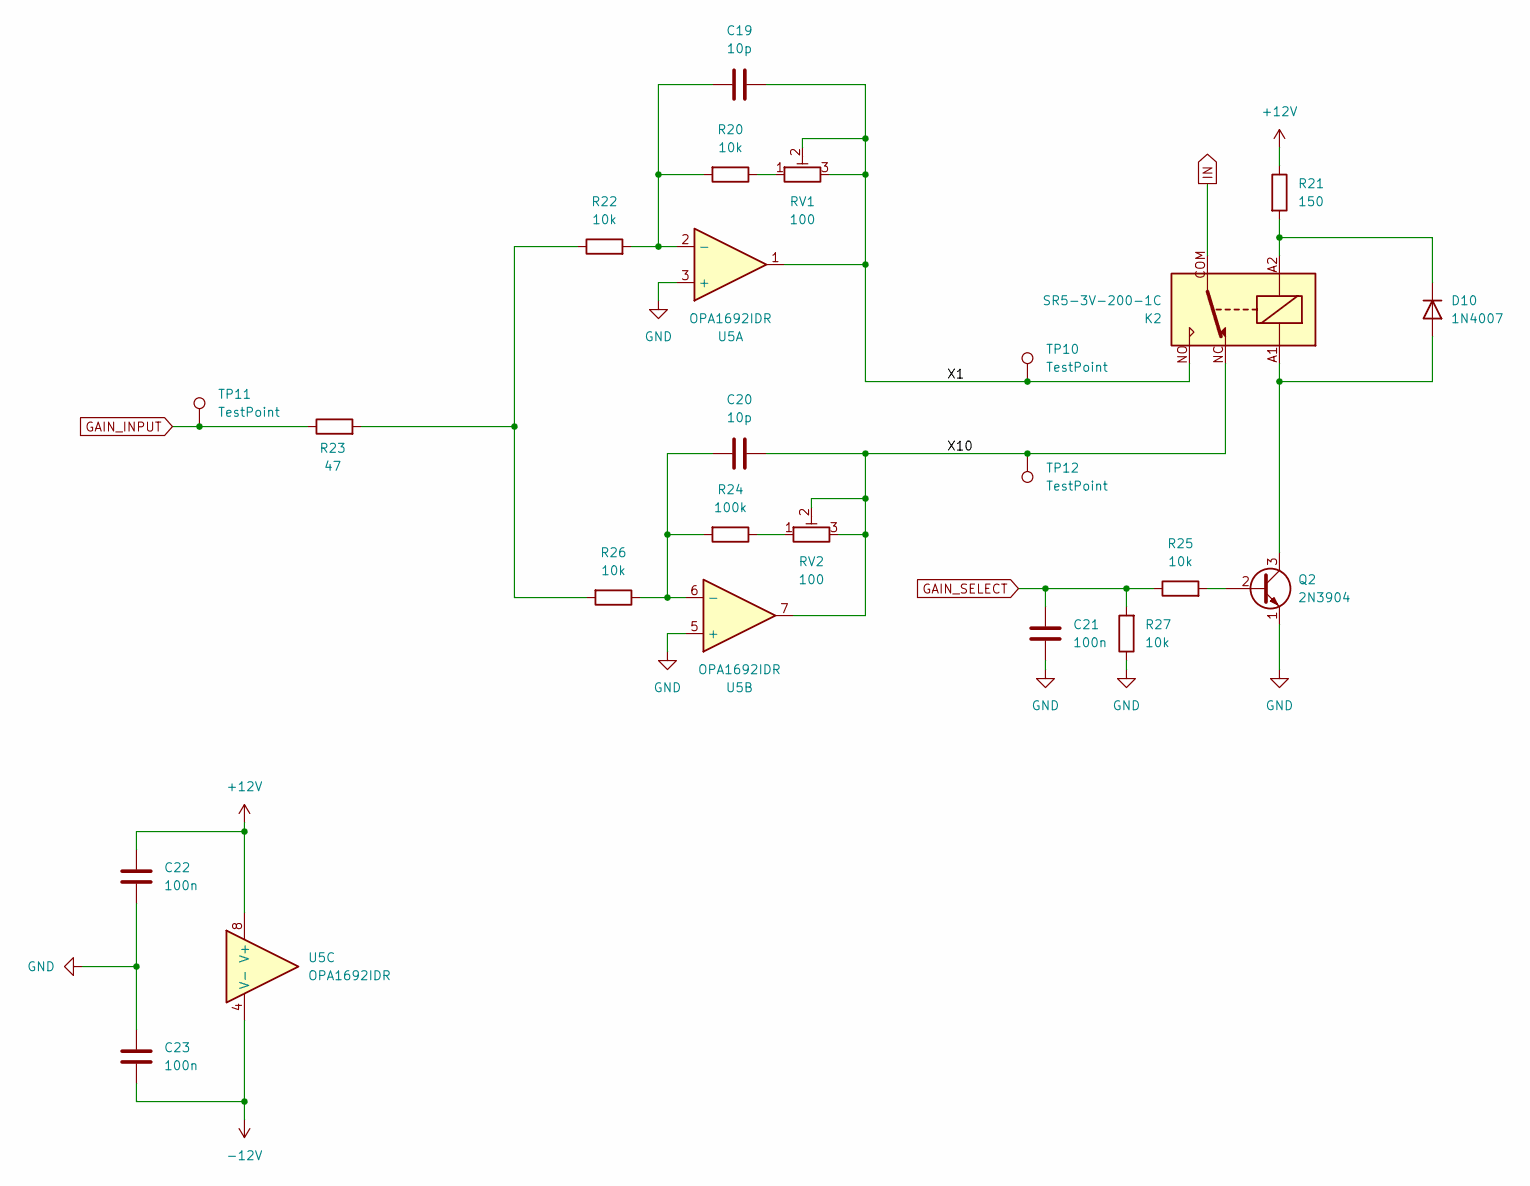
[picture p83: schematic gain_stage.kicad_sch, Gain stage]

Parts:
C19, C20: 10p; C_Disc_D4.3mm_W1.9mm_P5.00mm
C21, C22, C23: 100n; C_Disc_D4.3mm_W1.9mm_P5.00mm
D10: 1N4007; D_DO-15_P10.16mm_Horizontal
K2: SR5-3V-200-1C; SR53V2001C; Manufacturer_Part_Number SR5-3V-200-1C; Mouser Part Number 179-SR5-3V-200-1C
Q2: 2N3904; TO-92_Inline
R20, R22, R25, R26, R27: 10k; R_Axial_DIN0207_L6.3mm_D2.5mm_P10.16mm_Horizontal
R21: 150; R_Axial_DIN0207_L6.3mm_D2.5mm_P10.16mm_Horizontal
R23: 47; R_Axial_DIN0207_L6.3mm_D2.5mm_P10.16mm_Horizontal
R24: 100k; R_Axial_DIN0207_L6.3mm_D2.5mm_P10.16mm_Horizontal
RV1, RV2: 100; Potentiometer_Bourns_3296W_Vertical
TP10, TP11, TP12: TestPoint; Pin_D1.2mm_L11.3mm_W3.0mm_Flat
U5: OPA1692IDR; SOIC127P600X175-8N; Manufacturer_Part_Number OPA1692IDR; Mouser Part Number 595-OPA1692IDR

Connections:
+12V: C22.1, R21.1, U5.8 (V+); also elsewhere on the board
-12V: C23.2, U5.4 (V-); also elsewhere on the board
/Gain stage/X1: C19.2, K2.NO, RV1.2, RV1.3, TP10.1, U5.1
/Gain stage/X10: C20.2, K2.NC, RV2.2, RV2.3, TP12.1, U5.7
GAIN_INPUT: R23.1, TP11.1; also elsewhere on the board
GAIN_SELECT: C21.1, R25.1, R27.2; also elsewhere on the board
GND: C21.2, C22.2, C23.1, Q2.1 (E), R27.1, U5.3 (+), U5.5 (+); also elsewhere on the board
IN: K2.COM; also elsewhere on the board
unnamed: D10.2 (A), K2.A1, Q2.3 (C)
unnamed: D10.1 (K), K2.A2, R21.2
unnamed: Q2.2 (B), R25.2
unnamed: R20.1, RV1.1
unnamed: R22.1, R23.2, R26.2
unnamed: R24.1, RV2.1
unnamed: C19.1, R20.2, R22.2, U5.2 (-)
unnamed: C20.1, R24.2, R26.1, U5.6 (-)

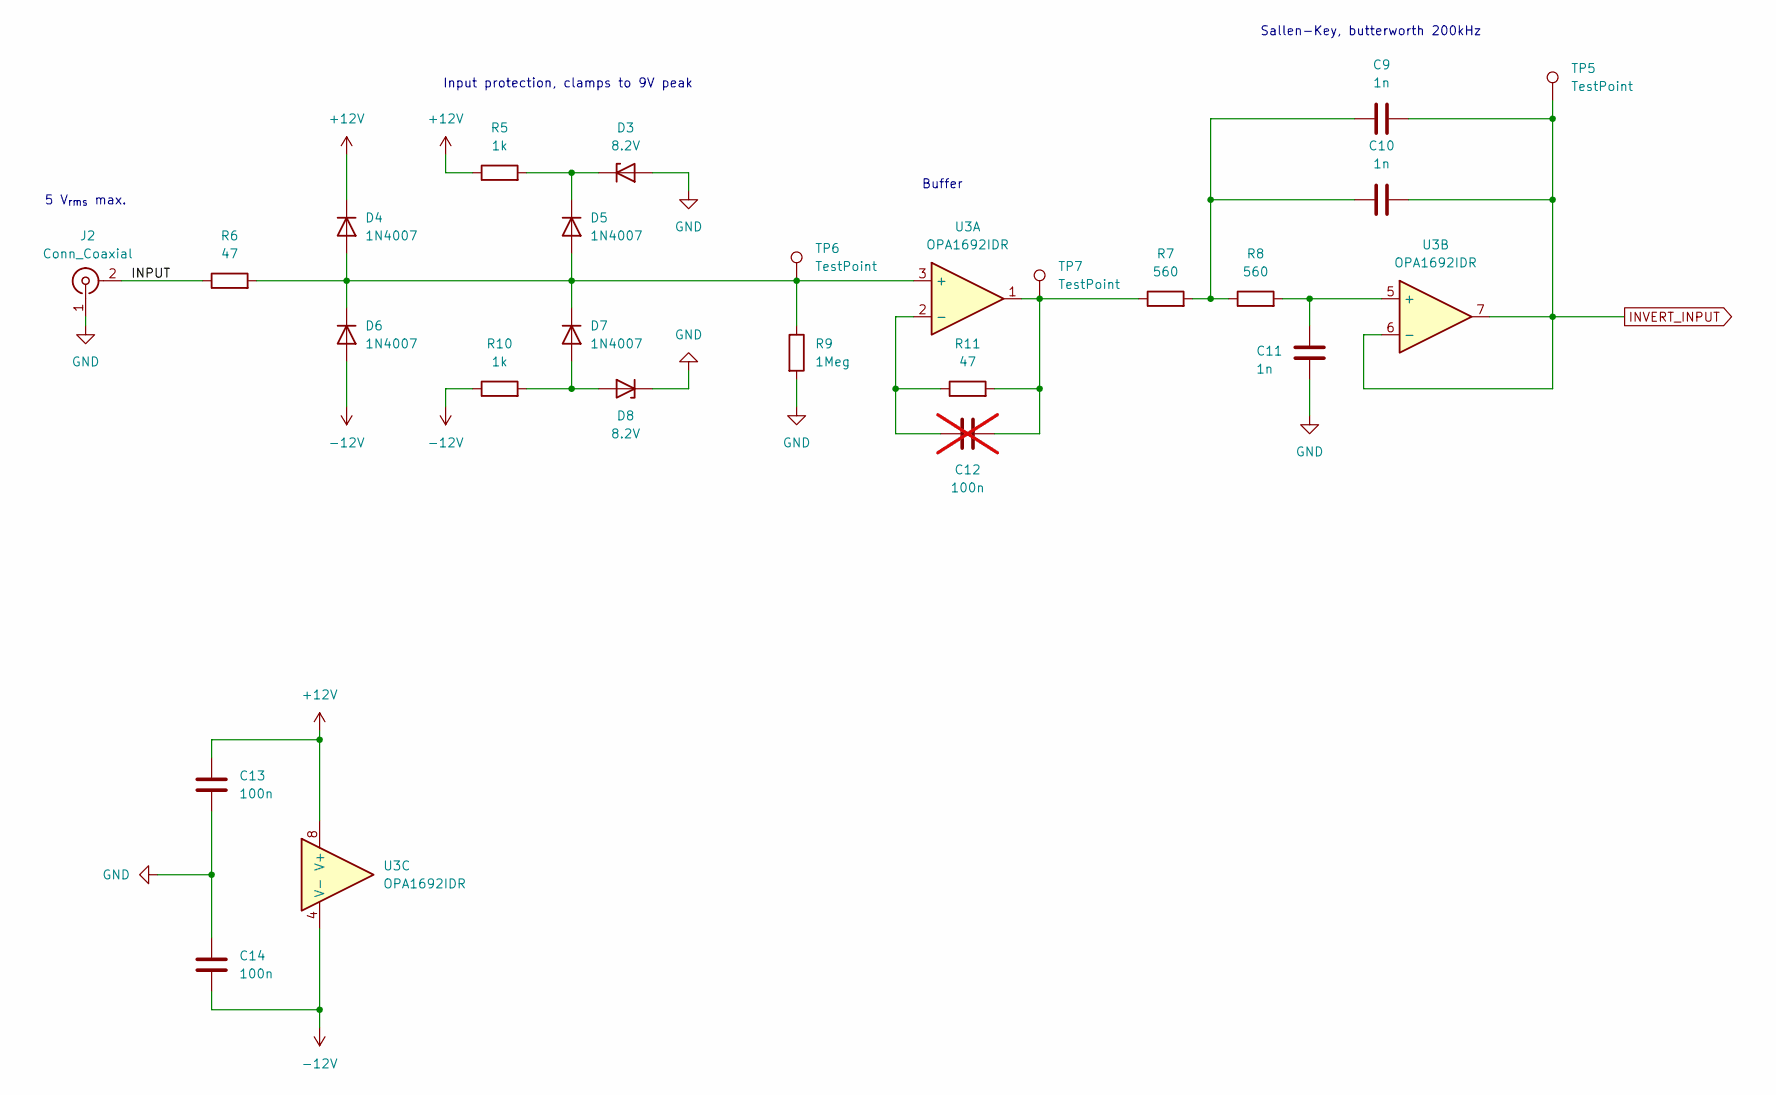
[picture p84: schematic input_stage.kicad_sch, Input stage]

Parts:
C9, C10, C11: 1n; C_Rect_L7.2mm_W2.5mm_P5.00mm_FKS2_FKP2_MKS2_MKP2
C12: 100n; C_Disc_D4.3mm_W1.9mm_P5.00mm; not fitted
C13, C14: 100n; C_Disc_D4.3mm_W1.9mm_P5.00mm
D3, D8: 8.2V; D_DO-35_SOD27_P10.16mm_Horizontal
D4, D5, D6, D7: 1N4007; D_DO-15_P10.16mm_Horizontal
J2: Conn_Coaxial; 52220061
R5, R10: 1k; R_Axial_DIN0207_L6.3mm_D2.5mm_P10.16mm_Horizontal
R6, R11: 47; R_Axial_DIN0207_L6.3mm_D2.5mm_P10.16mm_Horizontal
R7, R8: 560; R_Axial_DIN0207_L6.3mm_D2.5mm_P10.16mm_Horizontal
R9: 1Meg; R_Axial_DIN0207_L6.3mm_D2.5mm_P10.16mm_Horizontal
TP5, TP6, TP7: TestPoint; Pin_D1.2mm_L11.3mm_W3.0mm_Flat
U3: OPA1692IDR; SOIC127P600X175-8N; Manufacturer_Part_Number OPA1692IDR; Mouser Part Number 595-OPA1692IDR

Connections:
+12V: C13.1, D4.1 (K), R5.1, U3.8 (V+); also elsewhere on the board
-12V: C14.2, D6.2 (A), R10.1, U3.4 (V-); also elsewhere on the board
/Input stage/INPUT: J2.2 (Ext), R6.1
GND: C11.2, C13.2, C14.1, D3.2 (A), D8.1 (K), J2.1 (In), R9.2; also elsewhere on the board
INVERT_INPUT: C9.2, C10.2, TP5.1, U3.6 (-), U3.7; also elsewhere on the board
unnamed: C9.1, C10.1, R7.2, R8.1
unnamed: C12.2, R7.1, R11.2, TP7.1, U3.1
unnamed: D3.1 (K), D5.1 (K), R5.2
unnamed: D4.2 (A), D5.2 (A), D6.1 (K), D7.1 (K), R6.2, R9.1, TP6.1, U3.3 (+)
unnamed: D7.2 (A), D8.2 (A), R10.2
unnamed: C12.1, R11.1, U3.2 (-)
unnamed: C11.1, R8.2, U3.5 (+)

Notes on the sheet:
Input protection, clamps to 9V peak
5 V_{rms} max.
Buffer
Sallen-Key, butterworth 200kHz

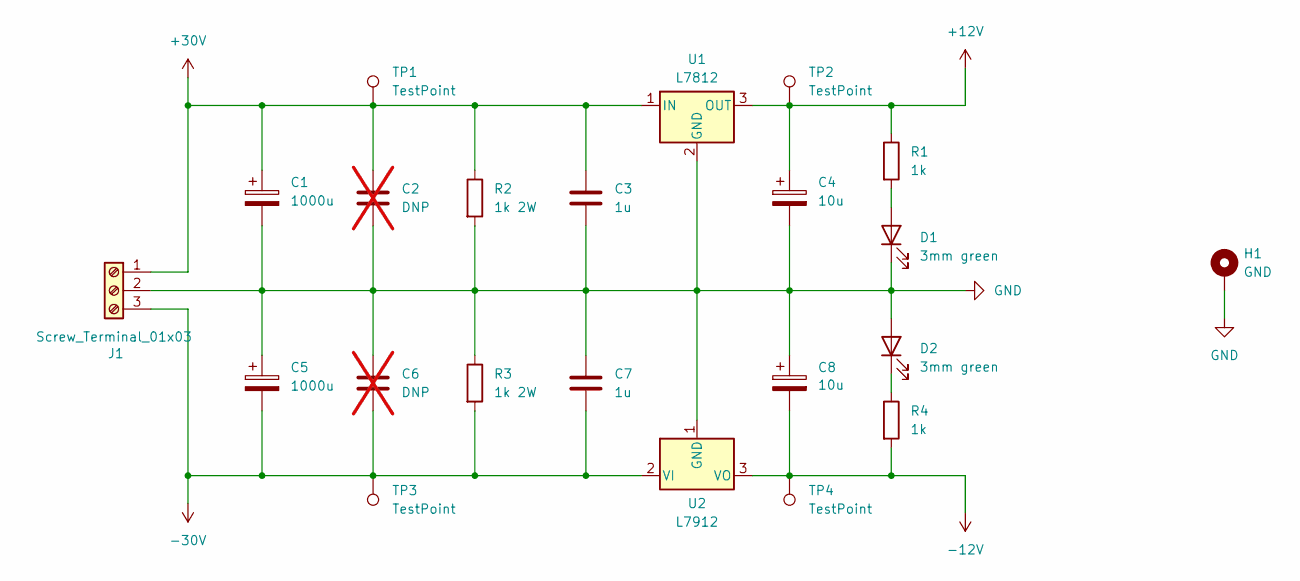
[picture p85: schematic power.kicad_sch]

Parts:
C1, C5: 1000u; CP_Radial_D16.0mm_P7.50mm
C2, C6: DNP; C_Disc_D4.3mm_W1.9mm_P5.00mm; not fitted
C3, C7: 1u; C_Rect_L7.2mm_W4.5mm_P5.00mm_FKS2_FKP2_MKS2_MKP2
C4, C8: 10u; CP_Radial_D4.0mm_P2.00mm
D1, D2: 3mm green; LED_D3.0mm
H1: GND; MountingHole_4.3mm_M4_Pad
J1: Screw_Terminal_01x03; TerminalBlock_Phoenix_MKDS-1,5-3_1x03_P5.00mm_Horizontal
R1, R4: 1k; R_Axial_DIN0207_L6.3mm_D2.5mm_P10.16mm_Horizontal
R2, R3: 1k 2W; R_Axial_DIN0411_L9.9mm_D3.6mm_P15.24mm_Horizontal
TP1, TP2, TP3, TP4: TestPoint; Pin_D1.2mm_L11.3mm_W3.0mm_Flat
U1: L7812; TO-220-3_Vertical
U2: L7912; TO-220-3_Vertical

Connections:
+12V: C4.1, R1.1, TP2.1, U1.3 (OUT); also elsewhere on the board
+30V: C1.1, C2.1, C3.1, J1.1, R2.1, TP1.1, U1.1 (IN); also elsewhere on the board
-12V: C8.2, R4.2, TP4.1, U2.3 (VO); also elsewhere on the board
-30V: C5.2, C6.2, C7.2, J1.3, R3.2, TP3.1, U2.2 (VI); also elsewhere on the board
GND: C1.2, C2.2, C3.2, C4.2, C5.1, C6.1, C7.1, C8.1, D1.1 (K), D2.2 (A), H1.1, J1.2, R2.2, R3.1, U1.2 (GND), U2.1 (GND); also elsewhere on the board
unnamed: D1.2 (A), R1.2
unnamed: D2.1 (K), R4.1

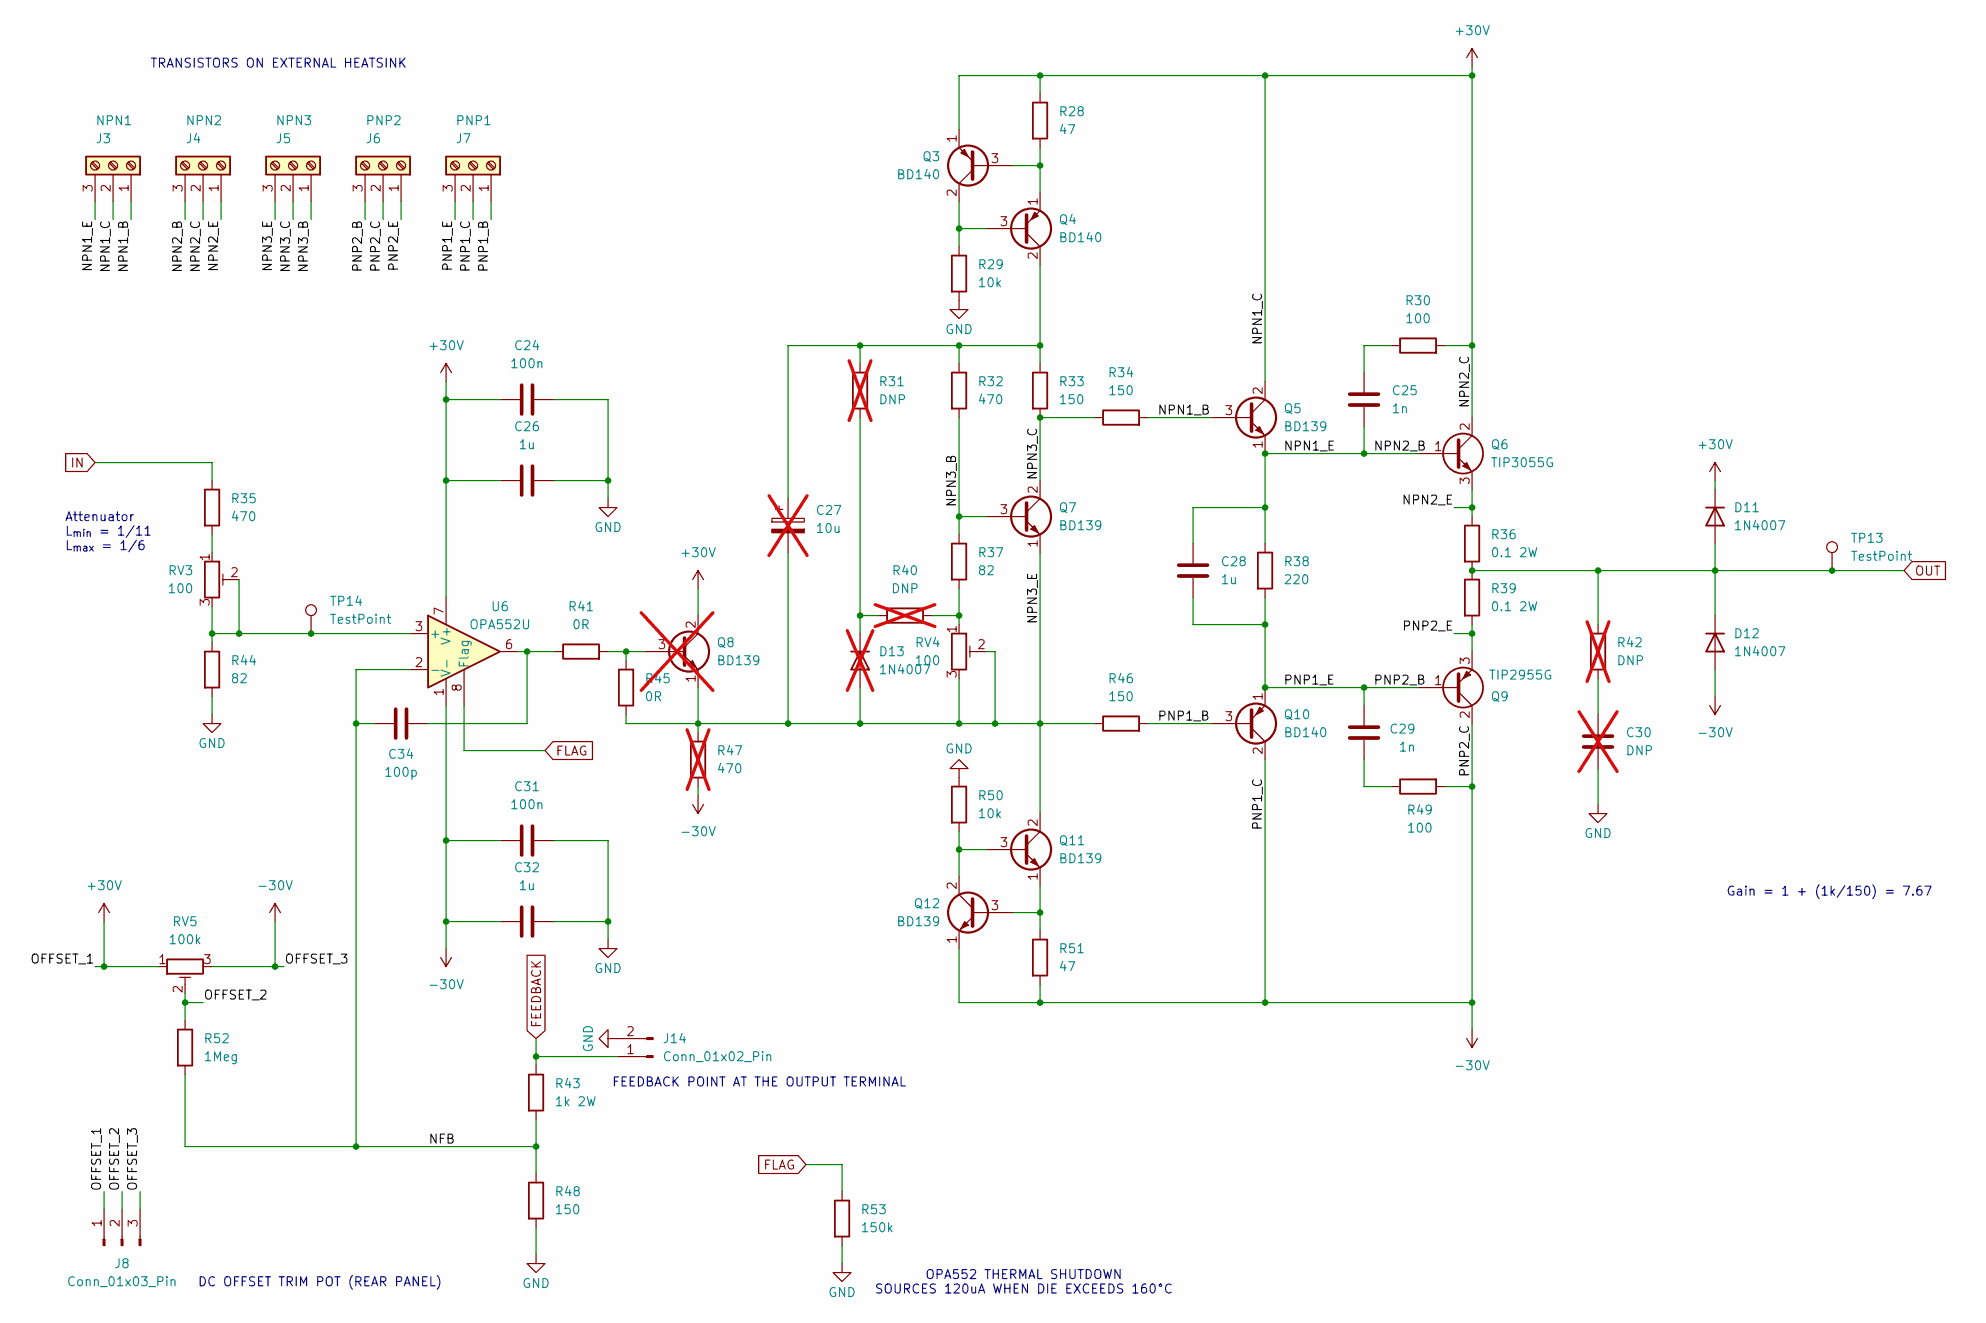
[picture p86: schematic output_stage.kicad_sch, Output stage]

Parts:
C24, C31: 100n; C_Disc_D4.3mm_W1.9mm_P5.00mm
C25, C29: 1n; C_Rect_L7.2mm_W2.5mm_P5.00mm_FKS2_FKP2_MKS2_MKP2
C26, C28, C32: 1u; C_Rect_L7.2mm_W4.5mm_P5.00mm_FKS2_FKP2_MKS2_MKP2
C27: 10u; CP_Radial_D4.0mm_P2.00mm; not fitted
C30: DNP; C_Disc_D4.3mm_W1.9mm_P5.00mm; not fitted
C34: 100p; C_Disc_D4.3mm_W1.9mm_P5.00mm
D11, D12: 1N4007; D_DO-15_P10.16mm_Horizontal
D13: 1N4007; D_DO-15_P10.16mm_Horizontal; not fitted
J3: NPN1; TerminalBlock_Phoenix_MKDS-1,5-3_1x03_P5.00mm_Horizontal
J4: NPN2; TerminalBlock_Phoenix_MKDS-1,5-3_1x03_P5.00mm_Horizontal
J5: NPN3; TerminalBlock_Phoenix_MKDS-1,5-3_1x03_P5.00mm_Horizontal
J6: PNP2; TerminalBlock_Phoenix_MKDS-1,5-3_1x03_P5.00mm_Horizontal
J7: PNP1; TerminalBlock_Phoenix_MKDS-1,5-3_1x03_P5.00mm_Horizontal
J8: Conn_01x03_Pin; JST_XH_B3B-XH-A_1x03_P2.50mm_Vertical
J14: Conn_01x02_Pin; JST_XH_B2B-XH-A_1x02_P2.50mm_Vertical
Q3, Q4: BD140; TO-126-3_Vertical
Q5, Q7: BD139; TerminalBlock_Phoenix_MKDS-1,5-3_1x03_P5.00mm_Horizontal
Q6: TIP3055G; TerminalBlock_Phoenix_MKDS-1,5-3_1x03_P5.00mm_Horizontal
Q8: BD139; TO-126-3_Vertical; not fitted
Q9: TIP2955G; TerminalBlock_Phoenix_MKDS-1,5-3_1x03_P5.00mm_Horizontal
Q10: BD140; TerminalBlock_Phoenix_MKDS-1,5-3_1x03_P5.00mm_Horizontal
Q11, Q12: BD139; TO-126-3_Vertical
R28, R51: 47; R_Axial_DIN0207_L6.3mm_D2.5mm_P10.16mm_Horizontal
R29, R50: 10k; R_Axial_DIN0207_L6.3mm_D2.5mm_P10.16mm_Horizontal
R30, R49: 100; R_Axial_DIN0207_L6.3mm_D2.5mm_P10.16mm_Horizontal
R31, R40, R42: DNP; R_Axial_DIN0207_L6.3mm_D2.5mm_P10.16mm_Horizontal; not fitted
R32, R35: 470; R_Axial_DIN0207_L6.3mm_D2.5mm_P10.16mm_Horizontal
R33, R34, R46, R48: 150; R_Axial_DIN0207_L6.3mm_D2.5mm_P10.16mm_Horizontal
R36, R39: 0.1 2W; R_Axial_DIN0516_L15.5mm_D5.0mm_P20.32mm_Horizontal
R37, R44: 82; R_Axial_DIN0207_L6.3mm_D2.5mm_P10.16mm_Horizontal
R38: 220; R_Axial_DIN0207_L6.3mm_D2.5mm_P10.16mm_Horizontal
R41, R45: 0R; R_Axial_DIN0207_L6.3mm_D2.5mm_P10.16mm_Horizontal
R43: 1k 2W; R_Axial_DIN0411_L9.9mm_D3.6mm_P15.24mm_Horizontal
R47: 470; R_Axial_DIN0207_L6.3mm_D2.5mm_P10.16mm_Horizontal; not fitted
R52: 1Meg; R_Axial_DIN0207_L6.3mm_D2.5mm_P10.16mm_Horizontal
R53: 150k; R_Axial_DIN0207_L6.3mm_D2.5mm_P10.16mm_Horizontal
RV3, RV4: 100; Potentiometer_Bourns_3296W_Vertical
RV5: 100k
TP13, TP14: TestPoint; Pin_D1.2mm_L11.3mm_W3.0mm_Flat
U6: OPA552U; SOIC-8_3.9x4.9mm_P1.27mm

Connections:
+30V: C24.1, C26.1, D11.1 (K), J3.2, J4.2, J8.1, Q3.1 (E), Q5.2 (C), Q6.2 (C), Q8.2 (C), R28.1, R30.2, RV5.1, U6.7 (V+); also elsewhere on the board
-30V: C31.1, C32.1, D12.2 (A), J6.2, J7.2, J8.3, Q9.2 (C), Q10.2 (C), Q12.1 (E), R47.1, R49.2, R51.2, RV5.3, U6.1 (V-), U6.4 (V-), U6.5 (V-); also elsewhere on the board
/Output stage/NFB: C34.1, R43.2, R48.1, R52.2, U6.2 (-)
/Output stage/NPN1_B: J3.1, Q5.3 (B), R34.2
/Output stage/NPN1_E: C25.2, C28.1, J3.3, J4.3, Q5.1 (E), Q6.1 (B), R38.1
/Output stage/NPN2_E: J4.1, Q6.3 (E), R36.1
/Output stage/NPN3_B: J5.1, Q7.3 (B), R32.2, R37.1
/Output stage/NPN3_C: J5.2, Q7.2 (C), R33.2, R34.1
/Output stage/NPN3_E: C27.2, D13.2 (A), J5.3, Q7.1 (E), Q8.1 (E), Q11.2 (C), R45.1, R46.1, R47.2, RV4.2, RV4.3
/Output stage/OFFSET_2: J8.2, R52.1, RV5.2
/Output stage/PNP1_B: J7.1, Q10.3 (B), R46.2
/Output stage/PNP1_E: C28.2, C29.2, J6.3, J7.3, Q9.1 (B), Q10.1 (E), R38.2
/Output stage/PNP2_E: J6.1, Q9.3 (E), R39.2
FEEDBACK: J14.1, R43.1
FLAG: R53.1, U6.8 (Flag); also elsewhere on the board
GND: C24.2, C26.2, C30.2, C31.2, C32.2, J14.2, R29.2, R44.2, R48.2, R50.1, R53.2; also elsewhere on the board
IN: R35.1; also elsewhere on the board
unnamed: C25.1, R30.1
unnamed: C29.1, R49.1
unnamed: C30.1, R42.2
unnamed: C34.2, R41.1, U6.6
unnamed: D13.1 (K), R31.1, R40.2
unnamed: Q3.3 (B), Q4.1 (E), R28.2
unnamed: Q3.2 (C), Q4.3 (B), R29.1
unnamed: C27.1, Q4.2 (C), R31.2, R32.1, R33.1
unnamed: Q8.3 (B), R41.2, R45.2
unnamed: Q11.3 (B), Q12.2 (C), R50.2
unnamed: Q11.1 (E), Q12.3 (B), R51.1
unnamed: R35.2, RV3.1
unnamed: R37.2, R40.1, RV4.1
unnamed: R44.1, RV3.2, RV3.3, TP14.1, U6.3 (+)
OUT: D11.2 (A), D12.1 (K), R36.2, R39.1, R42.1, TP13.1; also elsewhere on the board

Notes on the sheet:
FEEDBACK POINT AT THE OUTPUT TERMINAL
OPA552 THERMAL SHUTDOWN SOURCES 120uA WHEN DIE EXCEEDS 160°C
DC OFFSET TRIM POT (REAR PANEL)
Gain = 1 + (1k/150) = 7.67
TRANSISTORS ON EXTERNAL HEATSINK
Attenuator L_{min} = 1/11 L_{max} = 1/6

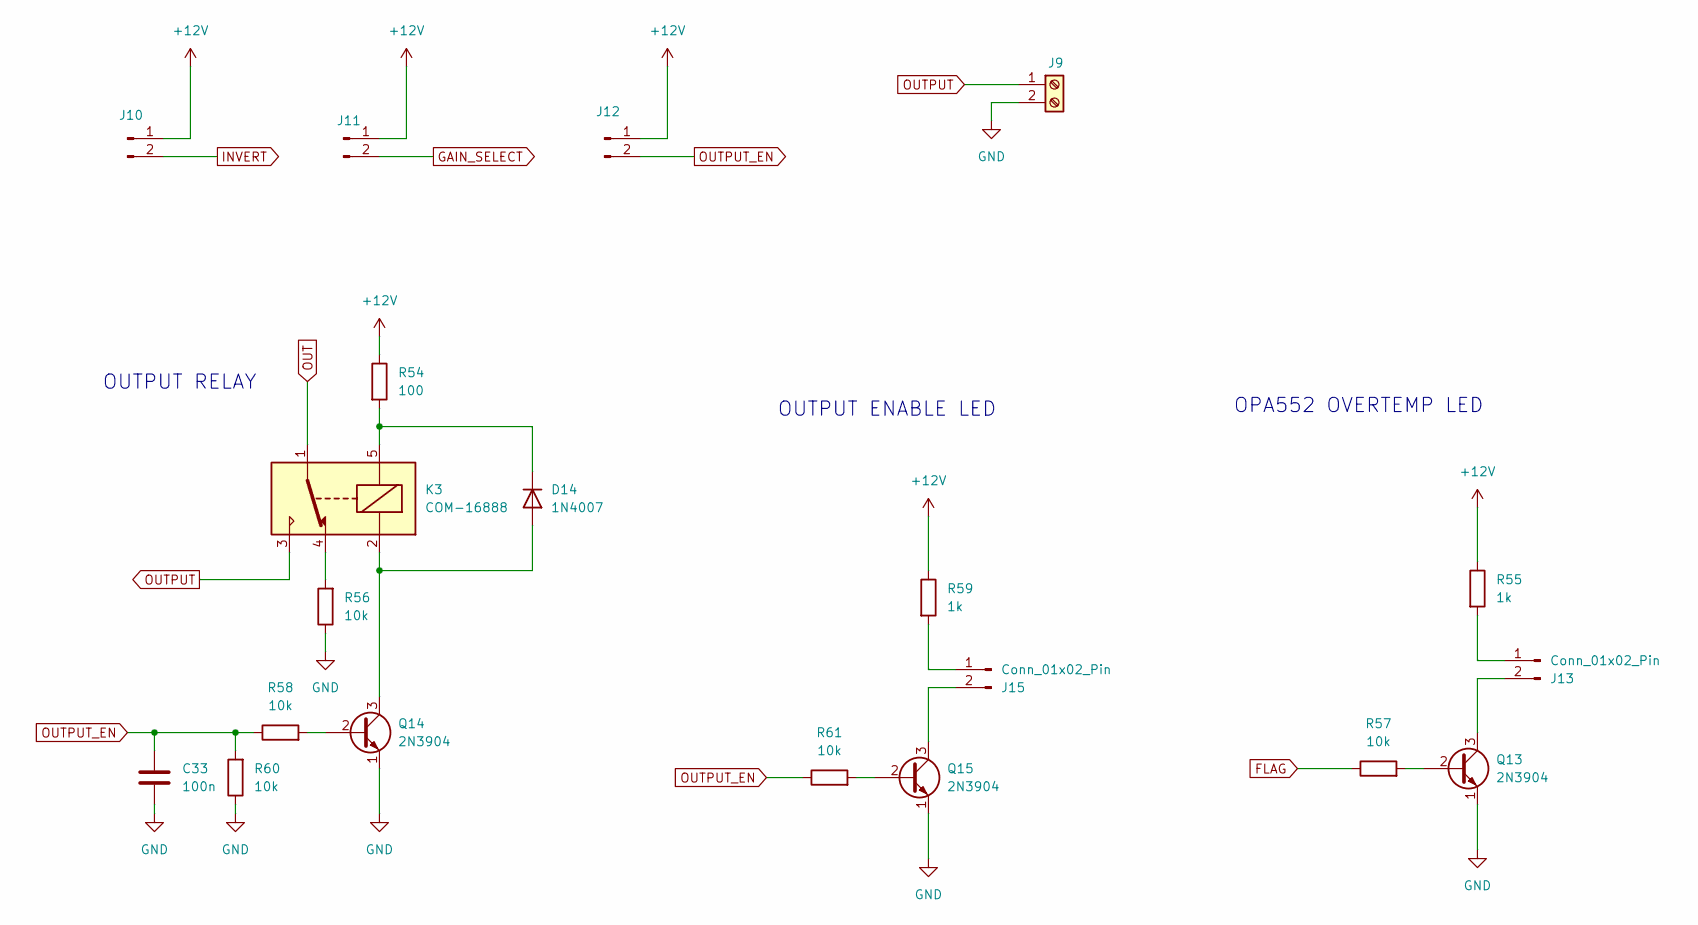
[picture p87: schematic io.kicad_sch]

Parts:
C33: 100n; C_Disc_D4.3mm_W1.9mm_P5.00mm
D14: 1N4007; D_DO-15_P10.16mm_Horizontal
J9: Screw_Terminal_01x02; TerminalBlock_Phoenix_MKDS-1,5-2-5.08_1x02_P5.08mm_Horizont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
J10, J11, J12, J13, J15: Conn_01x02_Pin; JST_XH_B2B-XH-A_1x02_P2.50mm_Vertical
K3: COM-16888; COM16888; Mouser Part Number 474-COM-16888
Q13, Q14, Q15: 2N3904; TO-92_Inline
R54: 100; R_Axial_DIN0207_L6.3mm_D2.5mm_P10.16mm_Horizontal
R55, R59: 1k; R_Axial_DIN0207_L6.3mm_D2.5mm_P10.16mm_Horizontal
R56, R57, R58, R60, R61: 10k; R_Axial_DIN0207_L6.3mm_D2.5mm_P10.16mm_Horizontal

Connections:
+12V: J10.1, J11.1, J12.1, R54.1, R55.1, R59.1; also elsewhere on the board
FLAG: R57.1; also elsewhere on the board
GAIN_SELECT: J11.2; also elsewhere on the board
GND: C33.2, J9.2, Q13.1 (E), Q14.1 (E), Q15.1 (E), R56.1, R60.1; also elsewhere on the board
INVERT: J10.2; also elsewhere on the board
unnamed: D14.2 (A), K3.2 (COIL_1), Q14.3 (C)
unnamed: D14.1 (K), K3.5 (COIL_2), R54.2
unnamed: J13.1, R55.2
unnamed: J13.2, Q13.3 (C)
unnamed: J15.1, R59.2
unnamed: J15.2, Q15.3 (C)
unnamed: K3.4 (NC), R56.2
unnamed: Q13.2 (B), R57.2
unnamed: Q14.2 (B), R58.2
unnamed: Q15.2 (B), R61.2
OUT: K3.1 (COM); also elsewhere on the board
OUTPUT: J9.1, K3.3 (NO)
OUTPUT_EN: C33.1, J12.2, R58.1, R60.2, R61.1

Notes on the sheet:
OPA552 OVERTEMP LED
OUTPUT RELAY
OUTPUT ENABLE LED

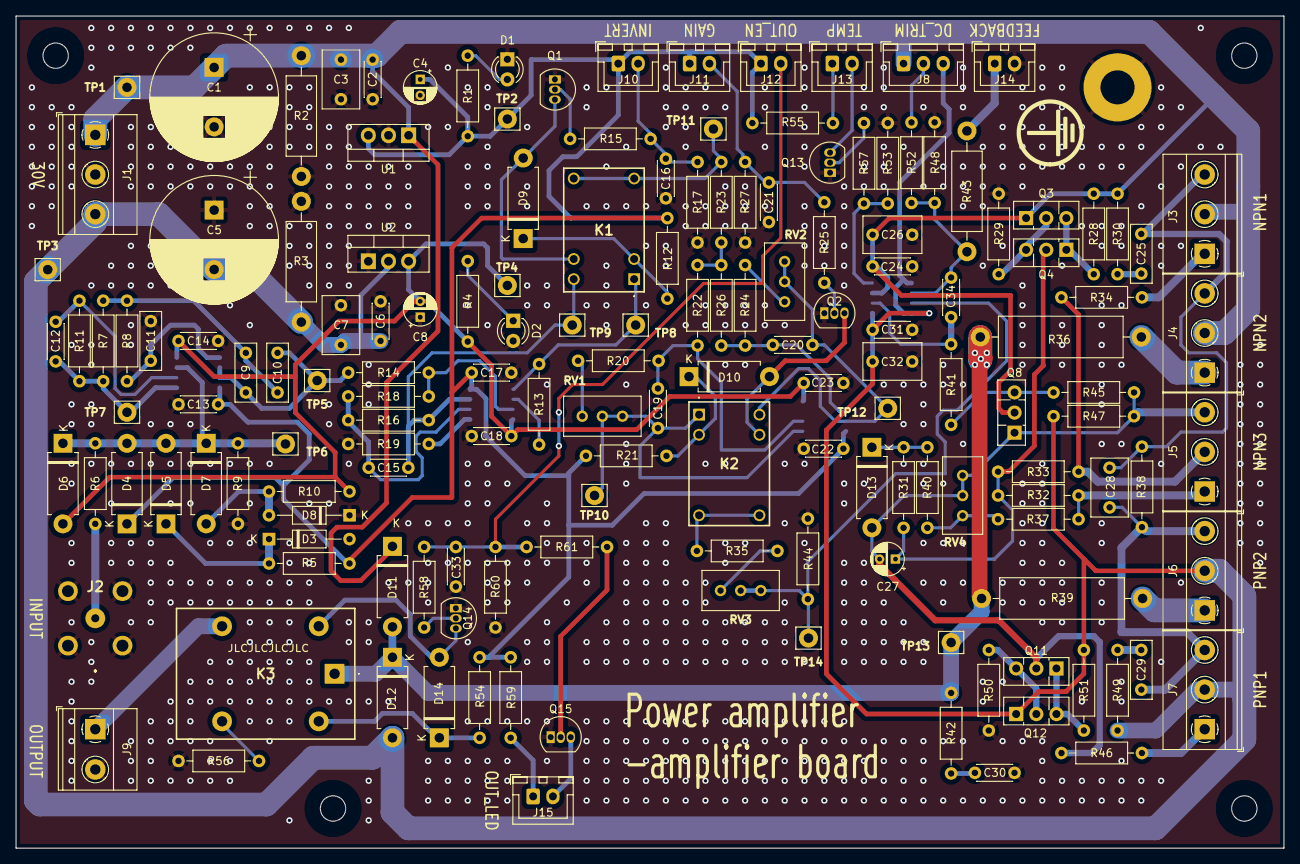
[picture p88: board Amplifier.kicad_pcb from above]

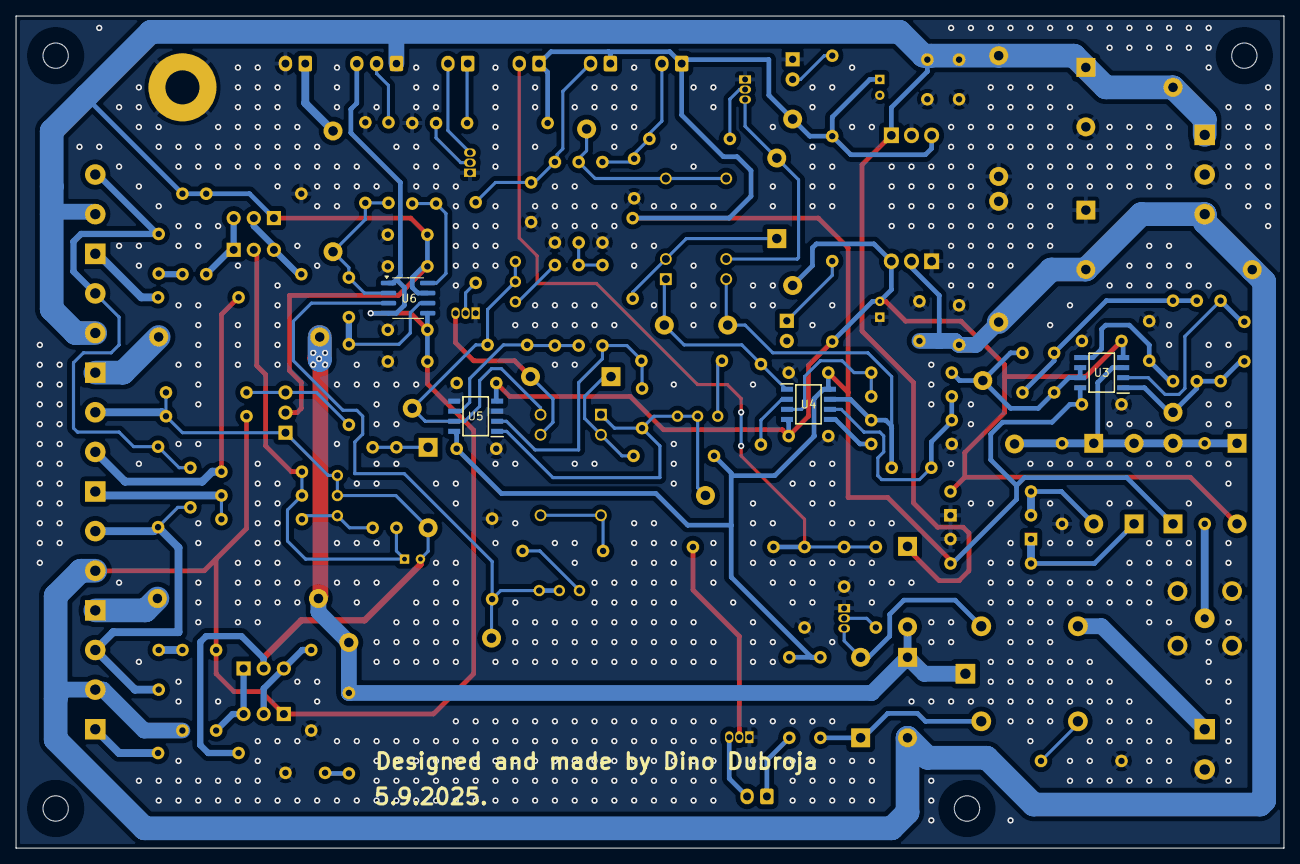
[picture p89: board Amplifier.kicad_pcb from below]

Board: 2 copper layers, 160.0 x 105.0 mm, 162 parts (4 on the bottom side), 79 nets.
