DinoDubroja/Power-amplifier/PCB/Busbar v2/Busbar/Busbar.kicad_pcb

## KiCad design PCB/Busbar v2/Busbar/Busbar.kicad_pcb (2025-10-12)

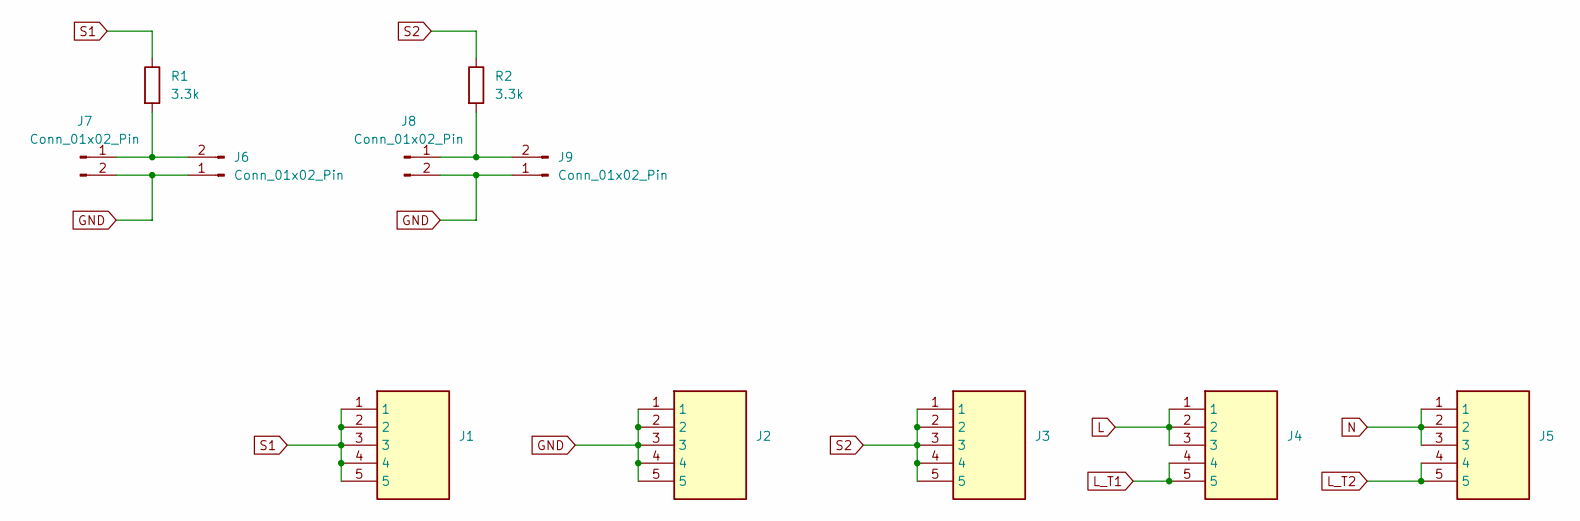
[picture p90: schematic Busbar.kicad_sch]

Parts:
J1, J2, J3, J4, J5: 4DB-P108-05; 4DBP10805; Mouser Part Number 571-214376678
J6, J7, J8, J9: Conn_01x02_Pin; JST_XH_S2B-XH-A-1_1x02_P2.50mm_Horizontal
R1, R2: 3.3k; R_Axial_DIN0207_L6.3mm_D2.5mm_P10.16mm_Horizontal

Connections:
GND: J2.1, J2.2, J2.3, J2.4, J2.5, J6.1, J7.2, J8.2, J9.1
L: J4.1, J4.2, J4.3
L_T1: J4.4, J4.5
L_T2: J5.4, J5.5
N: J5.1, J5.2, J5.3
unnamed: J6.2, J7.1, R1.2
unnamed: J8.1, J9.2, R2.2
S1: J1.1, J1.2, J1.3, J1.4, J1.5, R1.1
S2: J3.1, J3.2, J3.3, J3.4, J3.5, R2.1

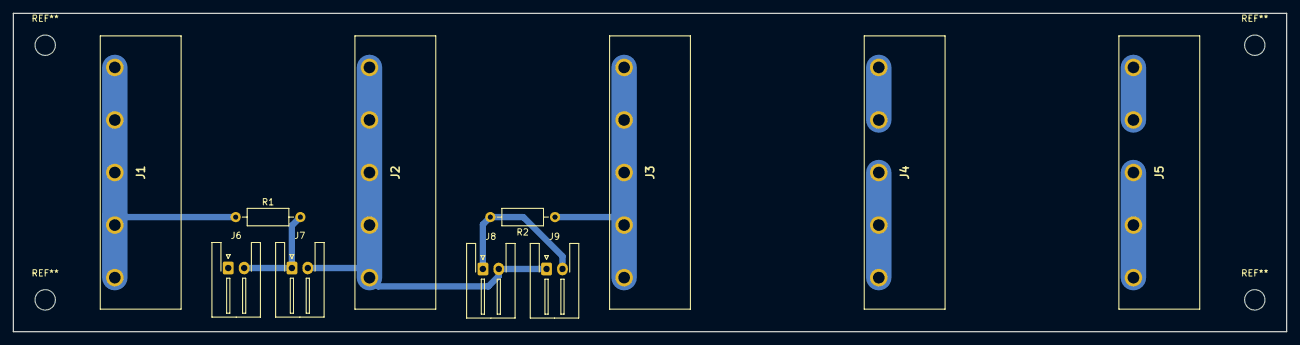
[picture p91: board Busbar.kicad_pcb from above]

Board: 2 copper layers, 200.0 x 50.0 mm, 11 parts (0 on the bottom side), 9 nets.
