DinoDubroja/Power-amplifier/PCB/Power supply/Power supply/Power supply.kicad_pcb

## KiCad design PCB/Power supply/Power supply/Power supply.kicad_pcb (2025-08-28)

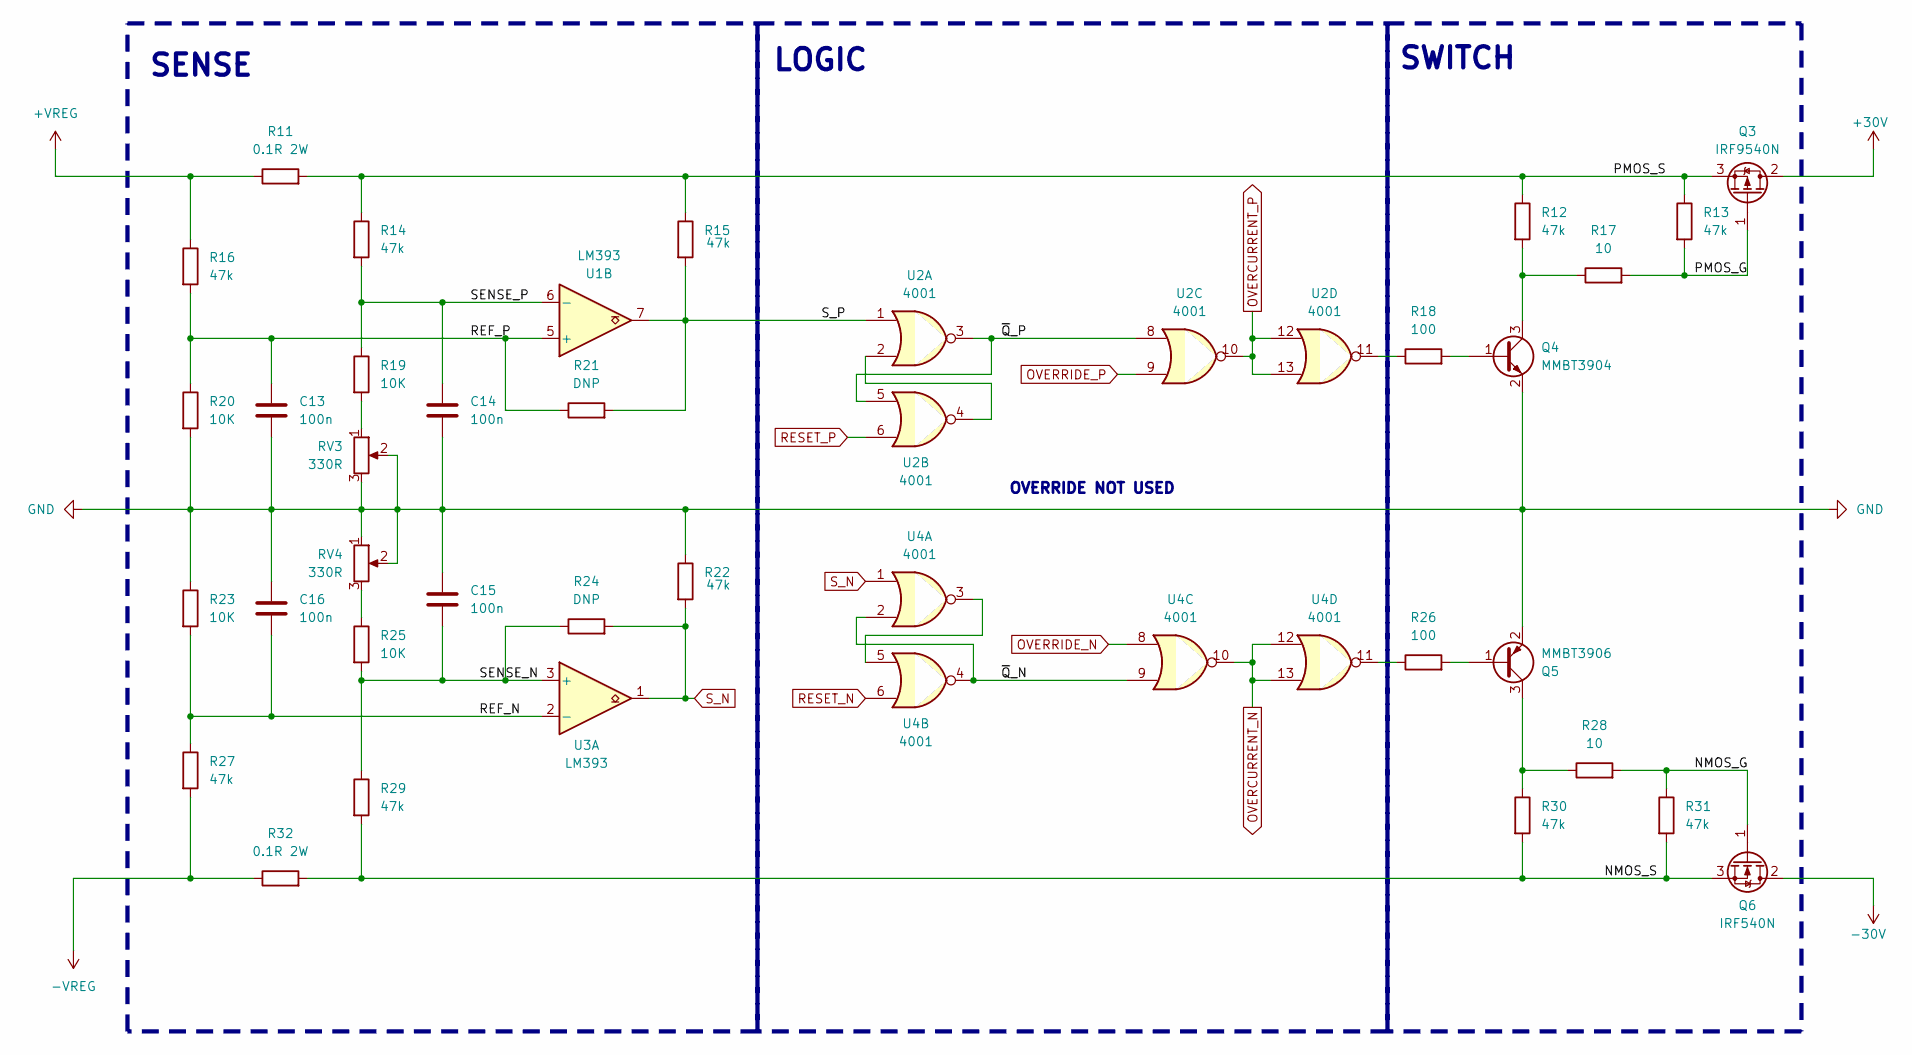
[picture p92: schematic over current.kicad_sch, Over-current protection]

Parts:
C13, C14, C15, C16: 100n; C_Rect_L7.0mm_W2.5mm_P5.00mm
Q3: IRF9540N; TO-220-3_Vertical
Q4: MMBT3904; SOT-23
Q5: MMBT3906; SOT-23
Q6: IRF540N; TO-220-3_Vertical
R11, R32: 0.1R 2W; R_Axial_DIN0309_L9.0mm_D3.2mm_P20.32mm_Horizontal
R12, R13, R14, R15, R16, R22, R27, R29, R30, R31: 47k; R_Axial_DIN0207_L6.3mm_D2.5mm_P10.16mm_Horizontal
R17, R28: 10; R_Axial_DIN0207_L6.3mm_D2.5mm_P10.16mm_Horizontal
R18, R26: 100; R_Axial_DIN0207_L6.3mm_D2.5mm_P10.16mm_Horizontal
R19, R20, R23, R25: 10K; R_Axial_DIN0207_L6.3mm_D2.5mm_P10.16mm_Horizontal
R21, R24: DNP; R_Axial_DIN0207_L6.3mm_D2.5mm_P10.16mm_Horizontal
RV3, RV4: 330R; Potentiometer_Bourns_3296W_Vertical
U1, U3: LM393; SOIC-8_3.9x4.9mm_P1.27mm
U2, U4: 4001; SOIC127P600X175-14N

Connections:
+30V: Q3.2 (D); also elsewhere on the board
+VREG: R11.1, R16.1; also elsewhere on the board
-30V: Q6.2 (D); also elsewhere on the board
-VREG: R27.2, R32.1; also elsewhere on the board
/Over-current/NMOS_G: Q6.1 (G), R28.2, R31.1
/Over-current/NMOS_S: Q6.3 (S), R29.2, R30.2, R31.2, R32.2
/Over-current/PMOS_G: Q3.1 (G), R13.2, R17.2
/Over-current/PMOS_S: Q3.3 (S), R11.2, R12.1, R13.1, R14.1, R15.1
/Over-current/REF_N: C16.2, R23.2, R27.1, U3.2 (-)
/Over-current/REF_P: C13.1, R16.2, R20.1, R21.1, U1.5 (+)
/Over-current/SENSE_N: C15.2, R24.1, R25.2, R29.1, U3.3 (+)
/Over-current/SENSE_P: C14.1, R14.2, R19.1, U1.6 (-)
/Over-current/S_P: R15.2, R21.2, U1.7, U2.1
/Over-current/~Q_N: U4.2, U4.4, U4.9
/Over-current/~Q_P: U2.3, U2.5, U2.8
GND: C13.2, C14.2, C15.1, C16.1, Q4.2 (E), Q5.2 (E), R20.2, R22.1, R23.1, RV3.2, RV3.3, RV4.1, RV4.2; also elsewhere on the board
unnamed: Q4.1 (B), R18.2
unnamed: Q4.3 (C), R12.2, R17.1
unnamed: Q5.1 (B), R26.2
unnamed: Q5.3 (C), R28.1, R30.1
unnamed: R18.1, U2.11
unnamed: R19.2, RV3.1
unnamed: R25.1, RV4.3
unnamed: R26.1, U4.11
unnamed: U2.2, U2.4
unnamed: U4.3, U4.5
OVERCURRENT_N: U4.10, U4.12, U4.13; also elsewhere on the board
OVERCURRENT_P: U2.10, U2.12, U2.13; also elsewhere on the board
OVERRIDE_N: U4.8; also elsewhere on the board
OVERRIDE_P: U2.9; also elsewhere on the board
RESET_N: U4.6; also elsewhere on the board
RESET_P: U2.6; also elsewhere on the board
S_N: R22.2, R24.2, U3.1, U4.1

Notes on the sheet:
SENSE
LOGIC
OVERRIDE NOT USED
SWITCH

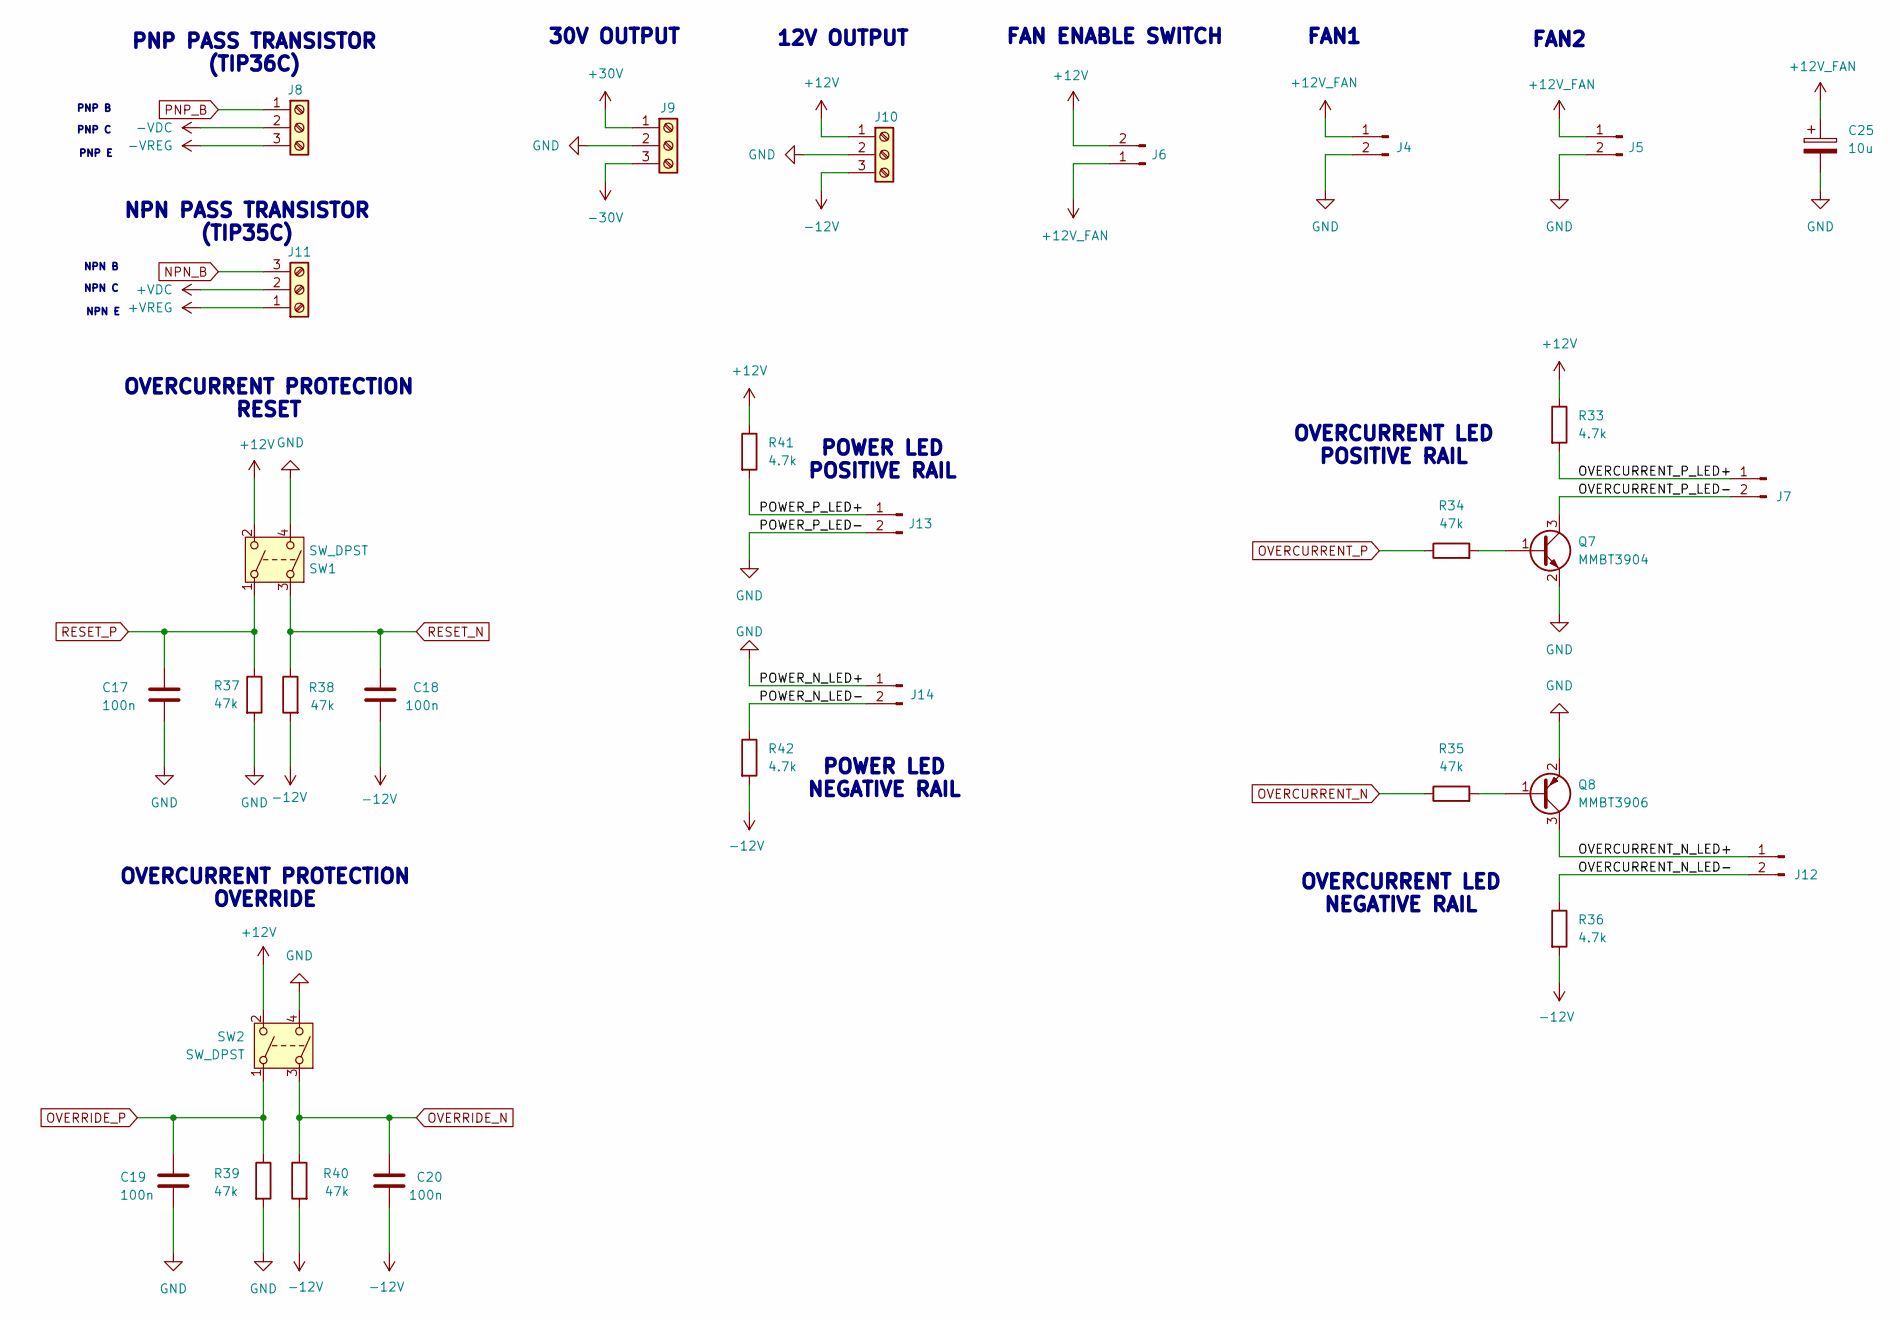
[picture p93: schematic IO.kicad_sch, Input output - 1]

Parts:
C17, C18, C19, C20: 100n; C_Rect_L7.0mm_W2.5mm_P5.00mm
C25: 10u; CP_Radial_D4.0mm_P2.00mm
J4, J5, J6, J7, J12, J13, J14: Conn_01x02_Pin; JST_XH_B2B-XH-A_1x02_P2.50mm_Vertical
J8, J9, J10, J11: Screw_Terminal_01x03; TerminalBlock_Phoenix_MKDS-1,5-3-5.08_1x03_P5.08mm_Horizont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
Q7: MMBT3904; SOT-23
Q8: MMBT3906; SOT-23
R33, R36, R41, R42: 4.7k; R_Axial_DIN0207_L6.3mm_D2.5mm_P10.16mm_Horizontal
R34, R35, R37, R38, R39, R40: 47k; R_Axial_DIN0207_L6.3mm_D2.5mm_P10.16mm_Horizontal
SW1, SW2: SW_DPST; JST_XH_B4B-XH-A_1x04_P2.50mm_Vertical

Connections:
+12V: J6.2, J10.1, R33.1, R41.1, SW1.2, SW2.2; also elsewhere on the board
+12V_FAN: C25.1, J4.1, J5.1, J6.1
+30V: J9.1; also elsewhere on the board
+VDC: J11.2; also elsewhere on the board
+VREG: J11.1; also elsewhere on the board
-12V: C18.2, C20.2, J10.3, R36.2, R38.2, R40.2, R42.2; also elsewhere on the board
-30V: J9.3; also elsewhere on the board
-VDC: J8.2; also elsewhere on the board
-VREG: J8.3; also elsewhere on the board
/IO/OVERCURRENT_N_LED+: J12.1, Q8.3 (C)
/IO/OVERCURRENT_N_LED-: J12.2, R36.1
/IO/OVERCURRENT_P_LED+: J7.1, R33.2
/IO/OVERCURRENT_P_LED-: J7.2, Q7.3 (C)
/IO/POWER_N_LED-: J14.2, R42.1
/IO/POWER_P_LED+: J13.1, R41.2
GND: C17.2, C19.2, C25.2, J4.2, J5.2, J9.2, J10.2, J13.2, J14.1, Q7.2 (E), Q8.2 (E), R37.2, R39.2, SW1.4, SW2.4; also elsewhere on the board
NPN_B: J11.3; also elsewhere on the board
unnamed: Q7.1 (B), R34.2
unnamed: Q8.1 (B), R35.2
OVERCURRENT_N: R35.1; also elsewhere on the board
OVERCURRENT_P: R34.1; also elsewhere on the board
OVERRIDE_N: C20.1, R40.1, SW2.3; also elsewhere on the board
OVERRIDE_P: C19.1, R39.1, SW2.1; also elsewhere on the board
PNP_B: J8.1; also elsewhere on the board
RESET_N: C18.1, R38.1, SW1.3; also elsewhere on the board
RESET_P: C17.1, R37.1, SW1.1; also elsewhere on the board

Notes on the sheet:
OVERCURRENT LED NEGATIVE RAIL
FAN2
NPN C
PNP PASS TRANSISTOR (TIP36C)
FAN ENABLE SWITCH
30V OUTPUT
PNP C
POWER LED NEGATIVE RAIL
OVERCURRENT PROTECTION RESET
POWER LED POSITIVE RAIL
12V OUTPUT
NPN PASS TRANSISTOR (TIP35C)
OVERCURRENT PROTECTION OVERRIDE
PNP E
PNP B
OVERCURRENT LED POSITIVE RAIL
FAN1
NPN E
NPN B

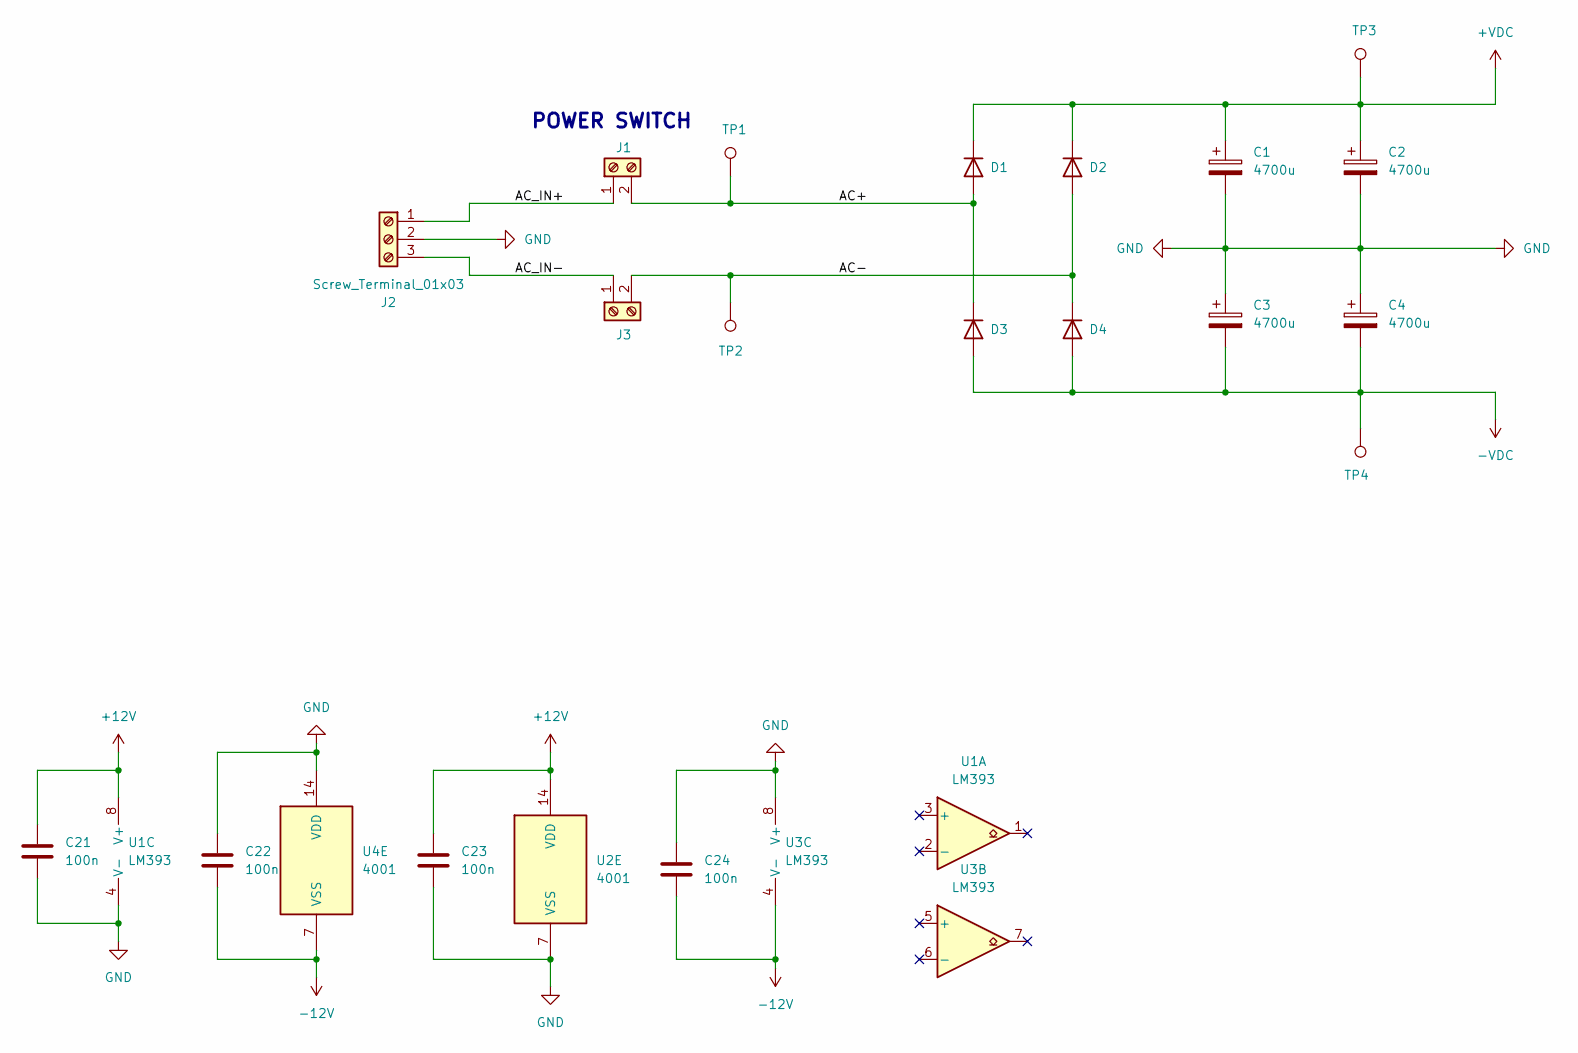
[picture p94: schematic Rectifier.sch.kicad_sch, Rectifier]

Parts:
C1, C2, C3, C4: 4700u; CP_Radial_D22.0mm_P10.00mm_SnapIn
C21, C22, C23, C24: 100n; C_Rect_L7.0mm_W2.5mm_P5.00mm
D1, D2, D3, D4: FERD20H100STS; TO254P483X1010X2035-3P; Mouser Part Number 511-FERD20H100STS
J1, J3: Screw_Terminal_01x02; TerminalBlock_Phoenix_MKDS-1,5-2-5.08_1x02_P5.08mm_Horizont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
J2: Screw_Terminal_01x03; TerminalBlock_Phoenix_MKDS-1,5-3-5.08_1x03_P5.08mm_Horizont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
TP1, TP2, TP3, TP4: Pin_D1.3mm_L10.0mm_W3.5mm_Flat
U1, U3: LM393; SOIC-8_3.9x4.9mm_P1.27mm
U2, U4: 4001; SOIC127P600X175-14N

Connections:
+12V: C21.1, C23.1, U1.8 (V+), U2.14 (VDD); also elsewhere on the board
+VDC: C1.1, C2.1, D1.2 (K), D2.2 (K), TP3.1; also elsewhere on the board
-12V: C22.2, C24.2, U3.4 (V-), U4.7 (VSS); also elsewhere on the board
-VDC: C3.2, C4.2, D3.1 (A), D3.3 (A), D4.1 (A), D4.3 (A), TP4.1; also elsewhere on the board
/Rectifier/AC+: D1.1 (A), D1.3 (A), D3.2 (K), J1.2, TP1.1
/Rectifier/AC-: D2.1 (A), D2.3 (A), D4.2 (K), J3.2, TP2.1
/Rectifier/AC_IN+: J1.1, J2.1
/Rectifier/AC_IN-: J2.3, J3.1
GND: C1.2, C2.2, C3.1, C4.1, C21.2, C22.1, C23.2, C24.1, J2.2, U1.4 (V-), U2.7 (VSS), U3.8 (V+), U4.14 (VDD); also elsewhere on the board

Notes on the sheet:
POWER SWITCH

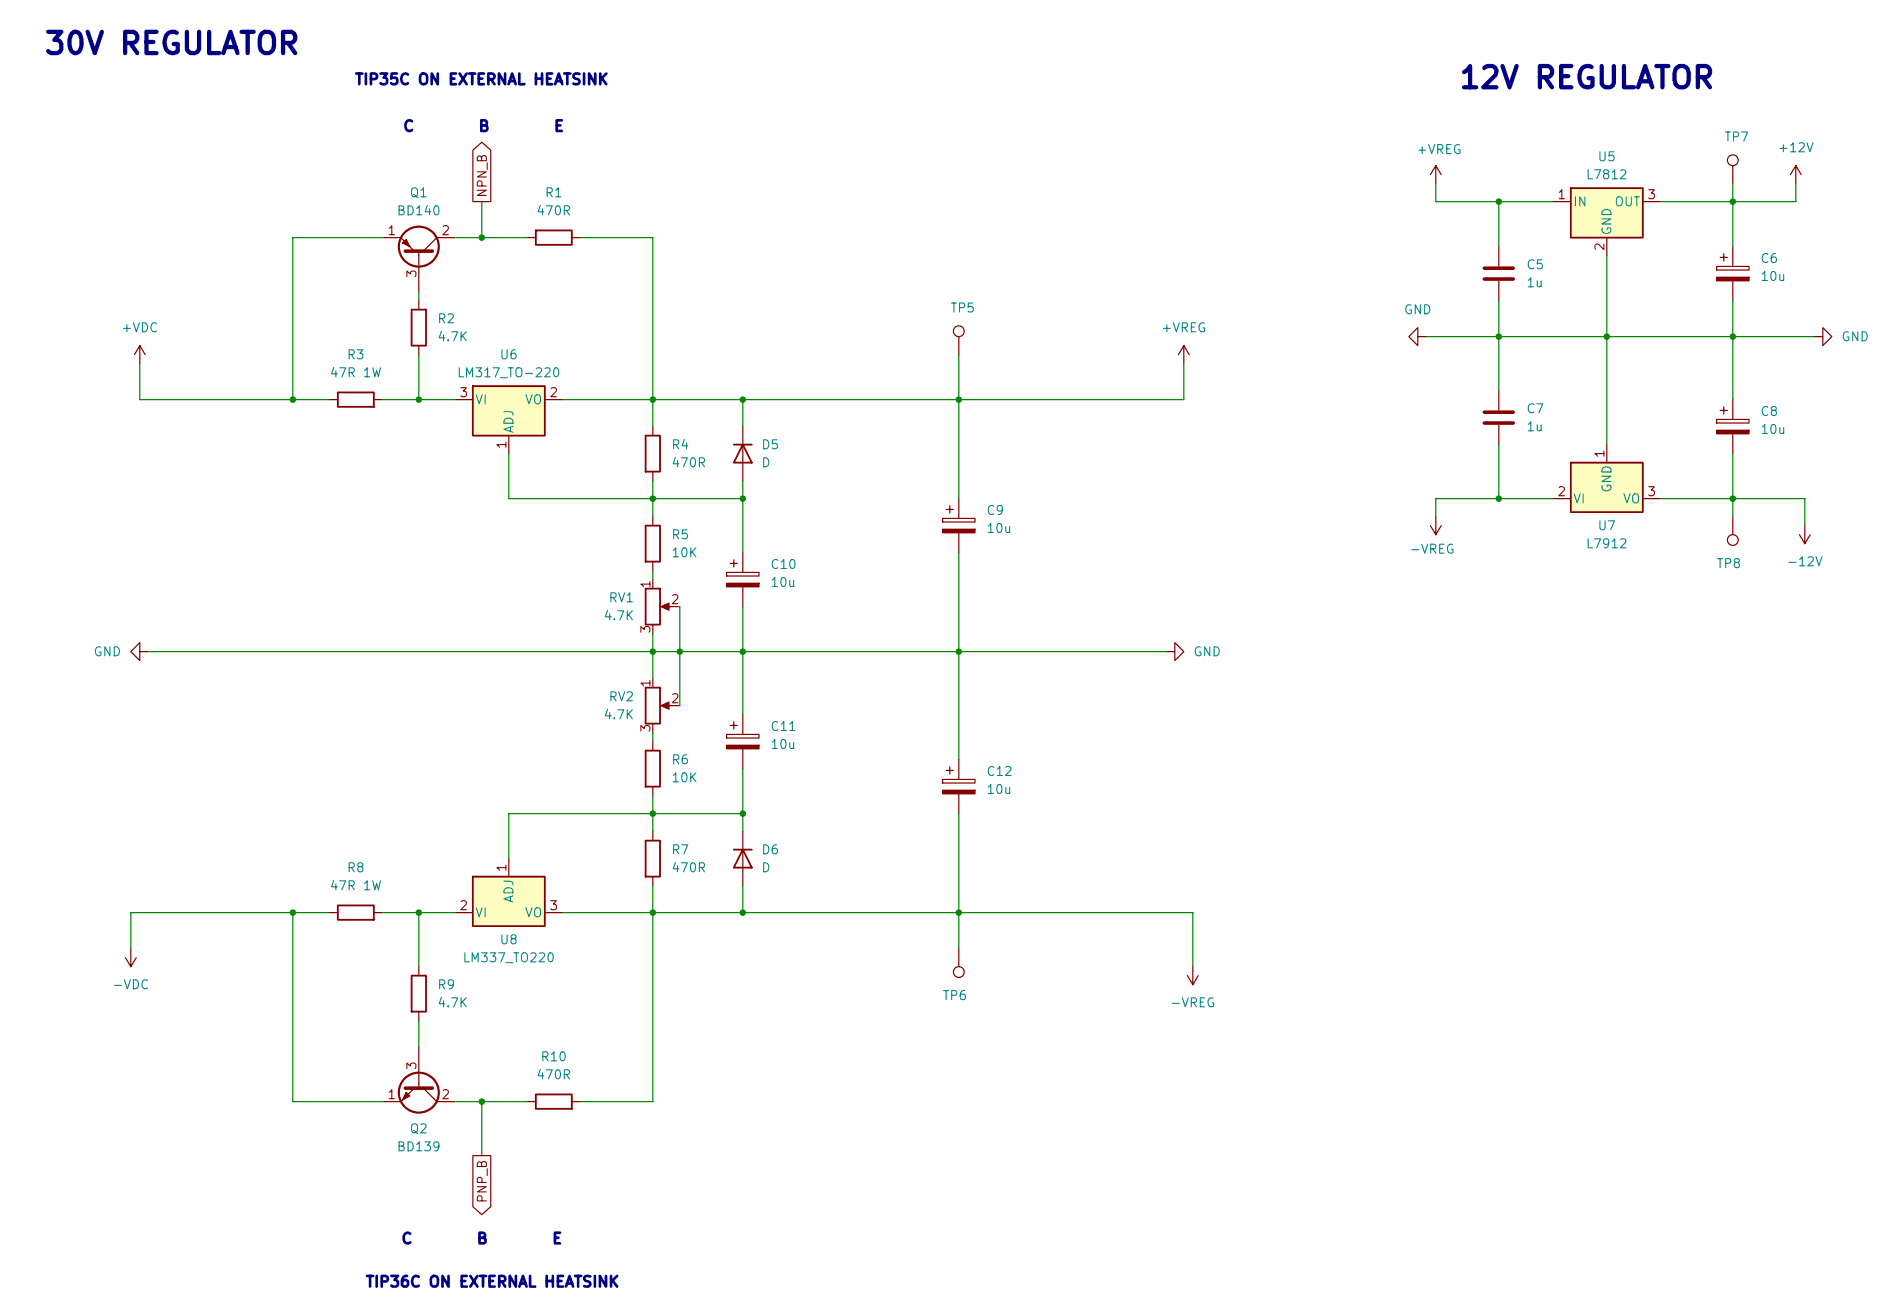
[picture p95: schematic untitled.kicad_sch, Regulator]

Parts:
C5, C7: 1u; C_Rect_L7.0mm_W6.0mm_P5.00mm
C6, C8, C9, C10, C11, C12: 10u; CP_Radial_D4.0mm_P2.00mm
D5, D6: D; D_A-405_P10.16mm_Horizontal
Q1: BD140; TO-126-3_Vertical
Q2: BD139; TO-126-3_Vertical
R1, R4, R7, R10: 470R; R_Axial_DIN0207_L6.3mm_D2.5mm_P10.16mm_Horizontal
R2, R9: 4.7K; R_Axial_DIN0207_L6.3mm_D2.5mm_P10.16mm_Horizontal
R3, R8: 47R 1W; R_Axial_DIN0207_L6.3mm_D2.5mm_P15.24mm_Horizontal
R5, R6: 10K; R_Axial_DIN0207_L6.3mm_D2.5mm_P10.16mm_Horizontal
RV1, RV2: 4.7K; Potentiometer_Bourns_3296W_Vertical
TP5, TP6, TP7, TP8: Pin_D1.3mm_L10.0mm_W3.5mm_Flat
U5: L7812; TO-220-3_Vertical
U6: LM317_TO-220; TO-220-3_Vertical
U7: L7912; TO-220-3_Vertical
U8: LM337_TO220; TO-220-3_Vertical

Connections:
+12V: C6.1, TP7.1, U5.3 (OUT); also elsewhere on the board
+VDC: Q1.1 (E), R3.1; also elsewhere on the board
+VREG: C5.1, C9.1, D5.1 (K), R1.1, R4.1, TP5.1, U5.1 (IN), U6.2 (VO); also elsewhere on the board
-12V: C8.2, TP8.1, U7.3 (VO); also elsewhere on the board
-VDC: Q2.1 (E), R8.1; also elsewhere on the board
-VREG: C7.2, C12.2, D6.2 (A), R7.2, R10.2, TP6.1, U7.2 (VI), U8.3 (VO); also elsewhere on the board
GND: C5.2, C6.2, C7.1, C8.1, C9.2, C10.2, C11.1, C12.1, RV1.2, RV1.3, RV2.1, RV2.2, U5.2 (GND), U7.1 (GND); also elsewhere on the board
NPN_B: Q1.2 (C), R1.2; also elsewhere on the board
unnamed: C10.1, D5.2 (A), R4.2, R5.1, U6.1 (ADJ)
unnamed: C11.2, D6.1 (K), R6.2, R7.1, U8.1 (ADJ)
unnamed: Q1.3 (B), R2.2
unnamed: Q2.3 (B), R9.2
unnamed: R5.2, RV1.1
unnamed: R6.1, RV2.3
unnamed: R2.1, R3.2, U6.3 (VI)
unnamed: R8.2, R9.1, U8.2 (VI)
PNP_B: Q2.2 (C), R10.1; also elsewhere on the board

Notes on the sheet:
C B E
TIP36C ON EXTERNAL HEATSINK
TIP35C ON EXTERNAL HEATSINK
30V REGULATOR
12V REGULATOR

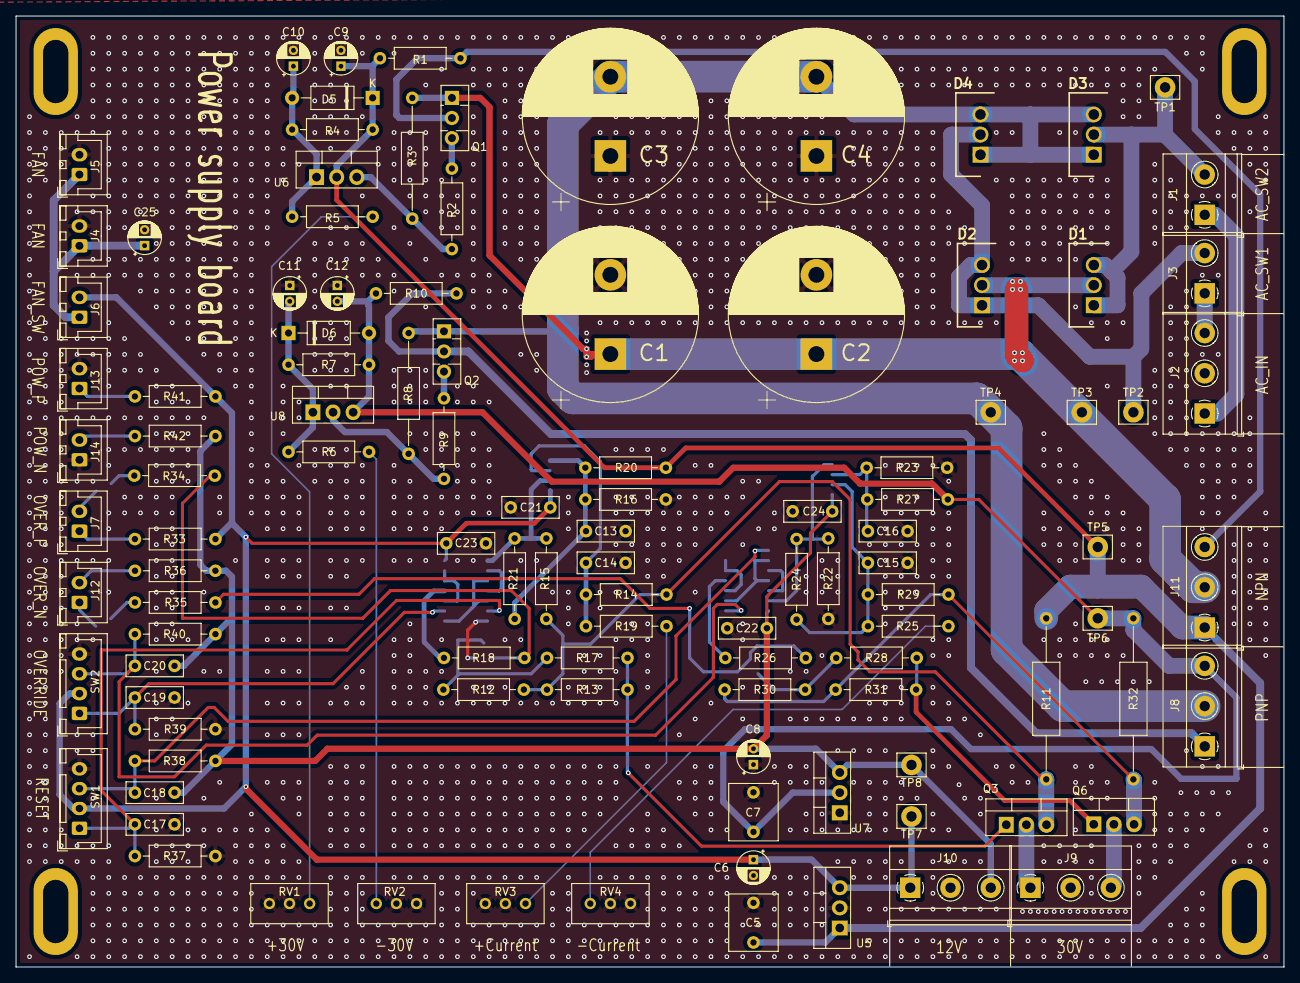
[picture p96: board Power supply.kicad_pcb from above]

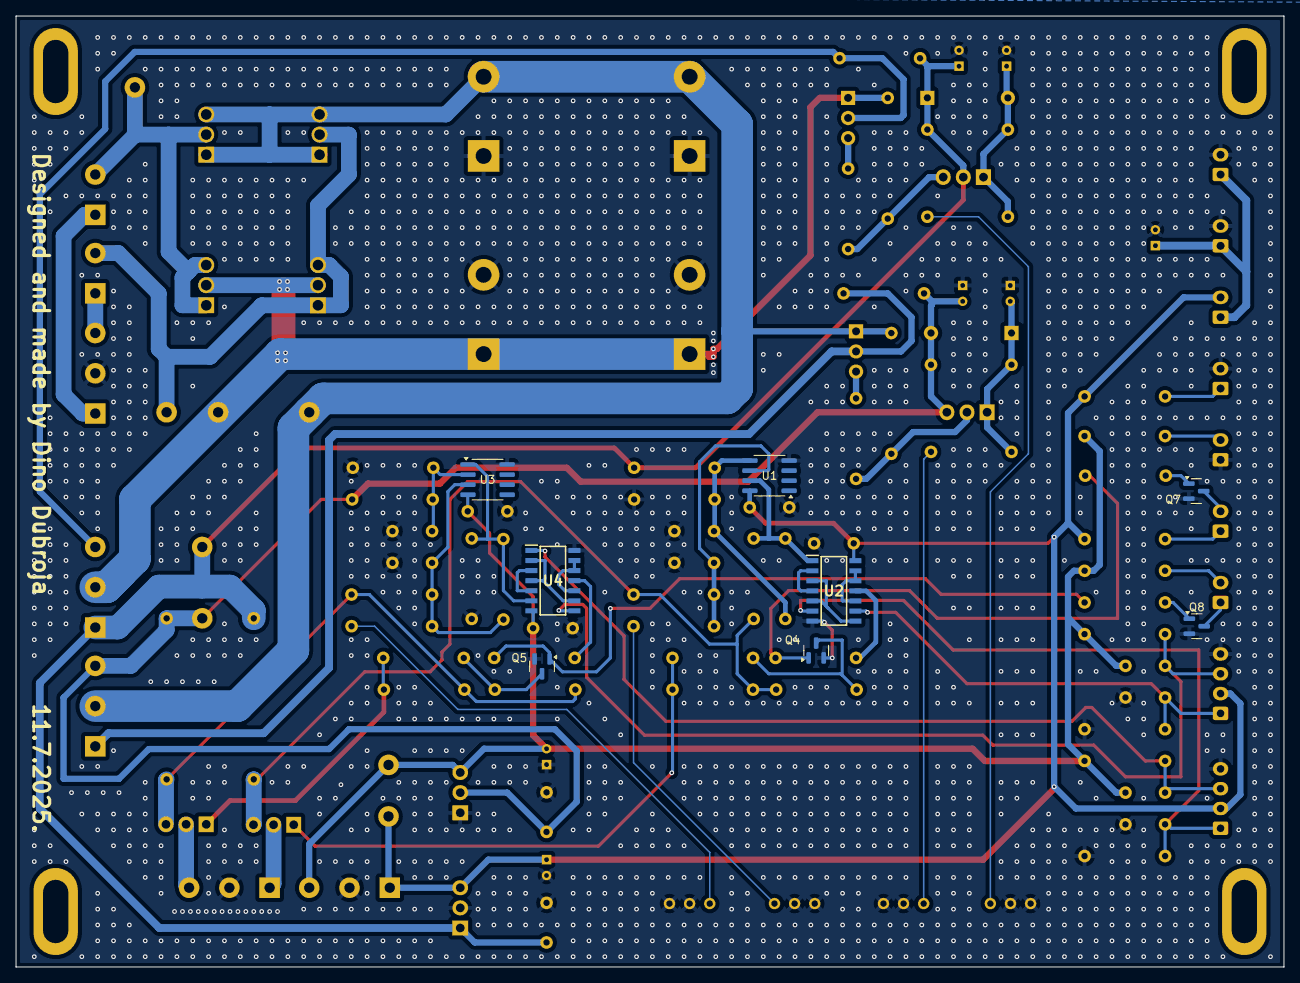
[picture p97: board Power supply.kicad_pcb from below]

Board: 2 copper layers, 160.0 x 120.0 mm, 117 parts (8 on the bottom side), 60 nets.
