DinoDubroja/Power-amplifier/(commit log)

2025-07-14 Project files uploaded (start)
    [Amplifier.kicad_pcb, Amplifier.kicad_sch, Calculations.xlsx, Class AB test PCB.kicad_pcb, Class AB test PCB.kicad_sch, Class B test PCB.kicad_pcb, Class B test PCB.kicad_sch, Corner.3mf]
2025-07-14 Minor changes to PCB design
    [Power supply.kicad_pcb]
2025-07-22 Worked on simulations (ouput stage)
    [OPA55x.OLB, OPA55x_Test_Circuit.DSN, OPA55x_Test_Circuit.OPJ, over current.kicad_sch]
2025-07-29 Added new simulations and datasheets
    [082.01001.00-RSI.stp, 40x40x10 DC Fan.STEP, AC busbar.kicad_pcb, AC busbar.kicad_sch, Power supply.kicad_pcb]
2025-07-30 Added datasheets and step files. Added "Amplifier BODE" folder
    [2GK51-73.stp]
2025-08-08 Made Power Supply schematic prettier
    [IO.kicad_sch, Rectifier.sch.kicad_sch, over current.kicad_sch, untitled.kicad_sch]
2025-08-28 Did some simulations, fixed some mistakes in PSU schematic
    [Power supply.kicad_pcb, fan holder.3mf, over current.kicad_sch, untitled.kicad_sch]
2025-08-28 Added and worked on "Amplifier" KiCAD project
    [Amplifier.kicad_pcb, Amplifier.kicad_sch, gain_stage.kicad_sch, input_stage.kicad_sch, invert_stage.kicad_sch, output_stage.kicad_sch, power.kicad_sch]
2025-08-29 Worked on "amplifier" schematic
    [Amplifier.kicad_sch, gain_stage.kicad_sch, input_stage.kicad_sch, invert_stage.kicad_sch, output_stage.kicad_sch, power.kicad_sch]
2025-08-29 Worked on amplifier schematic
    [gain_stage.kicad_sch, input_stage.kicad_sch, invert_stage.kicad_sch, output_stage.kicad_sch]
2025-10-12 Big commit after a long time :)
    [031-203-RFX.stp, 082.01001.00-RSI.stp, 1401K - Bottom Cover.igs, 1401K - Bottom Cover.stp, 1401K - Bracket.igs, 1401K - Bracket.stp, 1401K - End Panel.igs, 1401K - End Panel.stp]
